saikoushiknalubola/firedamp-fd1/electronics/kicad/drc_report.txt

** Drc report for /home/claude/fd/repo/electronics/kicad/fd1_controller.kicad_pcb **
** Created on 2026-10-22 12:19:34 **

** Found 0 DRC violations **

** Found 0 unconnected pads **

** Found 0 Footprint errors **

** End of Report **
