saikoushiknalubola/firedamp-fd1/deck/Firedamp_Dynamics_Stage2_VK26-IITH-SM-0008.pdf

# VISHWAKARMA AWARDS 2026-27

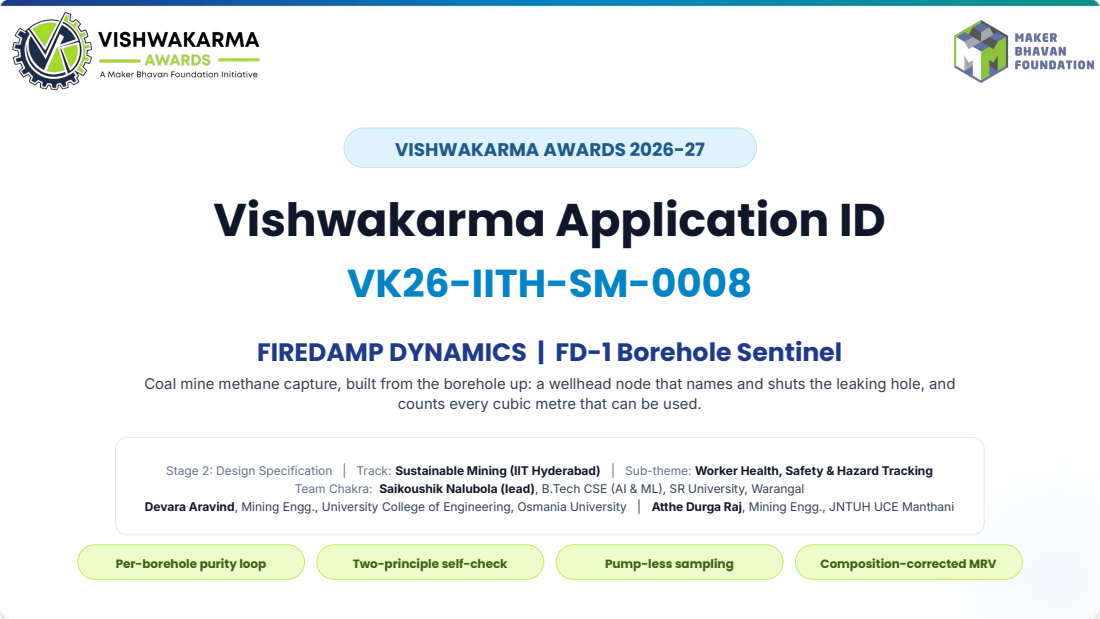
[picture p4: page 1]
Per-borehole purity loop; Two-principle self-check; Pump-less sampling; Composition-corrected MRV

Vishwakarma Application ID
VK26-IITH-SM-0008
FIREDAMP DYNAMICS | FD-1 Borehole Sentinel

Coal mine methane capture, built from the borehole up: a wellhead node that names and shuts the leaking hole, and

counts every cubic metre that can be used.

Stage 2: Design Specification | Track: Sustainable Mining (IIT Hyderabad) | Sub-theme: Worker Health, Safety & Hazard Tracking

Team Chakra: Saikoushik Nalubola (lead), B.Tech CSE (AI & ML), SR University, Warangal

Devara Aravind, Mining Engg., University College of Engineering, Osmania University | Atthe Durga Raj, Mining Engg., JNTUH UCE Manthani

# Problem Context: drained, but unverified

Project overview, the operational pain point and who carries it

### VK26-IITH-SM-0008

Per-borehole gas purity, flow and air-ingress detection that throttles or isolates the hole on its own, and logs MRV-grade methane totals.
0

commercial coal mine
methane projects
running in India

Ember, 2026

# 2.2 Mt

methane from India's
coal mines in 2025,
up from 2.0 Mt

IEA, GMT 2026

~15%

of coal methane
comes from
underground mines
making ~3.5% of coal

Ember, 2026

5-15%

methane in air is
explosive; transport
below 30% is poor
practice

UNECE BPG, 2016

# Who feels it: target beneficiary

- Primary: gas-drainage crews and ventilation officers at Degree-II and III underground mines, where DGMS requires methane drainage before mining (71 Degree-II and 7 Degree-III mines in 2015).
- First pilot region: Jharia, Raniganj and East Bokaro coalfields, home of India's only CMM pilot (Moonidih) and the Pootkee, Sawang and Chinakuri pre-feasibility studies.
- Secondary: coal companies drafting methane-reduction plans and net-zero commitments.

# Problem statement

A drainage range is only as clean as its leakiest borehole. Air drawn in at a cracked collar or a loose standpipe dilutes the gas from every hole downstream, and pushes it toward the 5-15% band where it can explode.
Mines measure methane for safety, but periodically and without an integrated real-time system. So a failing hole stays anonymous, gas nobody can vouch for gets vented instead of used, and there are no borehole-level numbers to put in a methane plan.
FD-1 gives each borehole its own instrument and its own valve.

Scope: FD-1 handles drained gas (typically 80-95% CH4 at the seam). Ventilation air methane, at under 1%, needs thermal oxidisers and is out of scope.

# Problem Context: 18 years, zero projects

Fact check: what has been tried, and the gap that is still open

### VK26-IITH-SM-0008

# What has been done (public record)

2008 India CMM/CBM Clearinghouse set up at CMPDI, Ranchi, with US EPA support. CMPDI is the nodal agency for CMM.

Pilot | Moonidih underground mine, Jharia: capture and use shown to be technically feasible. No commercial project followed.
Studies | Pre-feasibility studies at Pootkee, Sawang and Chinakuri collieries.

2019 Revised rules: Degree-III mining enterprises to prepare CMM reduction plans.

2025 Large coal companies asked to submit net-zero commitments by end-2025.

2026 Still no national MRV framework; India's CMM estimates disagree by more than 3x.

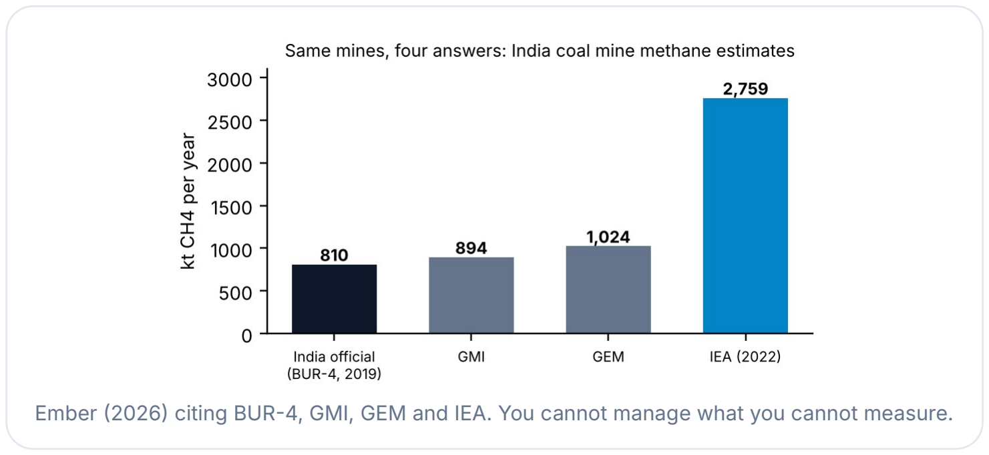
[picture p5: figure]

Ember (2026) citing BUR-4, GMI, GEM and IEA. You cannot manage what you cannot measure.

# Public search disclosure

- Mine-air monitors: protect the workings; they cannot say which borehole is leaking into the range.
- Catalytic (pellistor) heads: need oxygen and are made for the LEL range, not 0-100% vol drainage gas.
- Gap: no Indian-made unit we could find measures purity, flow and air ingress at each borehole and acts on it. Patent search is a Stage 3 deliverable.

Why the gap persists: Ember (2026) names missing policy, missing incentives and missing data. FD-1 attacks the one an engineering team can fix: data at the borehole.

# The Firedamp System: where FD-1 fits

Our Stage 1 concept stays the vision. FD-1 is the module we build first, because every other stage depends on it.

### VK26-IITH-SM-0008

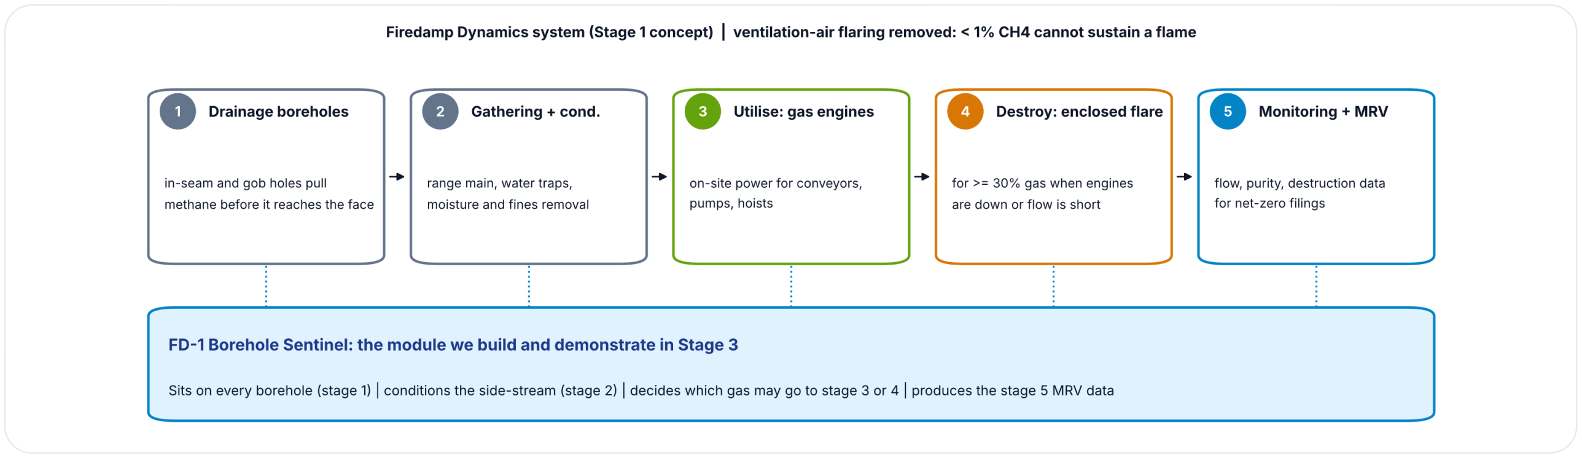
[picture p6: figure]
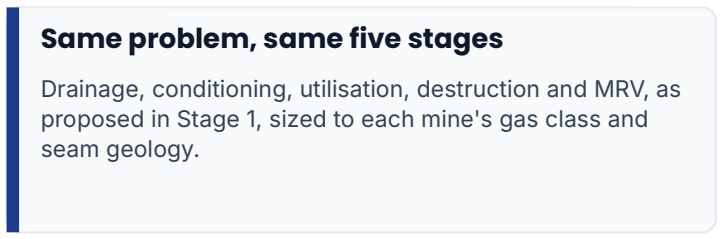
[picture p7: figure]
Same problem, same five stages; seam geology.

Drainage, conditioning, utilisation, destruction and MRV, as proposed in Stage 1, sized to each mine's gas class and

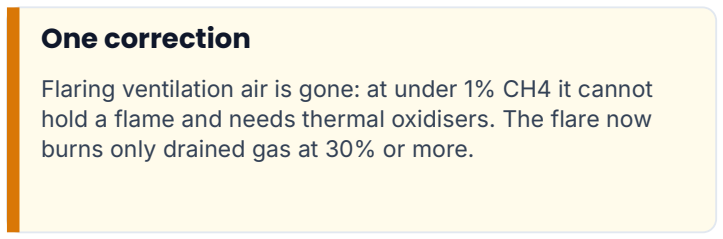
[picture p8: figure]
One correction; burns only drained gas at 30% or more.

Flaring ventilation air is gone: at under 1% CH4 it cannot hold a flame and needs thermal oxidisers. The flare now

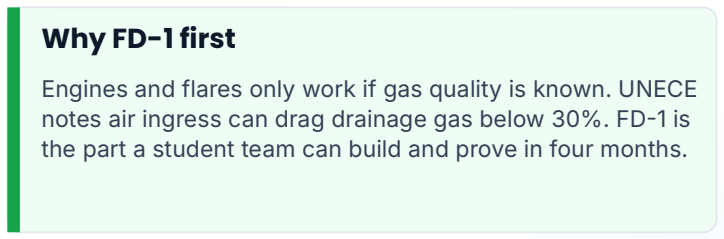
[picture p9: figure]
Why FD-1 first

Engines and flares only work if gas quality is known. UNECE notes air ingress can drag drainage gas below 30%. FD-1 is the part a student team can build and prove in four months.

Roadmap continuity: The Stage 1 plan holds: pilot cluster at 9-18 months, MRV record at 18-30, replication after 30. FD-1 is the instrument each phase needs.

# User Journey: the before state

Current pain points, mapped step by step and benchmarked

### VK26-IITH-SM-0008

432 Nm3

CH4 vented per day by one borehole draining 0.3 m3/min of methane (illustrative)

our calc, analysis/gas_calcs.py

# 24.8 t

CO2e per day from that one hole at a 20-year GWP of 80

our calc; GWP framing per Ember/IEA

# 1,504 kWh

electricity per day left unmade, at 35% gas-engine efficiency

our calc, stated assumptions

$13.3 bn

India's bill for ~31 bcm of imported gas in FY2023-24

Ember, 2026

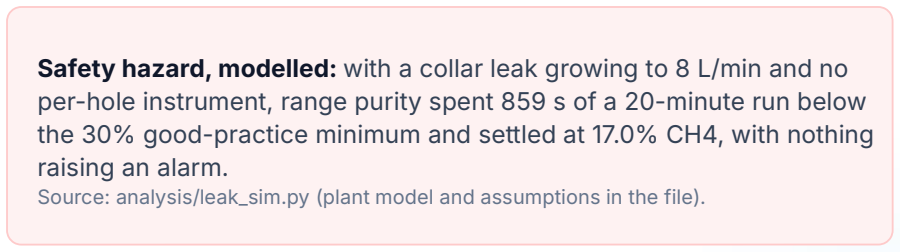
[picture p10: figure]
raising an alarm.

Safety hazard, modelled: with a collar leak growing to 8 L/min and no per-hole instrument, range purity spent 859 s of a 20-minute run below the 30% good-practice minimum and settled at 17.0% CH4, with nothing

Source: analysis/leak_sim.py (plant model and assumptions in the file).

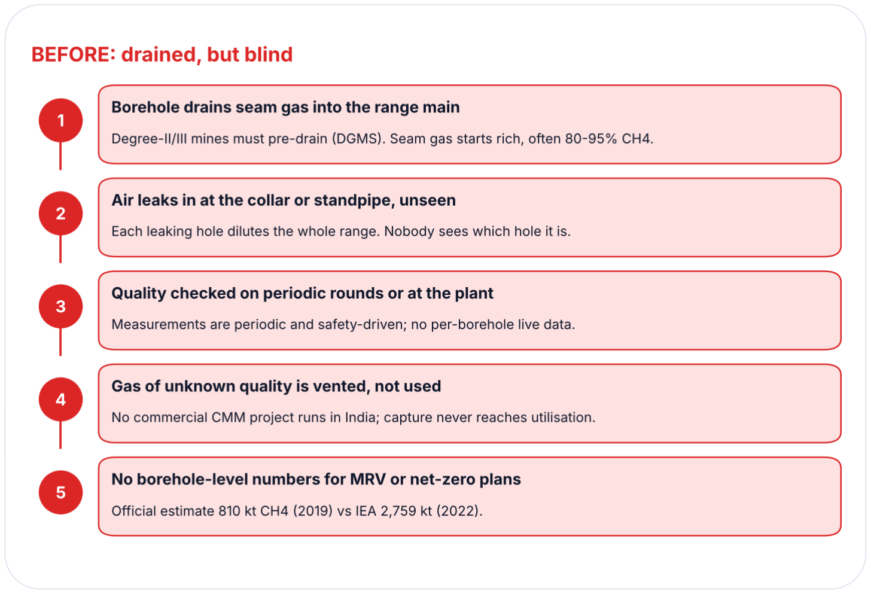
[picture p11: figure]

Bottom line: The gas is drilled for, piped and paid for, then thrown away because no one can prove which holes are good.

# User Journey: the after state

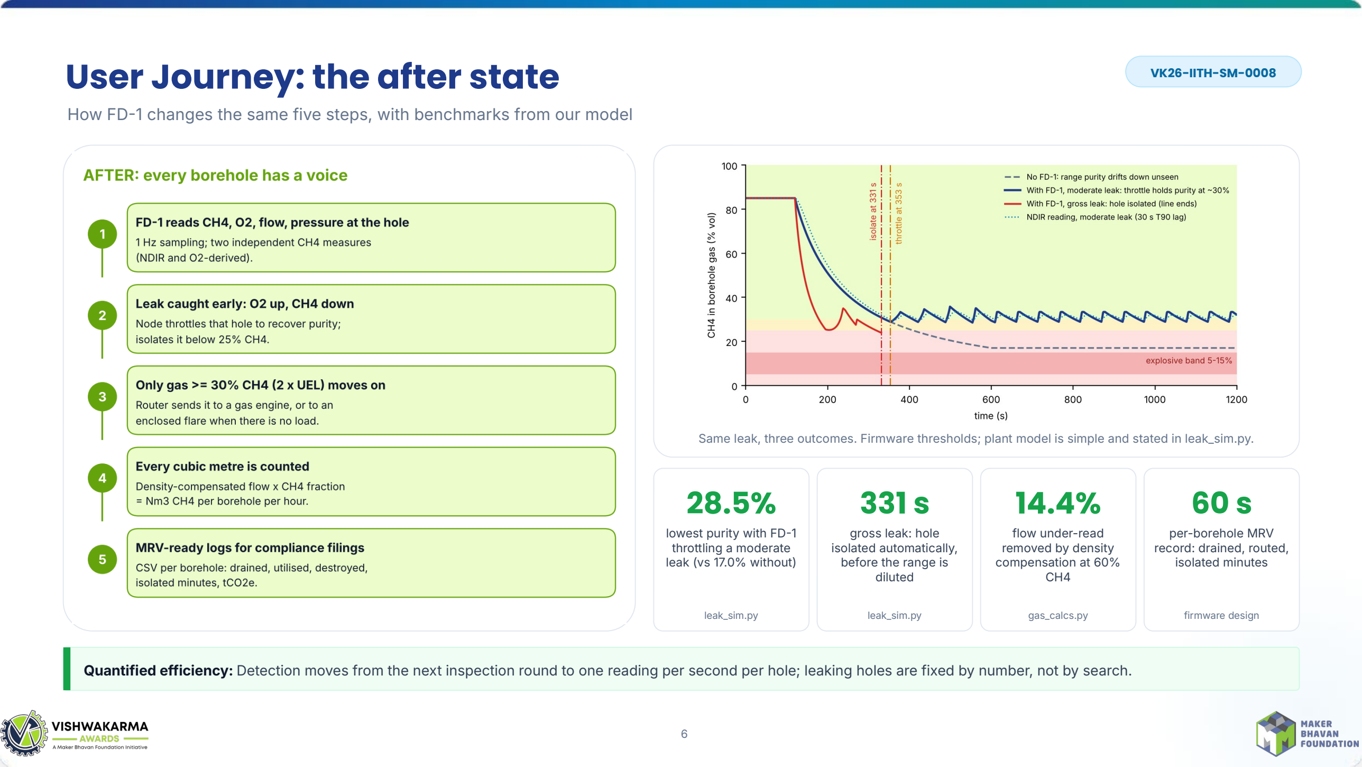
[picture p12: page 6]

How FD-1 changes the same five steps, with benchmarks from our model

### VK26-IITH-SM-0008

Same leak, three outcomes. Firmware thresholds; plant model is simple and stated in leak_sim.py.
28.5%

lowest purity with FD-1
throttling a moderate
leak (vs 17.0% without)

leak_sim.py

331 s

gross leak: hole
isolated automatically,
before the range is
diluted

leak_sim.py

14.4%

flow under-read
removed by density
compensation at 60%
CH4

gas_calcs.py

# 60 s

per-borehole MRV
record: drained, routed,
isolated minutes

firmware design

Quantified efficiency: Detection moves from the next inspection round to one reading per second per hole; leaking holes are fixed by number, not by search.

# Innovation & Patentability

What FD-1 does that today's practice does not

### VK26-IITH-SM-0008

Capability | Portable detector rounds | Monitoring at the extraction plant | FD-1 at every borehole
Names the leaking borehole | only if the round reaches it | no, one combined stream | yes, per hole, every second
Live drainage-gas purity | no | yes, combined | yes, per hole
Acts on its own | no | plant-level trips | throttles or isolates the hole
Checks its own sensors | no | depends on system | NDIR vs O2 cross-check
Per-borehole MRV totals | no | no | Nm3 CH4 drained and routed

Typical practice as we understand it from public sources; to be validated with mine engineers.

Each hole holds its own gas above 30% by trimming its suction, instead of the whole range being diluted by one bad collar.

Seam gas carries almost no oxygen, so CH4 is also 1 - O2/20.95. If NDIR and this estimate disagree by 5 points, the node fails closed.

The metering orifice's own pressure drop pushes gas through the sensing chamber. No sample pump to fail underground.

Flow is corrected with the measured mixture density, removing a 14.4%

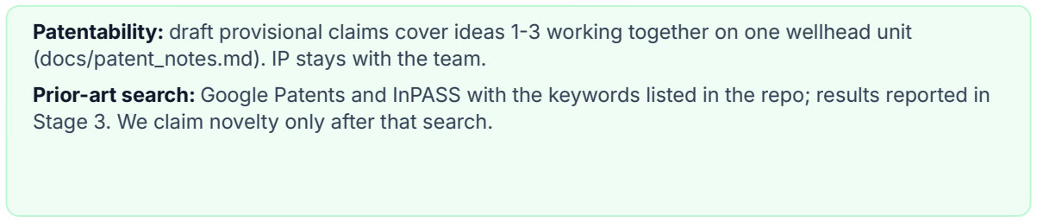
[picture p13: figure]

under-read at 60% CH4. Patentability: draft provisional claims cover ideas 1-3 working together on one wellhead unit (docs/patent_notes.md). IP stays with the team.
Prior-art search: Google Patents and InPASS with the keywords listed in the repo; results reported in
Stage 3. We claim novelty only after that search.

Why it matters: Engines need gas they can trust and regulators need numbers they can audit. FD-1 produces both at the point where the gas is born.

# System Architecture: block diagram

Four subsystems: mechanical gas path, actuation and power, electronic control, firmware and data

### VK26-IITH-SM-0008

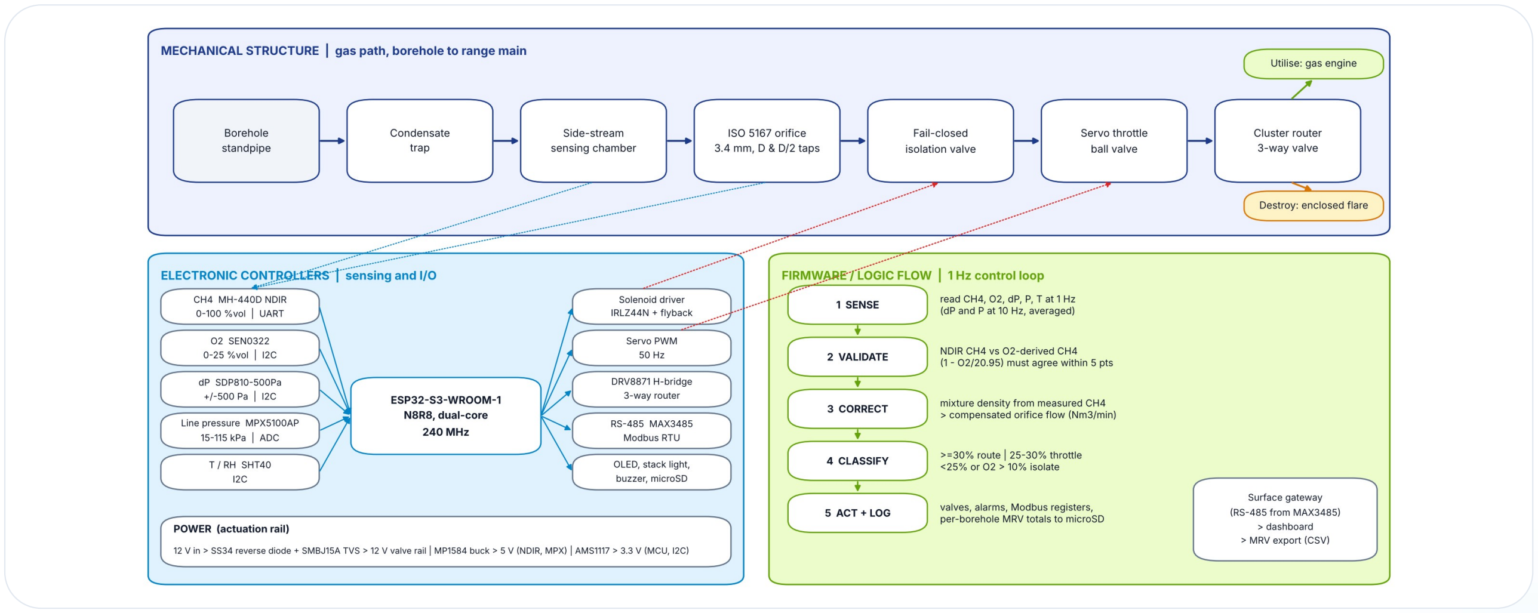
[picture p14: figure]

Architecture rationale: RS-485 Modbus RTU over Wi-Fi or LoRa: radio does not carry reliably through strata, and a twisted pair runs up to 1,200 m with no gateway underground.

# Target Specs & Hardware Selection

Every target maps to a named part and protocol. Bench values unless marked field.

### VK26-IITH-SM-0008

Parameter | Target spec | Selected hardware / protocol
Methane | 0-100 %vol, T90 < 30 s | Winsen MH-440D NDIR, UART + 0.4-2.0 V analog
Oxygen (air-ingress signal) | 0-25 %vol | DFRobot SEN0322 electrochemical, I2C 0x73
Flow | 0.5-6 L/min bench, +/-5% after calibration | ISO 5167 orifice, 3.4 mm bore (beta 0.215) + Sensirion SDP810-500Pa
Line pressure | 15-115 kPa absolute | NXP MPX5100AP, ADC via 10k/18k divider
Decision loop | 1 Hz decisions, 10 Hz dP and pressure | ESP32-S3-WROOM-1-N8R8, dual core 240 MHz
Isolation | < 1 s to closed, closes on power loss | 12 V NC direct-acting solenoid, IRLZ44N low-side
Purity bands | >= 30% route | 25-30% throttle | < 25% isolate | firmware config.h (UNECE: 2 x UEL = 30%)
Sensor cross-check | NDIR vs O2-derived CH4 within 5 points | two measuring principles, FAULT if they disagree
Comms | Modbus RTU 19.2 kbps, up to 1,200 m | MAX3485, 120 ohm termination
Power | 12 V DC, <= 3 W average, <= 15 W at valve stroke | SS34 + SMBJ15A, MP1584 5 V, AMS1117 3.3 V
Data | 30 days of 1-minute MRV records | microSD over SPI, CSV export via gateway
Enclosure | IP65 bench | Ex d or Ex ia, Group I (field) | ABS/PC 200x120x75 mm, PG7 glands

Selection logic: NDIR, not catalytic, because drainage gas sits far above the LEL and may be oxygen-poor. The O2 cell is the second opinion and the leak detector.

# Working Process: one decision per second

Where the gas sits on the explosibility diagram decides what the valves do

### VK26-IITH-SM-0008

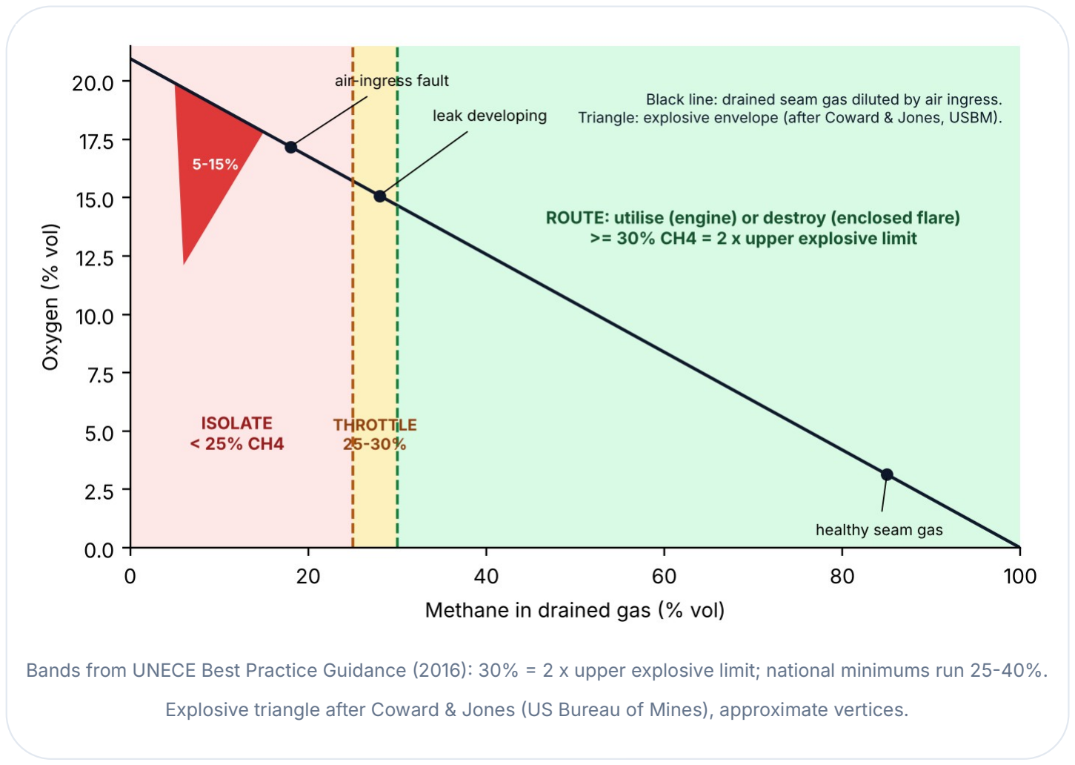
[picture p15: figure]

Bands from UNECE Best Practice Guidance (2016): 30% = 2 x upper explosive limit; national minimums run 25-40%. Explosive triangle after Coward & Jones (US Bureau of Mines), approximate vertices.

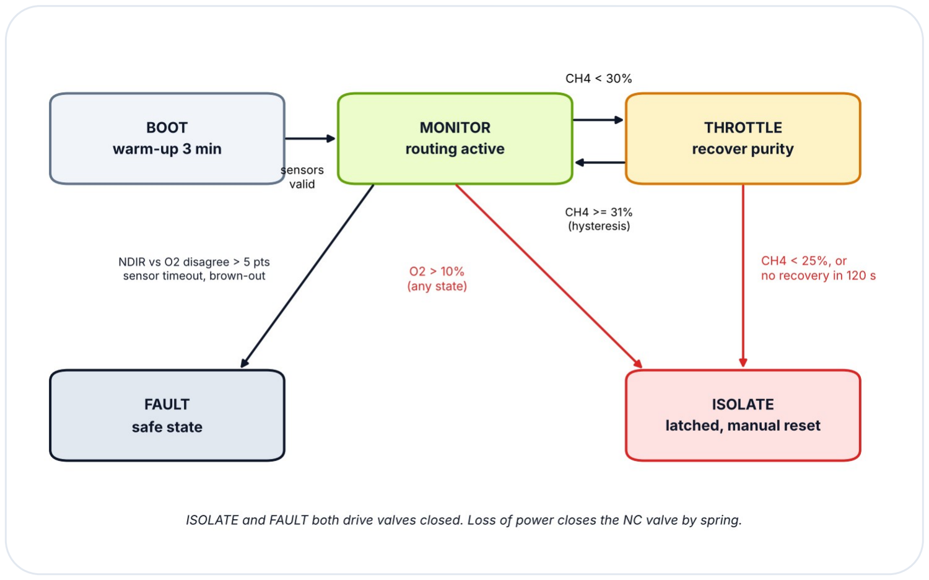
[picture p16: figure]
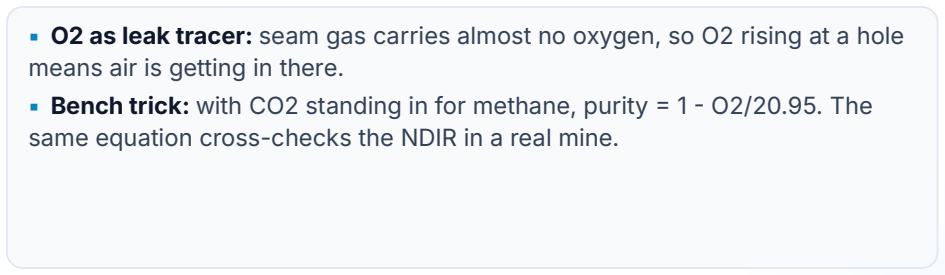
[picture p17: figure]
means air is getting in there.

- O2 as leak tracer: seam gas carries almost no oxygen, so O2 rising at a hole
- Bench trick: with CO2 standing in for methane, purity = 1 - O2/20.95. The same equation cross-checks the NDIR in a real mine.

Fail-safe default: Any doubt ends in a closed valve: stale sensor, disagreement between sensors, brown-out or firmware hang.

# CAD Design: assembly and exploded view

Parametric CadQuery model; 24 parts exported as STEP and STL in the repo

### VK26-IITH-SM-0008

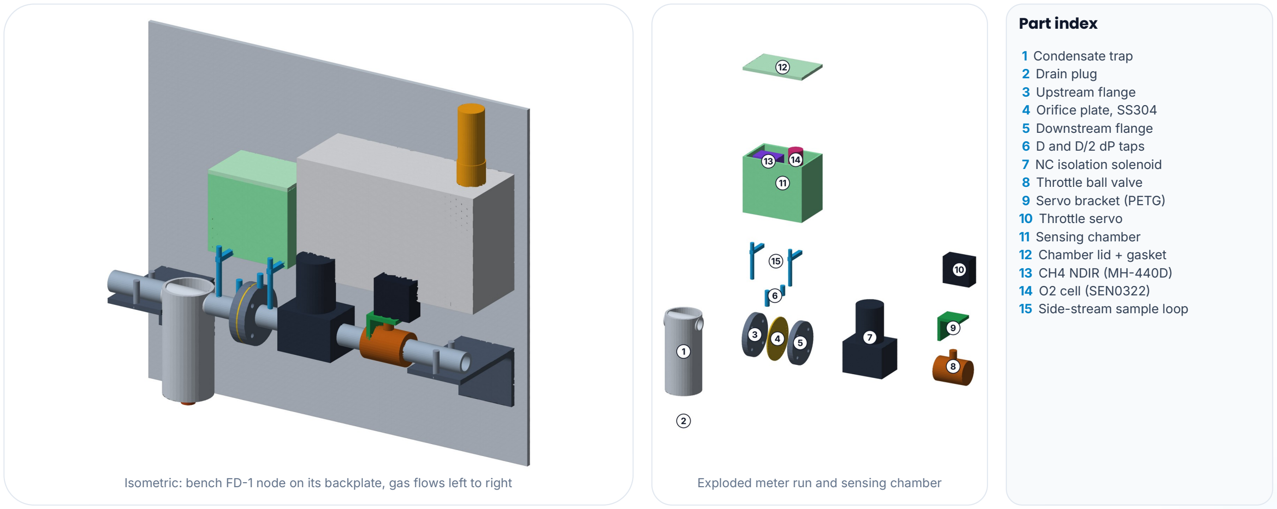
[picture p18: figure]
Part index; 1 Condensate trap 2 Drain plug 3 Upstream flange 4 Orifice plate, SS304 5 Downstream flange 6 D and D/2 dP taps 7 NC isolation solenoid 8 Throttle ball valve 9 Servo bracket (PETG) 10 Throttle servo 11 Sensing chamber 12 Chamber lid + gasket 13 CH4 NDIR (MH-440D) 14 O2 cell (SEN0322) 15 Side-stream sample loop

Isometric: bench FD-1 node on its backplate, gas flows left to right | Exploded meter run and sensing chamber

Key mechanism: The orifice pressure drop drives the side-stream through the sensing chamber, so the node needs no sample pump.

# Mechanical Specs: materials and FEA

Material choices, FEA of the pipe bracket, and hand checks on the pressure parts

### VK26-IITH-SM-0008

Part | Bench material | Why | Field change
Orifice plate | SS304, 1.5 mm | sharp edge stays sharp in wet, acidic gas | same
Flanges, brackets | Al 6061-T6 | machinable, light, quick to iterate | SS304 / mild steel*
Sensing chamber | PETG, 3 mm wall | printable, inert to CH4 and CO2 | SS304 machined
Enclosure | ABS/PC, IP65 | cheap, sealed, see-through window | Ex d cast enclosure

*IEC 60079-0 limits light alloys in Group I (mining) equipment because of frictional sparking. Aluminium stays on the bench.

# Validation summary

- Bracket FEA: plane stress, P2 triangles, 6,860 elements. 12 kg spool at 4 g on two brackets = 235 N each.
- Rev A: 4 mm plate, 2 mm bend radius: 147.5 MPa peak, FoS 1.87 against 276 MPa yield. Below our 2.0 target.
- Rev B: 5 mm plate, 8 mm bend radius: 71.4 MPa, FoS 3.87; saddle deflection 0.71 mm.
- Chamber wall: PETG, 90x80 mm, 3 mm, -30 kPa, fixed edges (Roark): about 7.6 MPa and 0.37 mm. FoS ~6.

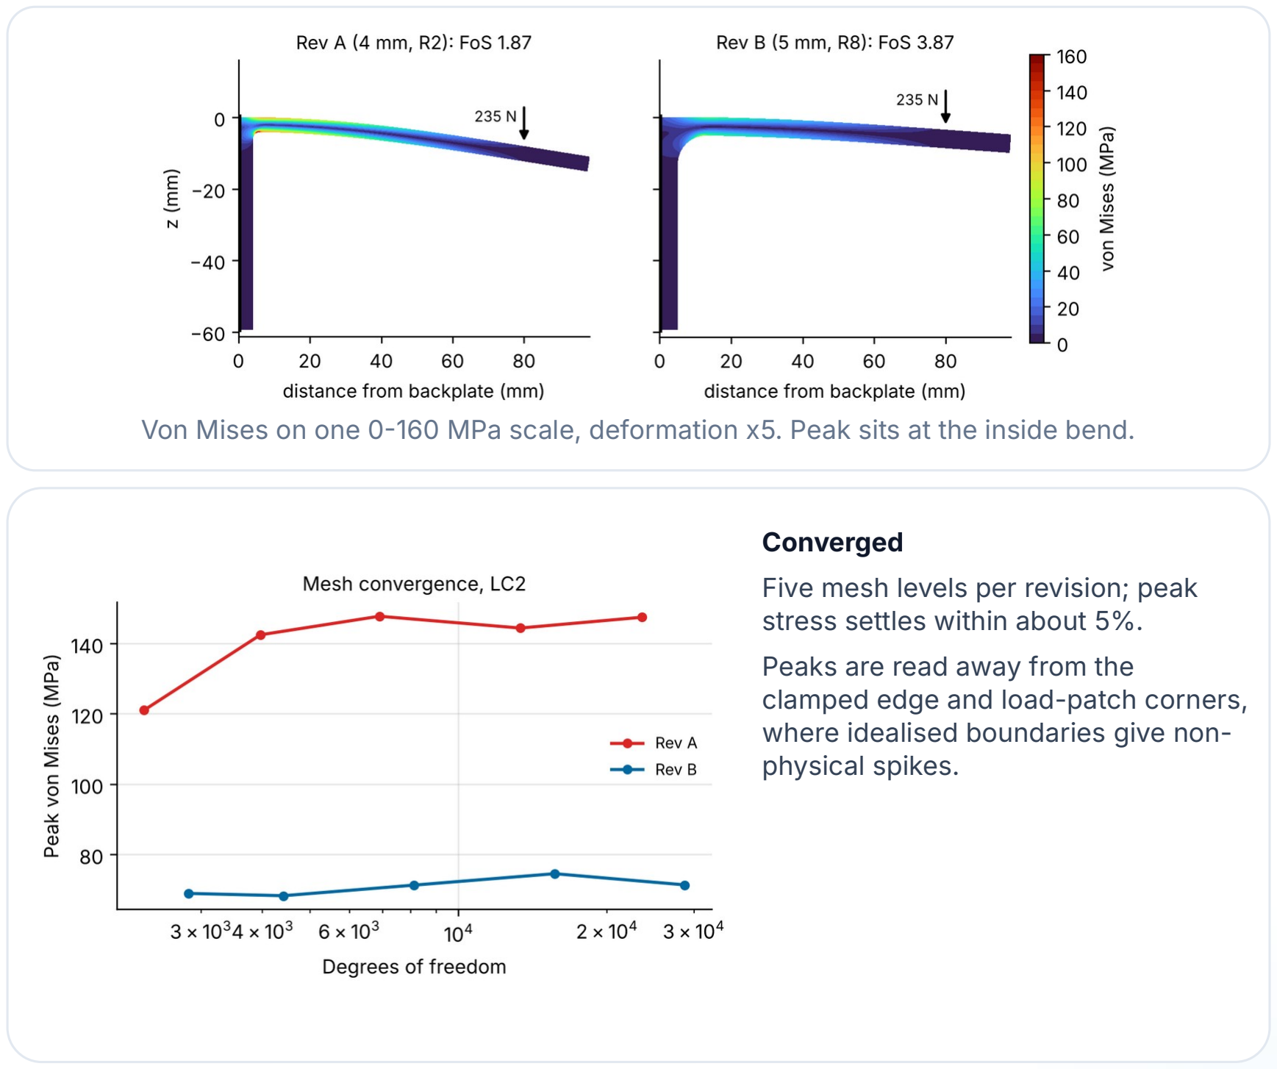
[picture p19: figure]
Converged Five mesh levels per revision; peak stress settles within about 5%. Peaks are read away from the clamped edge and load-patch corners, where idealised boundaries give non- physical spikes.

Von Mises on one 0-160 MPa scale, deformation x5. Peak sits at the inside bend.

Design iteration: Bracket moved from rev A to rev B after FEA: one more millimetre and a larger bend radius doubled the margin (FoS 1.87 to 3.87).

# Electronics: controller schematic

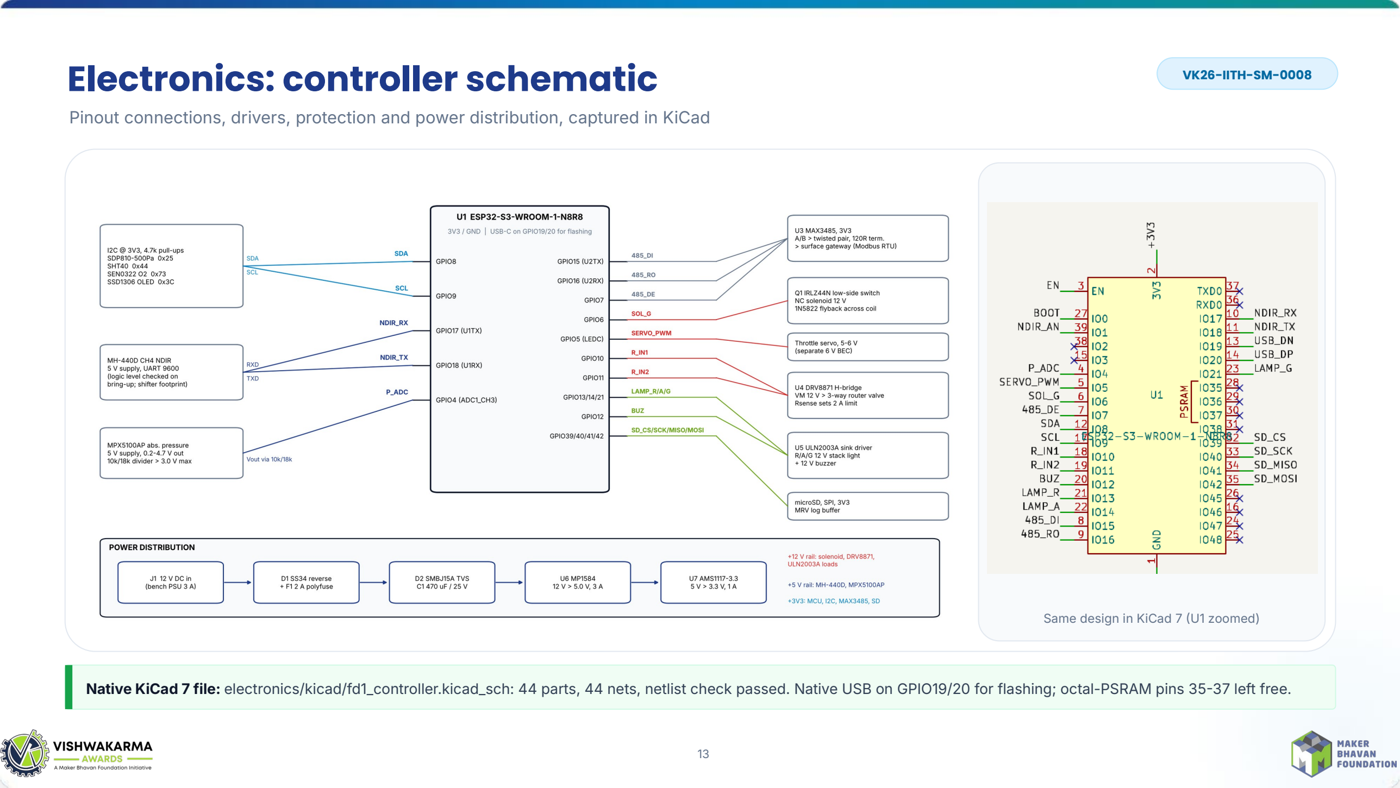
[picture p20: page 13]

Pinout connections, drivers, protection and power distribution, captured in KiCad

### VK26-IITH-SM-0008

Same design in KiCad 7 (U1 zoomed)

Native KiCad 7 file: electronics/kicad/fd1_controller.kicad_sch: 44 parts, 44 nets, netlist check passed. Native USB on GPIO19/20 for flashing; octal-PSRAM pins 35-37 left free.

# Electronics: PCB layout and DRC

## Board facts

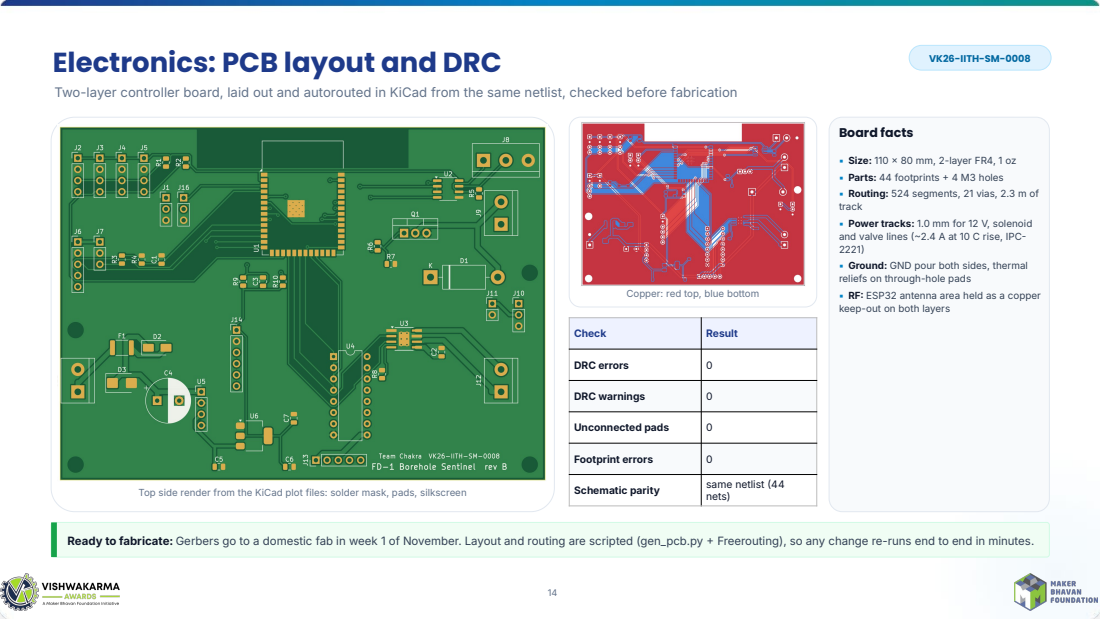
[picture p21: page 14]
VK26-IITH-SM-0008

Two-layer controller board, laid out and autorouted in KiCad from the same netlist, checked before fabrication

▪ Size: 110 x 80 mm, 2-layer FR4, 1 oz
▪ Parts: 44 footprints + 4 M3 holes
▪ Routing: 524 segments, 21 vias, 2.3 m of
track
▪ Power tracks: 1.0 mm for 12 V, solenoid
and valve lines (~2.4 A at 10 C rise, IPC-
▪ Ground: GND pour both sides, thermal
reliefs on through-hole pads
▪ RF: ESP32 antenna area held as a copper
keep-out on both layers

Copper: red top, blue bottom

Check | Result

DRC errors | 0

DRC warnings | 0

Unconnected pads | 0

Footprint errors | 0

Schematic parity | same netlist (44 nets)

Top side render from the KiCad plot files: solder mask, pads, silkscreen

Ready to fabricate: Gerbers go to a domestic fab in week 1 of November. Layout and routing are scripted (gen_pcb.py + Freerouting), so any change re-runs end to end in minutes.

# Electronics: itemised prototype BOM

Stage 3 build: one complete FD-1 node plus the bench rig. Approximate quotes, INR incl. GST, October 2026.

### VK26-IITH-SM-0008

Item | Part | Qty | Cost (Rs) | Price basis
CH4 sensor | Winsen MH-440D NDIR, 0-100 %vol | 1 | 12,900 | Winsen store: $235 per 2 pcs; x Rs 95.5/$ x 1.15 landed
O2 sensor | DFRobot SEN0322 Gravity I2C (ME2-O2 cell) | 1 | 4,900 | Core Electronics A$88.53, converted; Indian distributors similar
Differential pressure | Sensirion SDP810-500Pa, I2C | 1 | 4,170 | Lion Circuits listing Rs 4,168.87
Line pressure | MPX5100AP, 15-115 kPa abs | 1 | 1,500 | estimate from distributor list (~$15)
MCU | ESP32-S3-WROOM-1-N8R8 module (on our PCB) | 1 | 800 | Lion Circuits listing Rs 800.38
PCB | 2-layer FR4 1.6 mm, 110 x 80 mm, 5 pcs | 1 | 2,200 | estimate, domestic fab incl. shipping
ICs + discretes | MAX3485, DRV8871, ULN2003A, IRLZ44N, AMS1117, MP1584 module, SS34, SMBJ15A, polyfuse, 0805 R/C | 1 | 950 | estimate, robu.in / local market
Isolation valve | 12 V NC direct-acting (zero differential) solenoid, 1/2" brass | 1 | 1,500 | estimate; zero-diff 1/2" valves list near Rs 1,289 (Robocraze, NO type)
Throttle | 1/2" brass ball valve + MG996R servo + printed bracket | 1 | 700 | estimate, local
Rest of node | connectors, OLED, tower lamp, buzzer, microSD, IP65 enclosure, orifice plate + flanges, PETG parts, frame | | 5,780 | local estimates (bom.csv)
Node subtotal | | 1 | 35,400
Bench rig | CO2 cylinder + regulator, rotameter, needle valves, vacuum pump, pipework, 12 V PSU + e-stop, 2.5% CH4 span gas | | 13,000 | local estimates; span gas free if borrowed
Stage 3 total | | | 48,400 | line-by-line: electronics/bom.csv

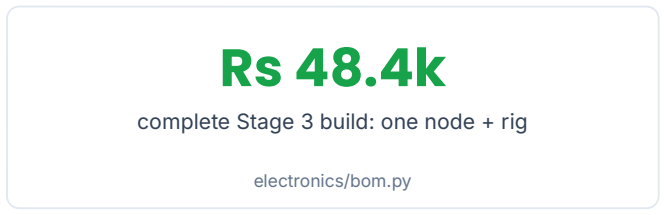
[picture p22: figure]
complete Stage 3 build: one node + rig; electronics/bom.py

## Where we cut cost

- One NDIR, not two: the MH-440D is 36% of node cost. Node #2 runs O2-derived purity on the CO2 bench.
- Own PCB, bare module: ESP32-S3 module at Rs 800 instead of a Rs 1,850 dev board.
- Kept the SDP810: a cheaper dP sensor's +/-50 Pa error would swamp our 200 Pa signal.
- Paid for the right valve: Rs 400 pilot valves need 0.02 MPa to open, so they stay shut on a vacuum line. We specify a direct-acting valve.

December add-ons: Node #2 about Rs 20,000 and the 3-way router valve about Rs 2,800. Imported parts ordered in week 1; invoices replace these quotes.

# Your Maker Journey: on the bench

## Stage 1 to Stage 2 engineering pivots

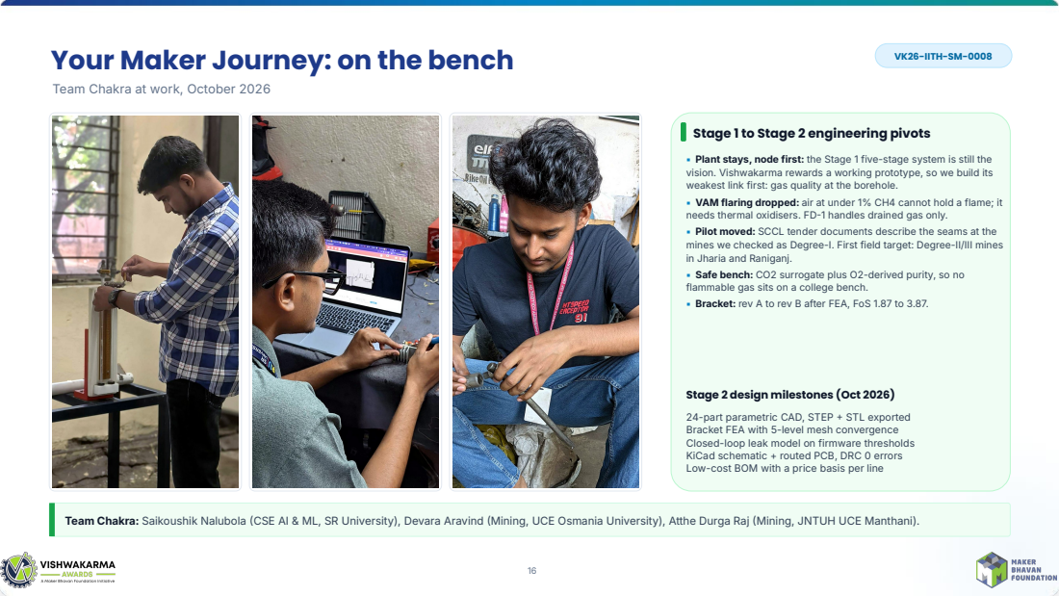
[picture p23: page 16]
VK26-IITH-SM-0008

Team Chakra at work, October 2026

▪ Plant stays, node first: the Stage 1 five-stage system is still the
vision. Vishwakarma rewards a working prototype, so we build its
weakest link first: gas quality at the borehole.
▪ VAM flaring dropped: air at under 1% CH4 cannot hold a flame; it
needs thermal oxidisers. FD-1 handles drained gas only.
▪ Pilot moved: SCCL tender documents describe the seams at the
mines we checked as Degree-I. First field target: Degree-II/III mines
in Jharia and Raniganj.
▪ Safe bench: CO2 surrogate plus O2-derived purity, so no
flammable gas sits on a college bench.
▪ Bracket: rev A to rev B after FEA, FoS 1.87 to 3.87.

Stage 2 design milestones (Oct 2026)

24-part parametric CAD, STEP + STL exported
Bracket FEA with 5-level mesh convergence
Closed-loop leak model on firmware thresholds
KiCad schematic + routed PCB, DRC 0 errors
Low-cost BOM with a price basis per line

Team Chakra: Saikoushik Nalubola (CSE AI & ML, SR University), Devara Aravind (Mining, UCE Osmania University), Atthe Durga Raj (Mining, JNTUH UCE Manthani).

# Your Maker Journey: design evidence

Original design assets and the raw repository

### VK26-IITH-SM-0008

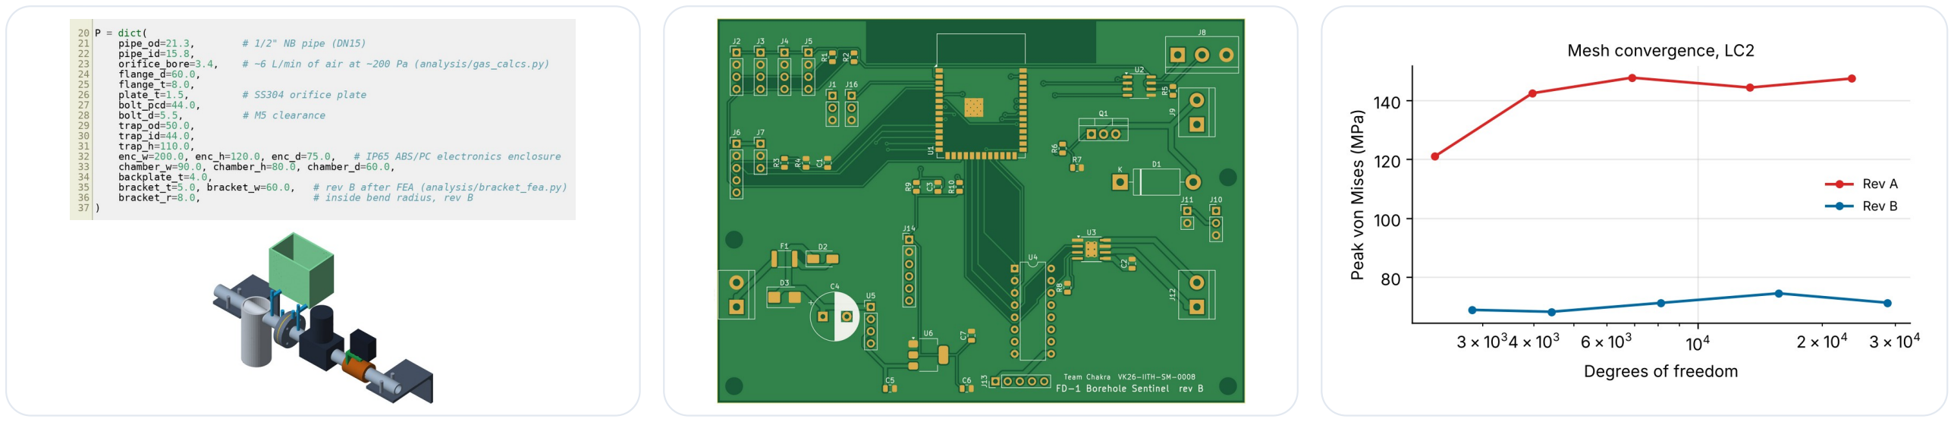
[picture p24: figure]

CAD: parameter block drives all 24 parts (fd1_assembly.py) | EDA: KiCad 7 schematic + routed PCB, DRC 0 errors | FEA convergence; mesh 3,754 nodes / 6,860 elements (rev B)

# Raw repository linkage

Repository: github.com/saikoushiknalubola/firedamp-fd1
Native files: cad/step/*.step (24 parts + assembly), cad/stl, cad/src (parametric model), electronics/kicad (native .kicad_sch + .kicad_pcb, netlist, DRC report), electronics/ (pin map, BOM), firmware/fd1_node (ESP32 code), analysis/ (FEA, orifice, leak model).
Audit trail: every figure in this deck is built from files in the repo, so commit timestamps trace the work through Stage 2. No embedded videos.

Next: Gerbers to fab and imported sensors ordered in week 1 of November; firmware drivers replace the bring-up stubs.

# Safety & Hazard Mitigation

Physical fail-safes, design FMEA and the standards that shape the field version

### VK26-IITH-SM-0008

Failure mode | Potential hazard | Embedded fail-safe / mitigation
Air ingress at collar or standpipe | range gas drifts toward 5-15% | throttle that hole; isolate below 25% CH4 or above 10% O2 (latched)
NDIR drift or failure | wrong routing decision | O2-derived cross-check; > 5 points apart = FAULT, valve closed; span check with 2.5% CH4 gas
Loss of 12 V / brown-out | valves left in unknown state | NC solenoid spring-closes; MCU brown-out reset restarts in BOOT (closed)
Firmware hang | valve stuck open | hardware watchdog resets to closed state within 3 s
Water slug in the line | flooded sensors, false readings | condensate trap with drain; hydrophobic PTFE filter on sample inlet
Flame front in pipeline (field) | propagation along the range | in-line flame arrestor at node outlet (UNECE protection measure)
Surface link lost | no visibility above ground | node keeps acting locally, logs to microSD, amber lamp

# Standards compliance

- IS/IEC 60079-0, -1, -11: Group I equipment: flameproof (Ex d) and intrinsic safety (Ex ia) path
- IEC 60079-29-1: performance of flammable gas detectors
- ISO 5167-2: orifice plates, D and D/2 tappings
- IEC 60529: IP65 enclosure, PG7 glands
- Coal Mines Regulations 2017: DGMS approval before any equipment goes underground
- UNECE BPG (2016): 30% minimum for transport and use

Physical fail-safes: Emergency stop on the bench rig cuts 12 V; the bench prototype is not certified and will not be taken underground.

# Impact & Commercial Viability

Size of the problem, value of one borehole, and what a node costs

### VK26-IITH-SM-0008

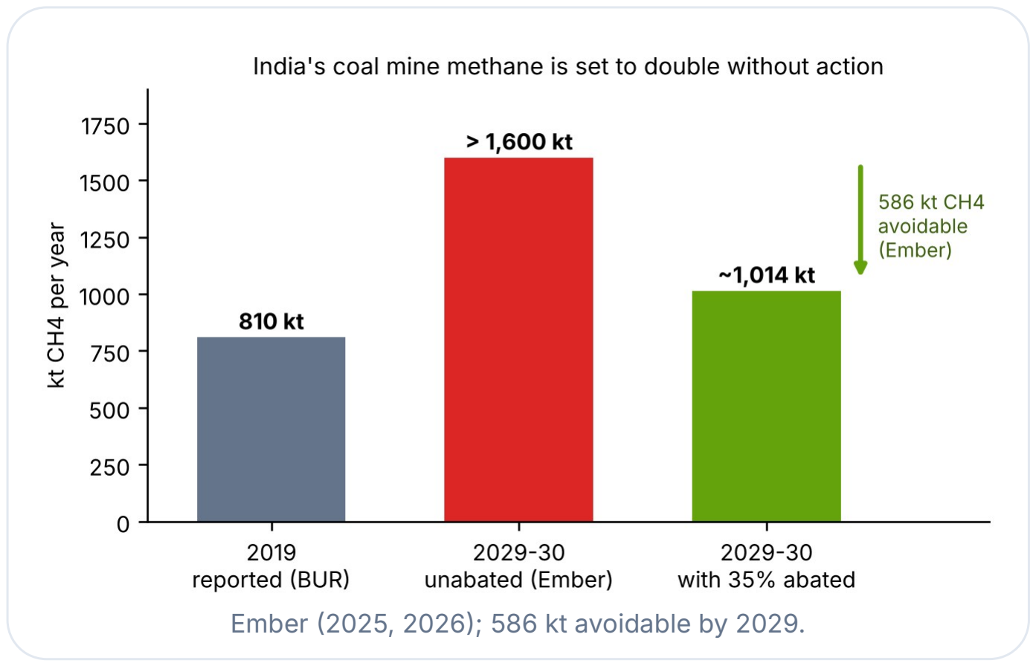
[picture p25: figure]
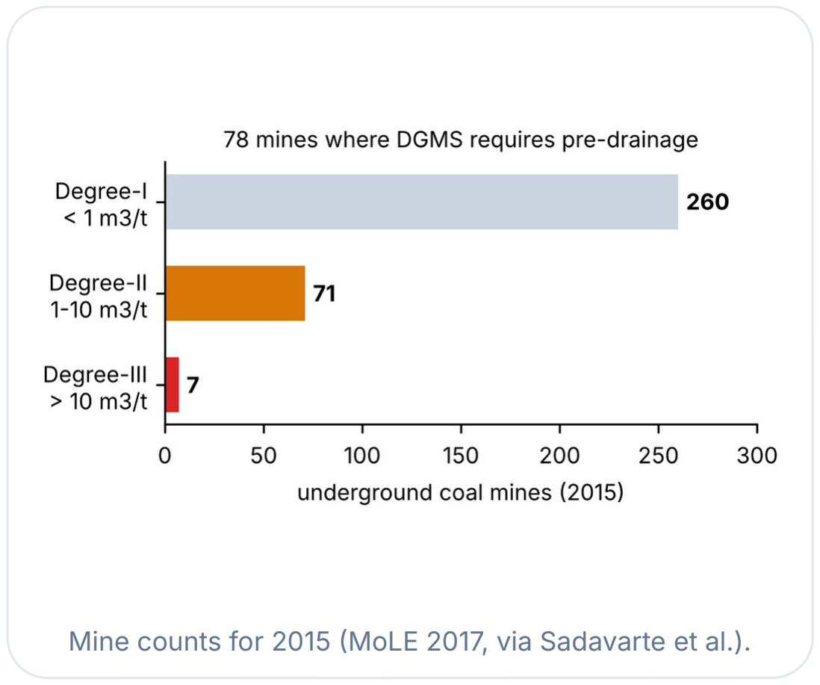
[picture p26: figure]

Ember (2025, 2026); 586 kt avoidable by 2029. | Mine counts for 2015 (MoLE 2017, via Sadavarte et al.).

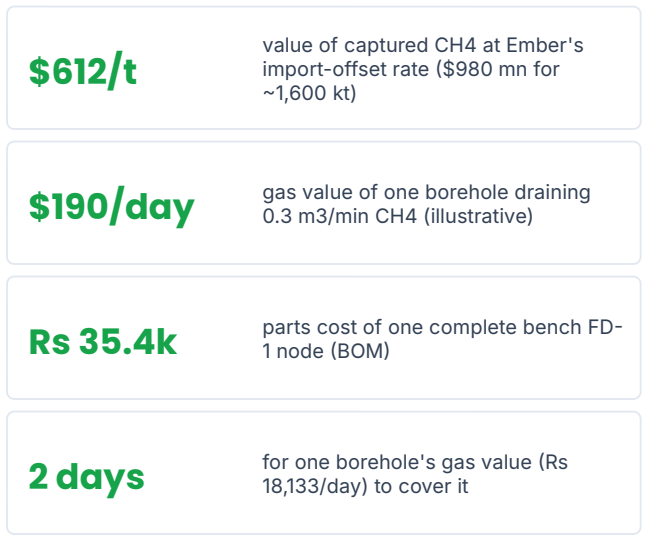
[picture p27: figure]
value of captured CH4 at Ember's; import-offset rate ($980 mn for ~1,600 kt); 0.3 m3/min CH4 (illustrative); 1 node (BOM); 2 days; for one borehole's gas value (Rs; 18,133/day) to cover it

$190/day gas value of one borehole draining

Rs 35.4k | parts cost of one complete bench FD-

# Impact by pillar

- Workers: a leaking hole is named and shut within the sensor response time, not at the next round.
- Climate: 24.8 tCO2e a day per borehole kept out of the air when its gas is used or flared (20-yr GWP).
- Energy: about 1,504 kWh a day per borehole at 35% engine efficiency, offsetting diesel and grid draw.

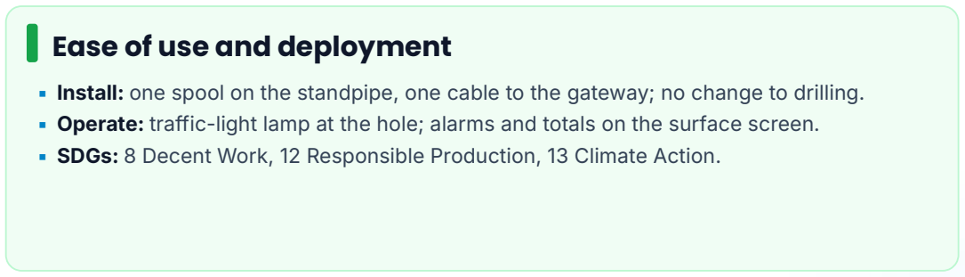
[picture p28: figure]
Ease of use and deployment

- Install: one spool on the standpipe, one cable to the gateway; no change to drilling.
- Operate: traffic-light lamp at the hole; alarms and totals on the surface screen.
- SDGs: 8 Decent Work, 12 Responsible Production, 13 Climate Action.

Field cost honesty: An Ex-certified field unit will cost far more than the bench node. Even at 10 times the bench cost, one borehole's gas covers it in about 20 days.

# Roadmap: 4-month fabrication plan

From design freeze to the IIT Hyderabad finale

### VK26-IITH-SM-0008

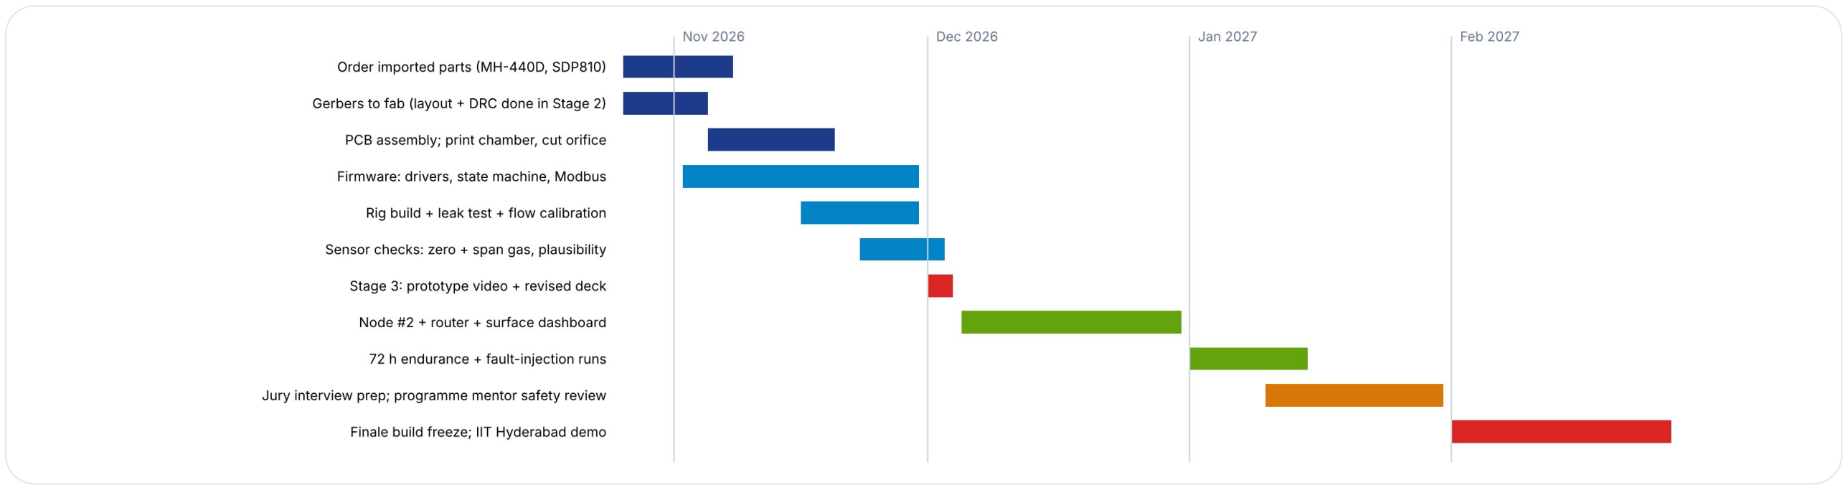
[picture p29: figure]
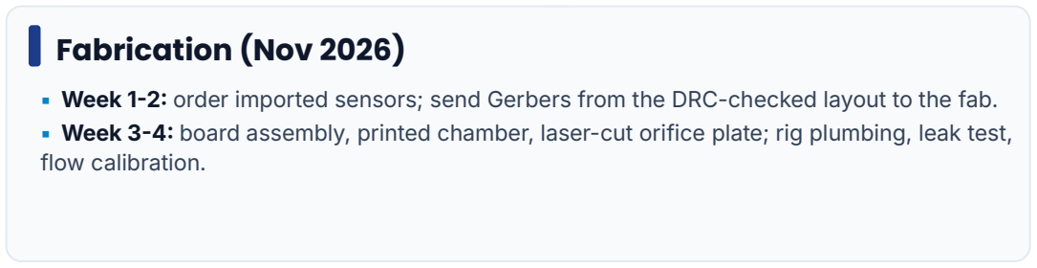
[picture p30: figure]
Fabrication (Nov 2026); flow calibration.

- Week 1-2: order imported sensors; send Gerbers from the DRC-checked layout to the fab.
- Week 3-4: board assembly, printed chamber, laser-cut orifice plate; rig plumbing, leak test,

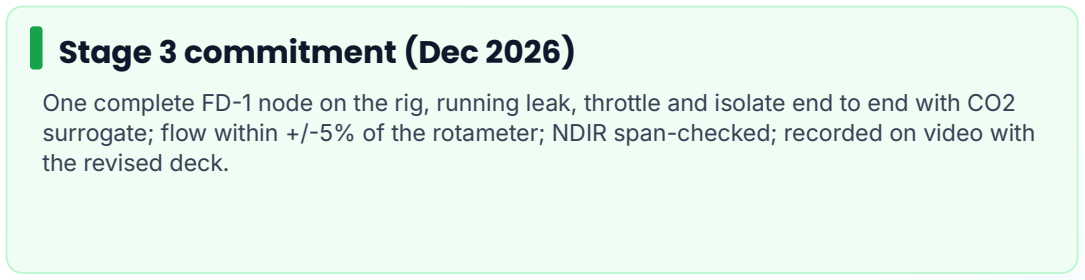
[picture p31: figure]
Stage 3 commitment (Dec 2026); the revised deck.

One complete FD-1 node on the rig, running leak, throttle and isolate end to end with CO2 surrogate; flow within +/-5% of the rotameter; NDIR span-checked; recorded on video with

After Stage 3: Second node, router and surface dashboard in December; 72-hour endurance and fault-injection runs in January; build freeze before the February finale.

# Technical Challenges & Risks

Engineering bottlenecks found in simulation and design review

### VK26-IITH-SM-0008

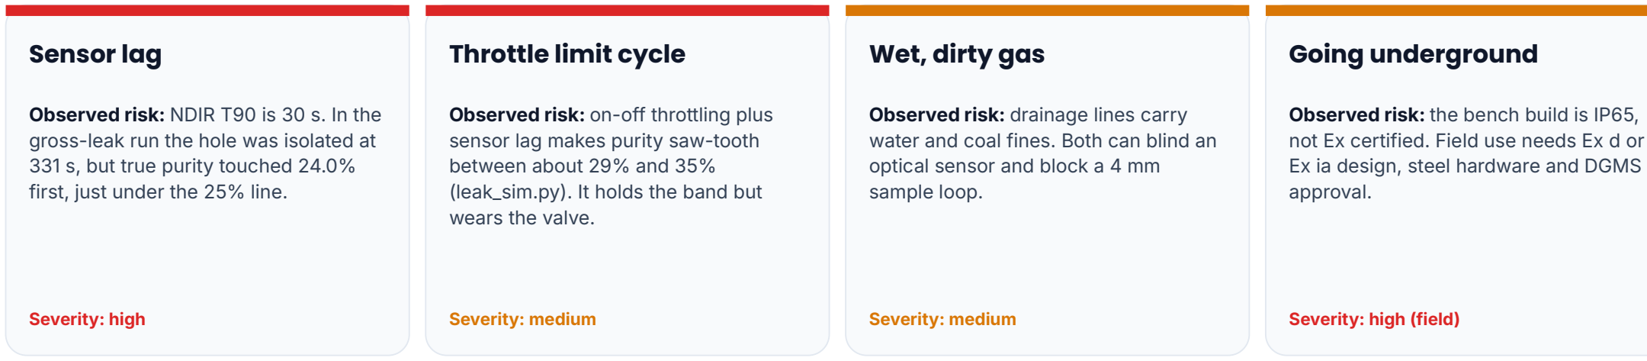
[picture p32: figure]
Sensor lag; Observed risk: NDIR T90 is 30 s. In the gross-leak run the hole was isolated at 331 s, but true purity touched 24.0% first, just under the 25% line.; Throttle limit cycle; Observed risk: on-off throttling plus sensor lag makes purity saw-tooth between about 29% and 35% (leak_sim.py). It holds the band but wears the valve.; Wet, dirty gas; Observed risk: drainage lines carry water and coal fines. Both can blind an optical sensor and block a 4 mm sample loop.; Going underground; Observed risk: the bench build is IP65,; Ex ia design, steel hardware and DGMS approval.; Severity: high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
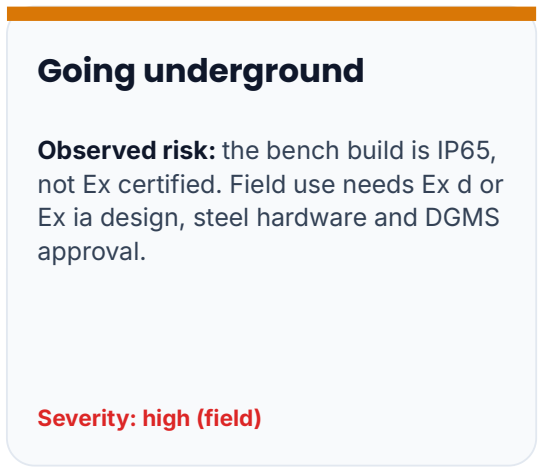
[picture p33: figure]

not Ex certified. Field use needs Ex d or

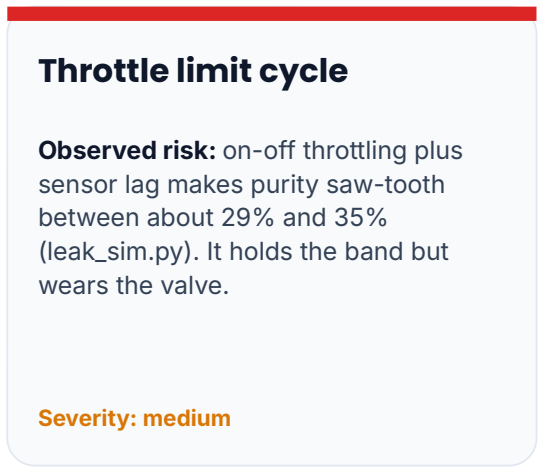
[picture p34: figure]
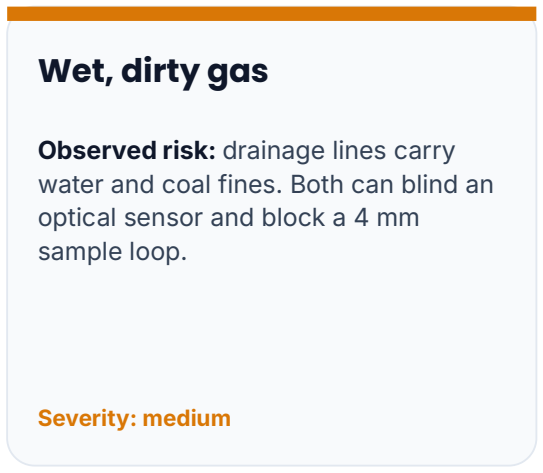
[picture p35: figure]

Risk | Likelihood | Impact | Early warning we can measure
Sensor lag lets a fast leak dip below 25% | Medium | High | dP jump with falling line vacuum ahead of NDIR change
Throttle valve wear from cycling | High | Medium | valve travel per hour logged by firmware
Water or fines reach the NDIR | Medium | Medium | NDIR vs O2 disagreement rising; condensate pot level
Field approval takes longer than the programme | High | High (field only) | none on bench; tracked as a separate path

Site data risk: No mine-level gas data yet. Bench flow ranges are set from published pre-feasibility studies until a mine shares numbers.

# Potential Solutions & Risk Mitigation

Backup technical solutions for each bottleneck

### VK26-IITH-SM-0008

# Fast leading indicator

Mitigation: suction pressure and dP sample at 10 Hz. A sudden flow rise with falling line vacuum is the leak signature, so the throttle moves before the NDIR catches up.

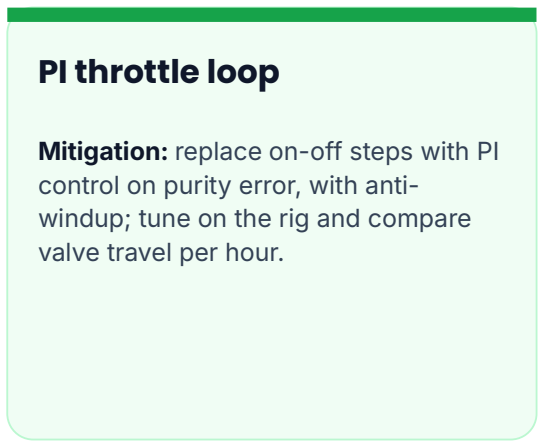
[picture p36: figure]
PI throttle loop; control on purity error, with anti- windup; tune on the rig and compare valve travel per hour.

Mitigation: replace on-off steps with PI

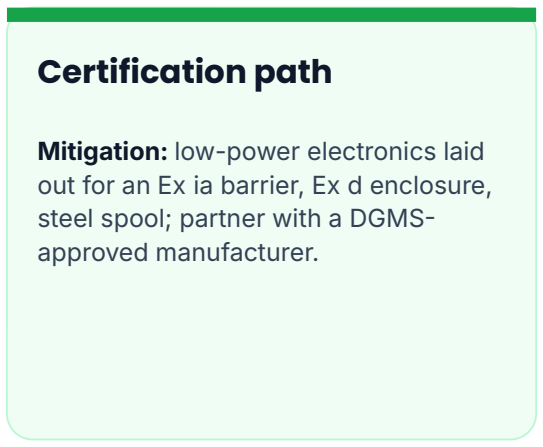
[picture p37: figure]
Certification path; Mitigation: low-power electronics laid; steel spool; partner with a DGMS- approved manufacturer.

out for an Ex ia barrier, Ex d enclosure,

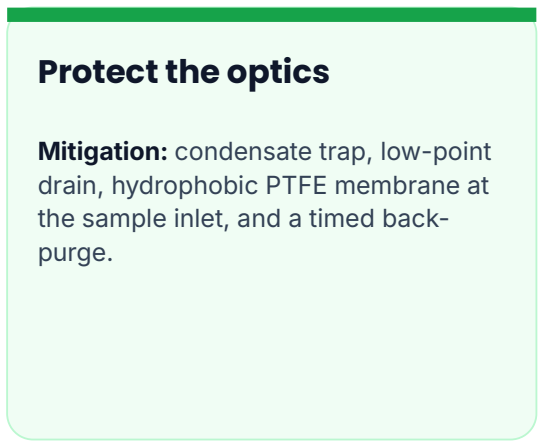
[picture p38: figure]
Protect the optics; Mitigation: condensate trap, low-point drain, hydrophobic PTFE membrane at the sample inlet, and a timed back- purge.

Mitigation | Bench test (Stage 3) | Pass criterion (target)
Fast leading indicator | step air-bleed valve open; repeat 10 times | hole isolated before true purity < 25% in 10 of 10 runs
PI throttle loop | 1 h moderate-leak run, on-off vs PI | purity held at 30% or above with at least 50% less valve travel
Protect the optics | inject a 50 mL water slug upstream | no liquid in the chamber; reading back within 2 min
Certification path | design review against IEC 60079-11 with the programme mentor | written gap list for the Ex ia version
Sensor supply fallback: a second-source 0-100 %vol NDIR module on the same UART/analog footprint. | Data fallback: Pootkee, Sawang and Chinakuri pre-feasibility reports.

Verification: Each mitigation has a bench test in the Stage 3 plan: fault injection for lag, valve-travel logging for the PI loop, water-slug test for the sample loop.

# References & Sources

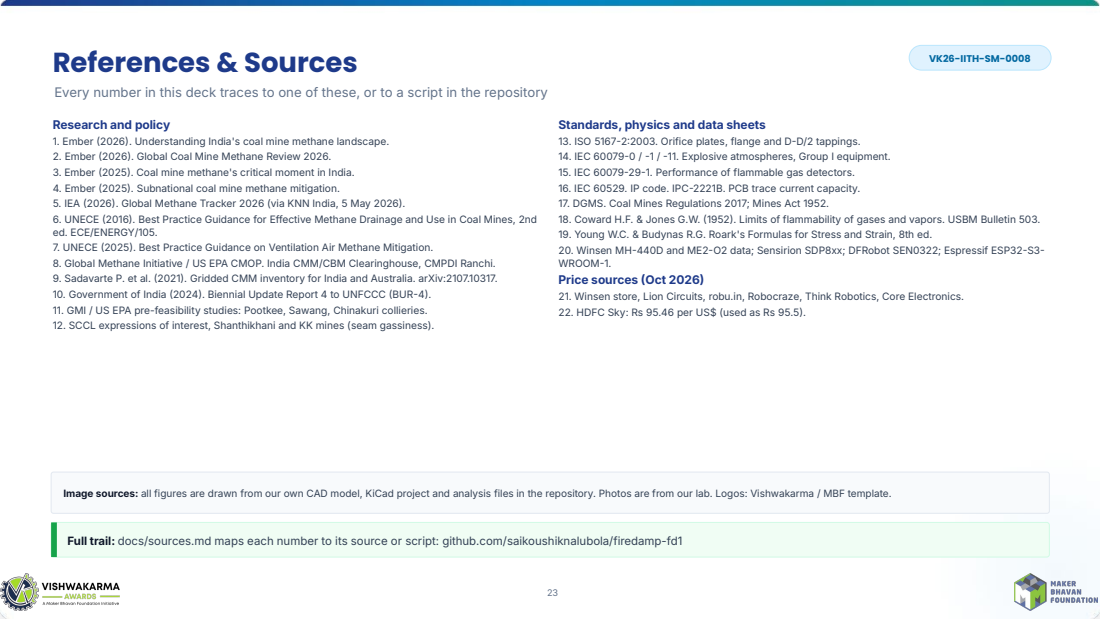
[picture p39: page 23]
VK26-IITH-SM-0008

Every number in this deck traces to one of these, or to a script in the repository

Research and policy
1. Ember (2026). Understanding India's coal mine methane landscape.
2. Ember (2026). Global Coal Mine Methane Review 2026.
3. Ember (2025). Coal mine methane's critical moment in India.
4. Ember (2025). Subnational coal mine methane mitigation.
5. IEA (2026). Global Methane Tracker 2026 (via KNN India, 5 May 2026).
6. UNECE (2016). Best Practice Guidance for Effective Methane Drainage and Use in Coal Mines, 2nd
ed. ECE/ENERGY/105.
7. UNECE (2025). Best Practice Guidance on Ventilation Air Methane Mitigation.
8. Global Methane Initiative / US EPA CMOP. India CMM/CBM Clearinghouse, CMPDI Ranchi.
9. Sadavarte P. et al. (2021). Gridded CMM inventory for India and Australia. arXiv:2107.10317.
10. Government of India (2024). Biennial Update Report 4 to UNFCCC (BUR-4).
11. GMI / US EPA pre-feasibility studies: Pootkee, Sawang, Chinakuri collieries.
12. SCCL expressions of interest, Shanthikhani and KK mines (seam gassiness).

Standards, physics and data sheets
13. ISO 5167-2:2003. Orifice plates, flange and D-D/2 tappings.
14. IEC 60079-0 / -1 / -11. Explosive atmospheres, Group I equipment.
15. IEC 60079-29-1. Performance of flammable gas detectors.
16. IEC 60529. IP code. IPC-2221B. PCB trace current capacity.
17. DGMS. Coal Mines Regulations 2017; Mines Act 1952.
18. Coward H.F. & Jones G.W. (1952). Limits of flammability of gases and vapors. USBM Bulletin 503.
19. Young W.C. & Budynas R.G. Roark's Formulas for Stress and Strain, 8th ed.
20. Winsen MH-440D and ME2-O2 data; Sensirion SDP8xx; DFRobot SEN0322; Espressif ESP32-S3-
WROOM-1.
Price sources (Oct 2026)
21. Winsen store, Lion Circuits, robu.in, Robocraze, Think Robotics, Core Electronics.
22. HDFC Sky: Rs 95.46 per US$ (used as Rs 95.5).

Image sources: all figures are drawn from our own CAD model, KiCad project and analysis files in the repository. Photos are from our lab. Logos: Vishwakarma / MBF template.

Full trail: docs/sources.md maps each number to its source or script: github.com/saikoushiknalubola/firedamp-fd1

# Appendix: Key Terms

Mining and gas terms used in this deck, in one line each

### VK26-IITH-SM-0008

Term | Meaning
Firedamp | miners' name for methane in coal mines; explosive at about 5-15% in air
CMM | coal mine methane: gas released from coal seams by mining
Drainage (pre / post) | boreholes that pull methane out of the seam before mining, or from the goaf after
Goaf | the caved-in void left behind a longwall face; a major gas source
Range main | the pipe that collects gas from many boreholes and carries it to the surface
VAM | ventilation air methane: under 1% CH4 in mine exhaust air
LEL / UEL | lower and upper explosive limits of methane in air: ~5% and ~15%
Term | Meaning
Degree I / II / III | DGMS gassiness classes: < 1, 1-10, > 10 m3 of CH4 per tonne of coal
NDIR | non-dispersive infrared: measures CH4 by how much infrared light it absorbs
MRV | monitoring, reporting and verification of emissions, needed for net- zero filings and credits
GWP-20 | warming effect over 20 years relative to CO2; above 80 for methane
Ex d / Ex ia | flameproof enclosure / intrinsically safe circuit protection for explosive atmospheres
Orifice meter (ISO 5167) | flow from the pressure drop across a sharp-edged plate
DRC | design rule check: proves the PCB meets clearance and width rules before fabrication

For reviewers outside mining: Every term here is used earlier in the deck; one line each so the safety logic reads without a mining background.
