saikoushiknalubola/firedamp-fd1/electronics/pinmap.csv

mcu_pin | net | device | device_pin
GPIO8 | SDA | I2C bus | SDA
GPIO9 | SCL | I2C bus | SCL
GPIO17 (U1TX) | NDIR_RX | MH-440D | RXD
GPIO18 (U1RX) | NDIR_TX | MH-440D | TXD
GPIO4 (ADC1_CH3) | P_ADC | MPX5100AP | Vout via 10k/18k
GPIO15 (U2TX) | 485_DI | MAX3485 | DI
GPIO16 (U2RX) | 485_RO | MAX3485 | RO
GPIO7 | 485_DE | MAX3485 | DE + /RE
GPIO6 | SOL_G | IRLZ44N | Gate via 100R, 100k pull-down
GPIO5 (LEDC) | SERVO_PWM | MG996R | Signal (50 Hz)
GPIO10 | R_IN1 | DRV8871 | IN1
GPIO11 | R_IN2 | DRV8871 | IN2
GPIO13/14/21 | LAMP_R/A/G | ULN2003A | IN1-3 > 12 V stack light
GPIO12 | BUZ | ULN2003A | IN4 > buzzer
GPIO39/40/41/42 | SD_CS/SCK/MISO/MOSI | microSD | SPI
