saikoushiknalubola/firedamp-fd1/docs/figures/block_diagram.png

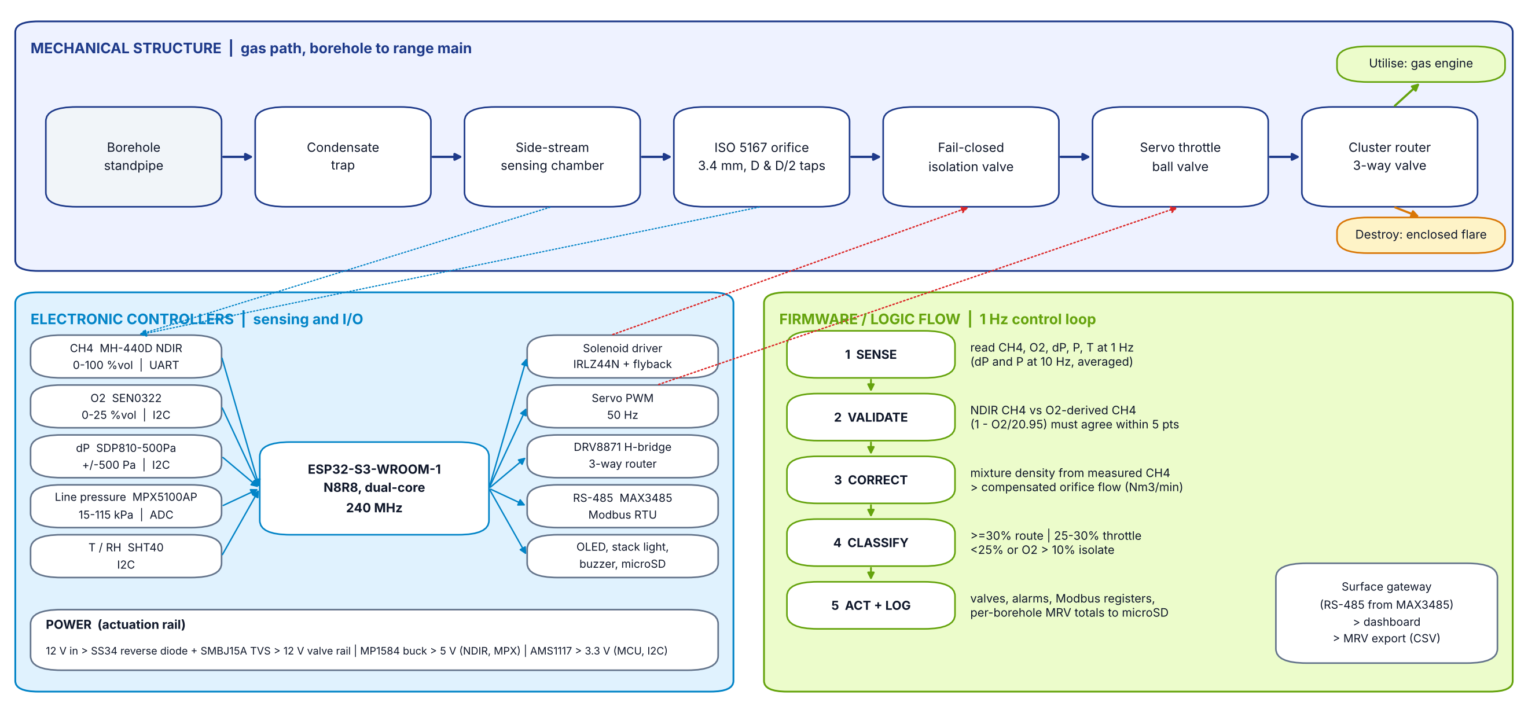
docs/figures/block_diagram.png
