saikoushiknalubola/firedamp-fd1/docs/figures/cad_exploded.png

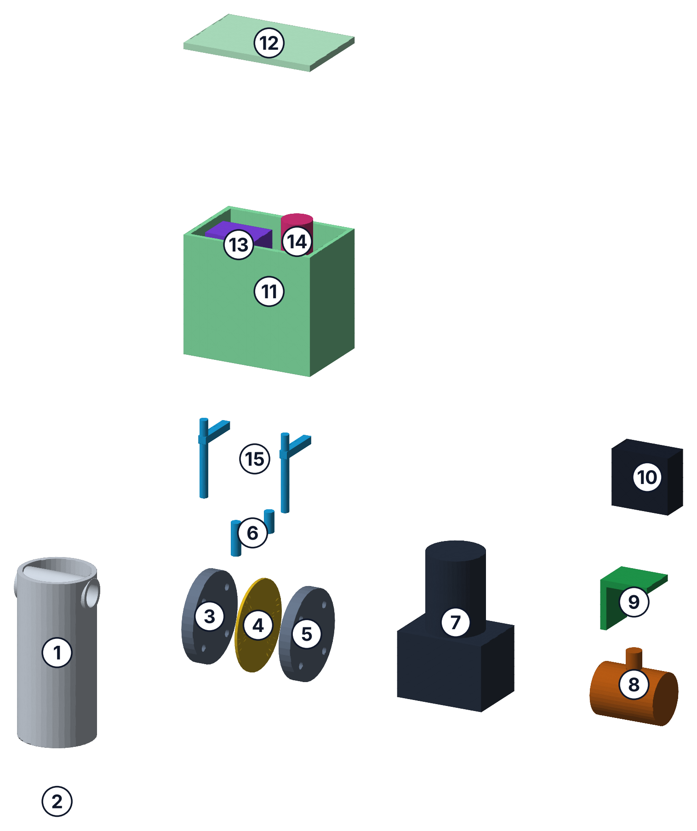
docs/figures/cad_exploded.png
