saikoushiknalubola/firedamp-fd1/docs/figures/cad_internal.png

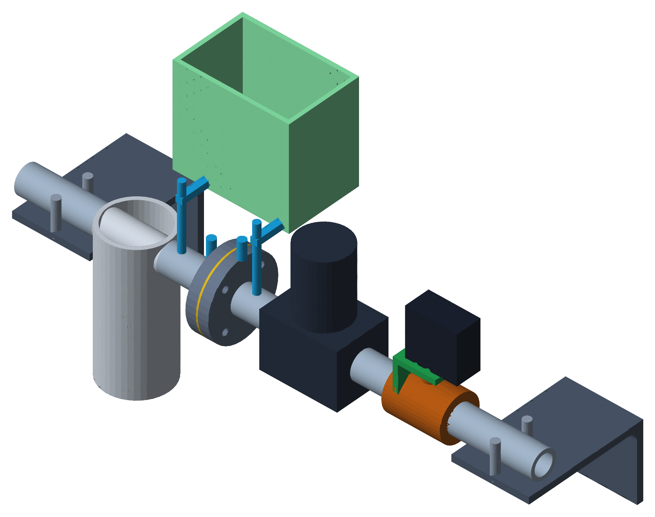
docs/figures/cad_internal.png
