saikoushiknalubola/firedamp-fd1/docs/figures/cad_params_src.png

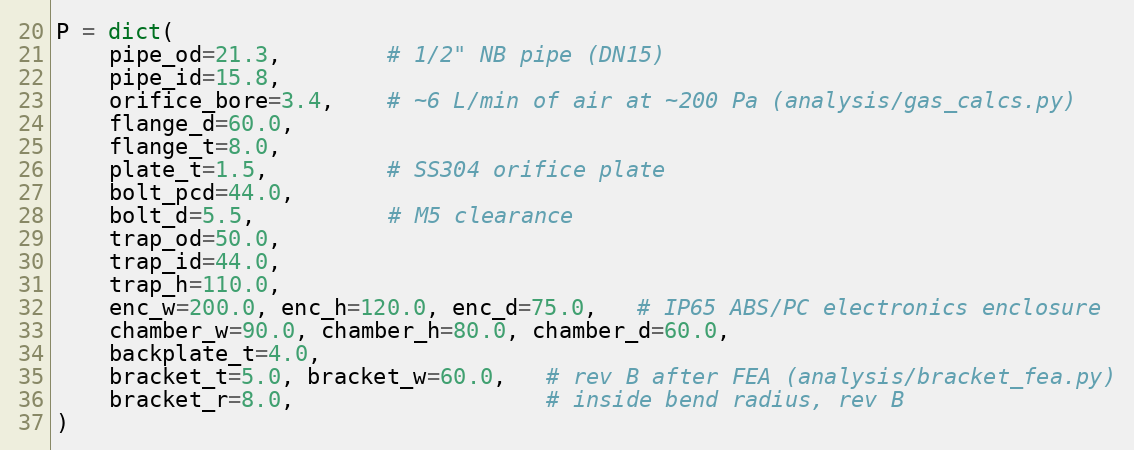
docs/figures/cad_params_src.png
