saikoushiknalubola/firedamp-fd1/docs/figures/coward_routing.png

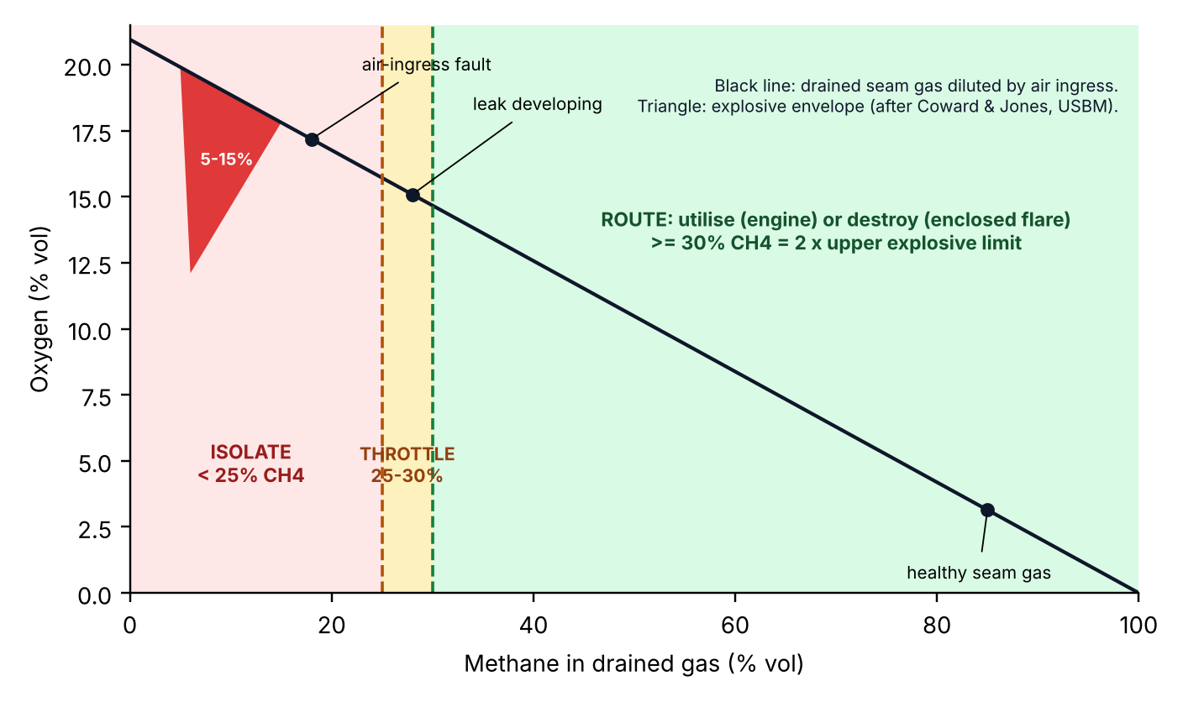
docs/figures/coward_routing.png
