saikoushiknalubola/firedamp-fd1/docs/figures/degree_mines.png

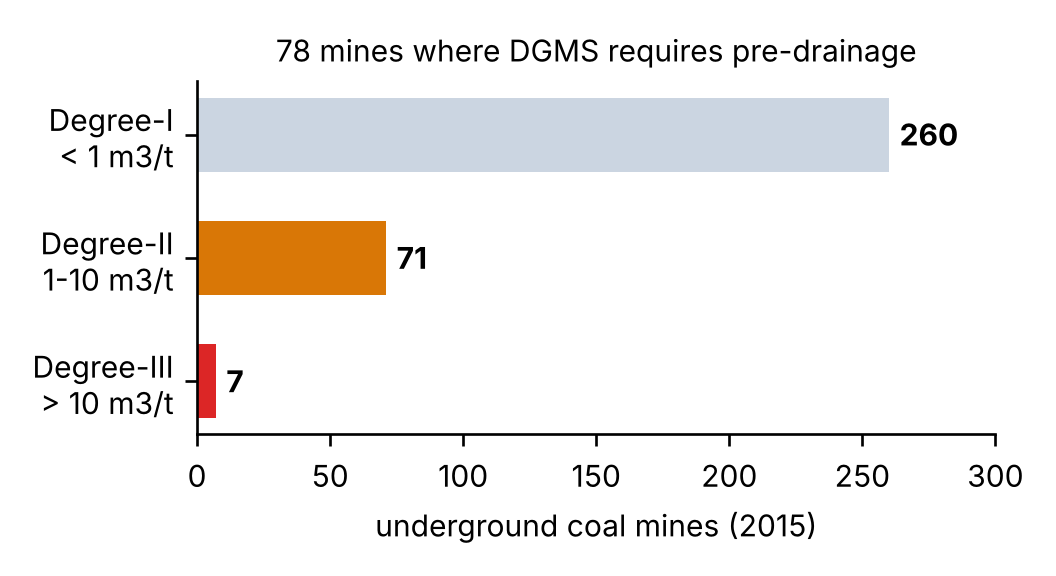
docs/figures/degree_mines.png
