saikoushiknalubola/firedamp-fd1/docs/figures/estimate_spread.png

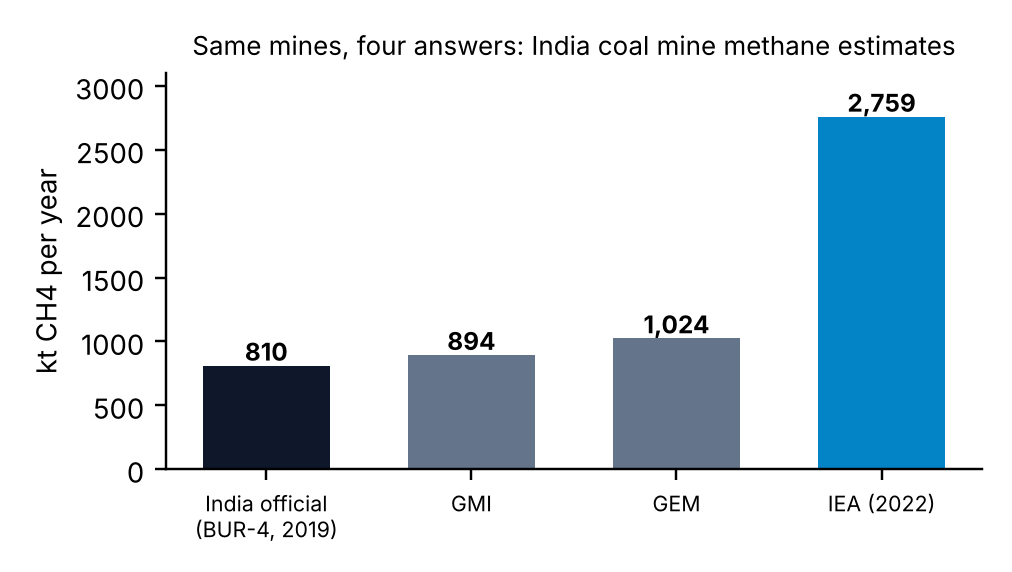
docs/figures/estimate_spread.png
