saikoushiknalubola/firedamp-fd1/docs/figures/fea_convergence.png

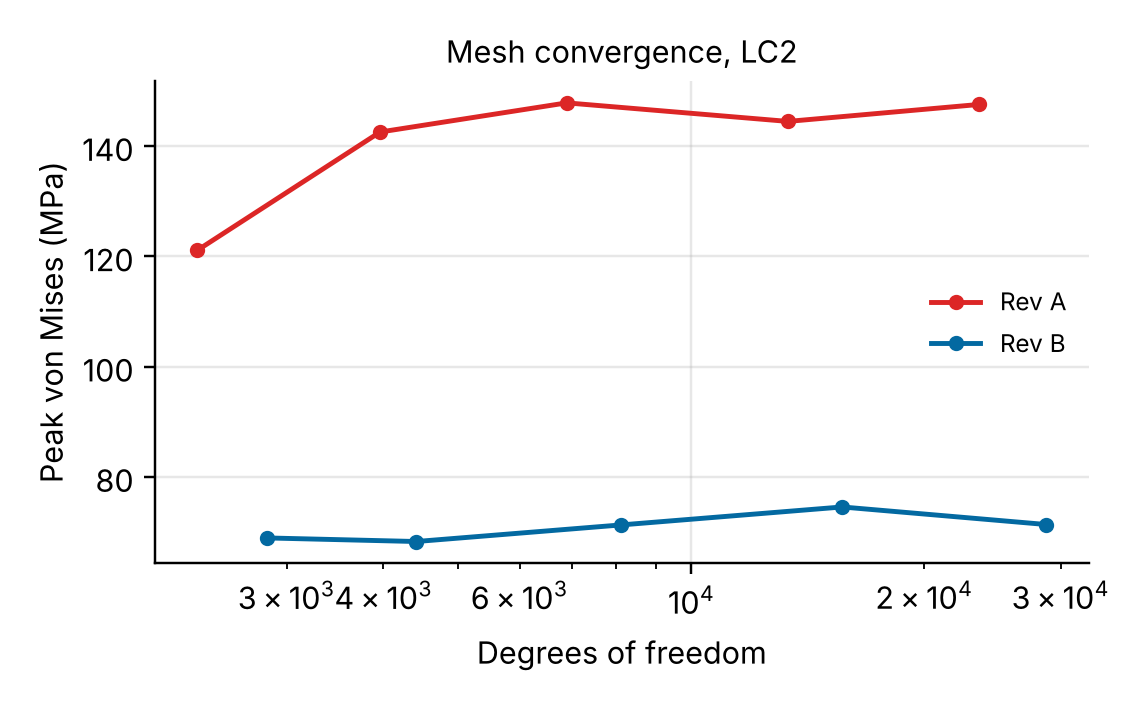
docs/figures/fea_convergence.png
