saikoushiknalubola/firedamp-fd1/docs/figures/fea_pair.png

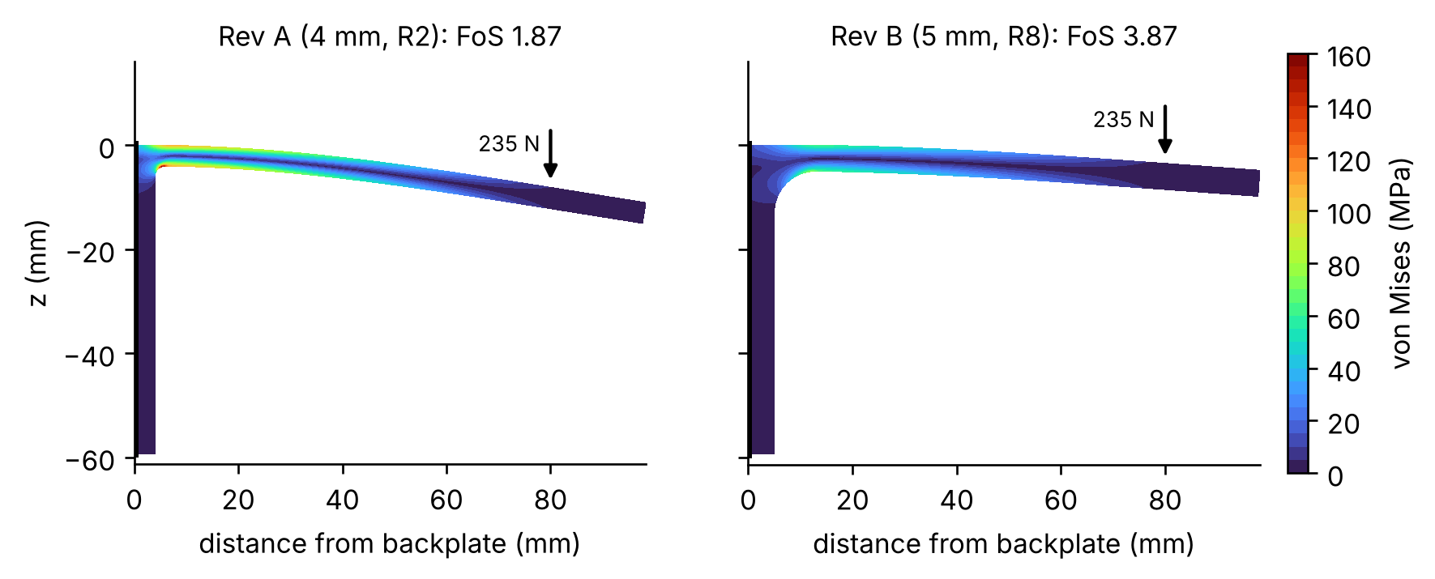
docs/figures/fea_pair.png
