saikoushiknalubola/firedamp-fd1/docs/figures/fea_revA.png

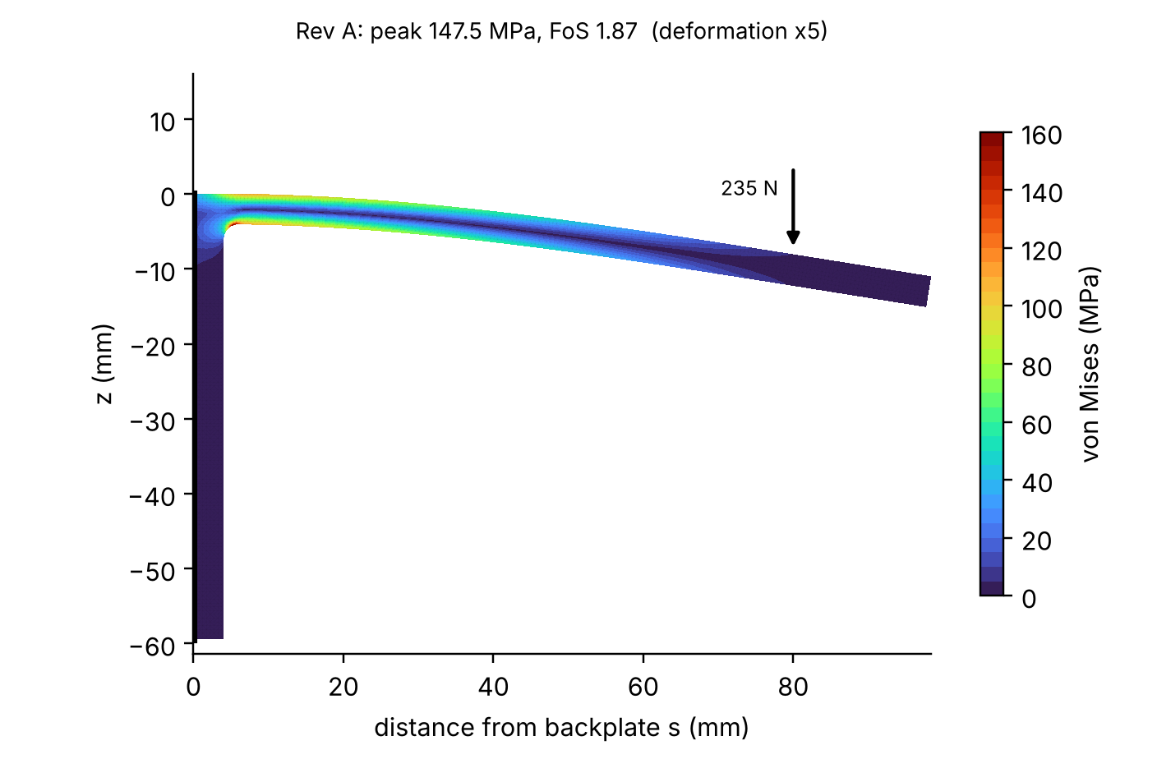
docs/figures/fea_revA.png
