saikoushiknalubola/firedamp-fd1/docs/figures/fw_config_src.png

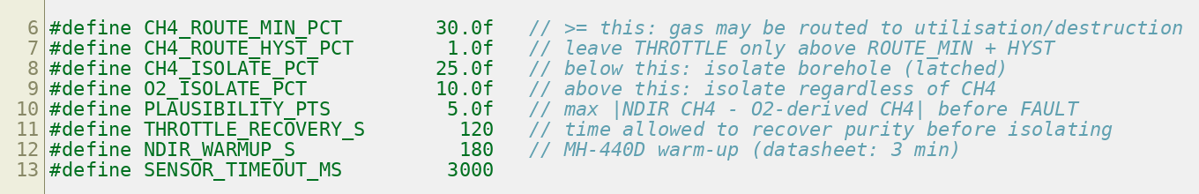
docs/figures/fw_config_src.png
