saikoushiknalubola/firedamp-fd1/docs/figures/gantt.png

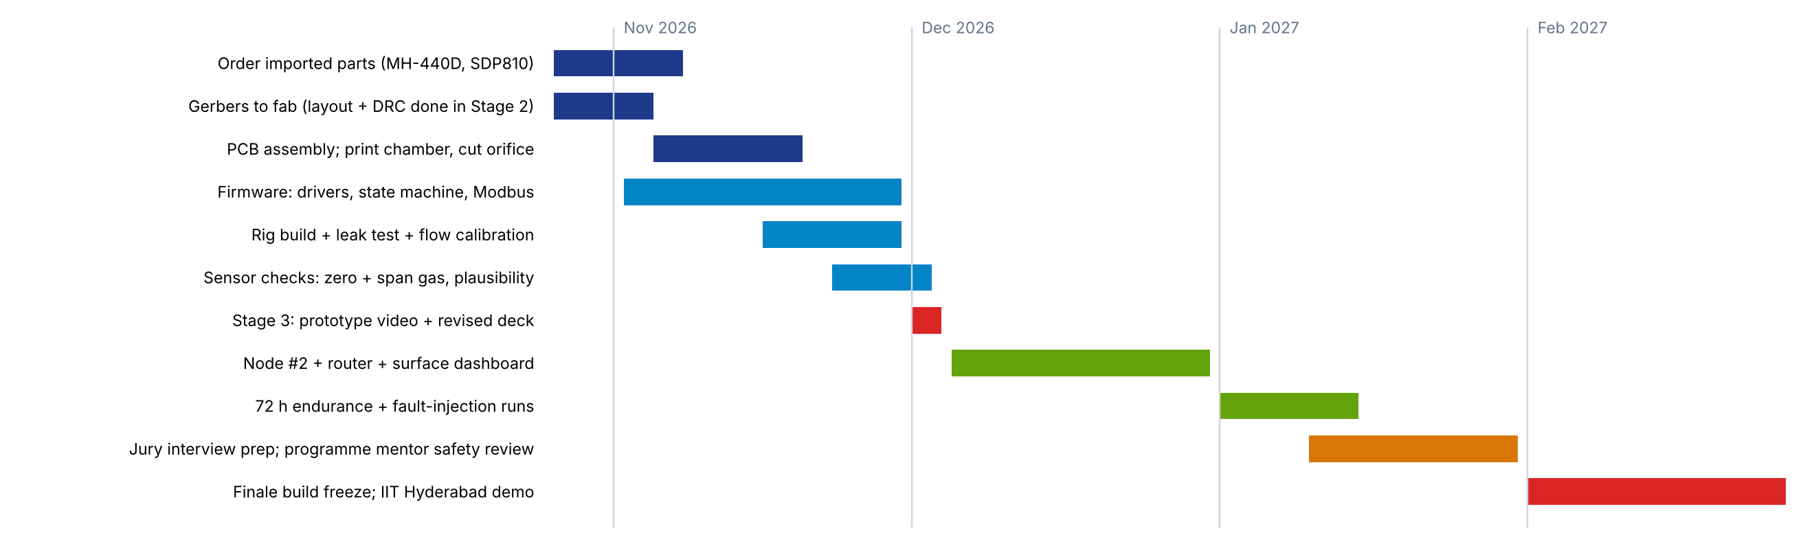
docs/figures/gantt.png
