saikoushiknalubola/firedamp-fd1/docs/figures/journey_after.png

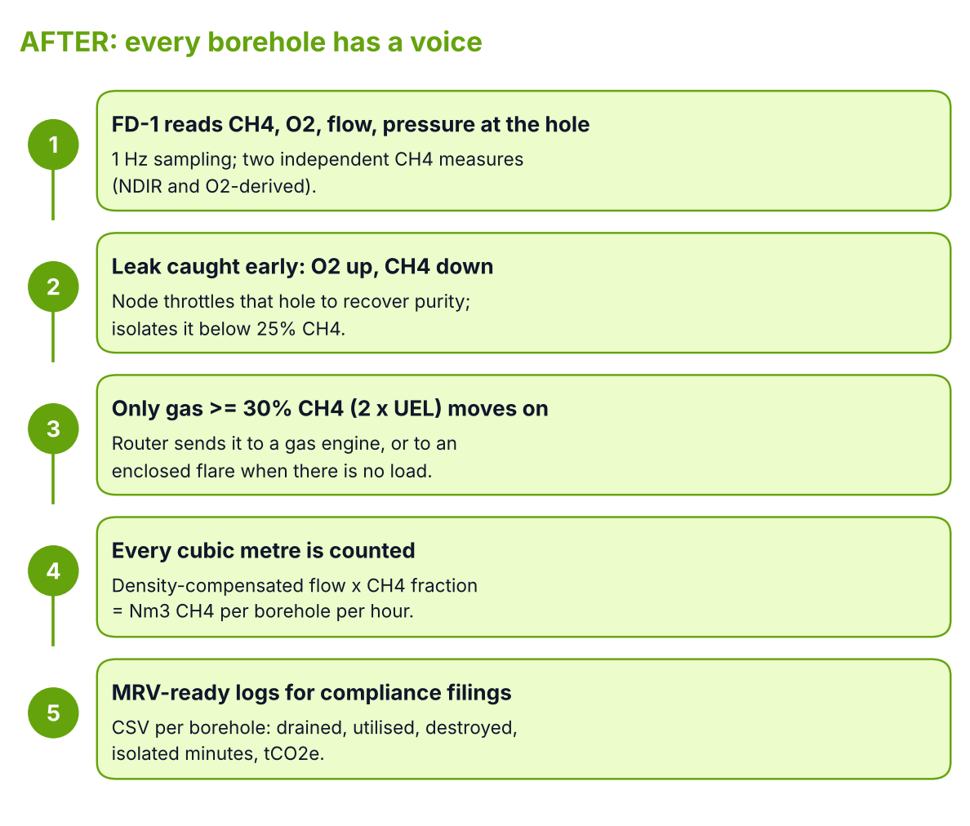
docs/figures/journey_after.png
