saikoushiknalubola/firedamp-fd1/docs/figures/journey_before.png

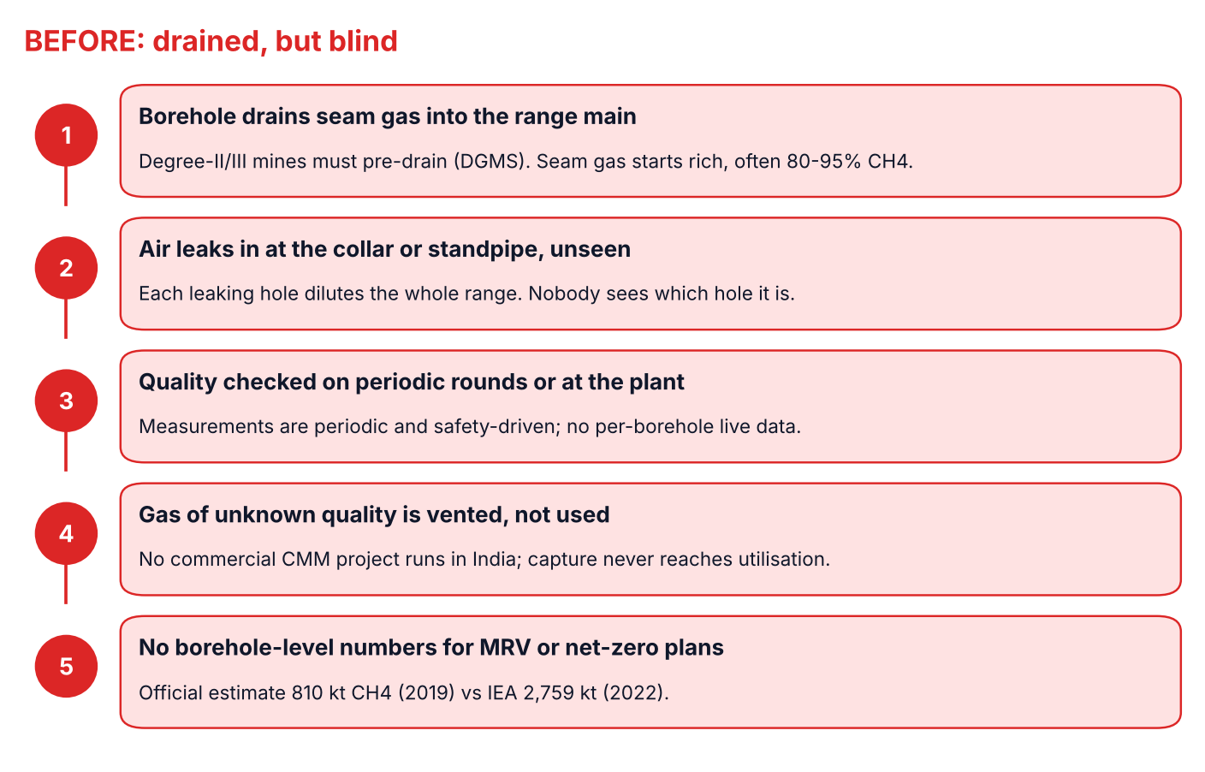
docs/figures/journey_before.png
