saikoushiknalubola/firedamp-fd1/docs/figures/kicad_crop.png

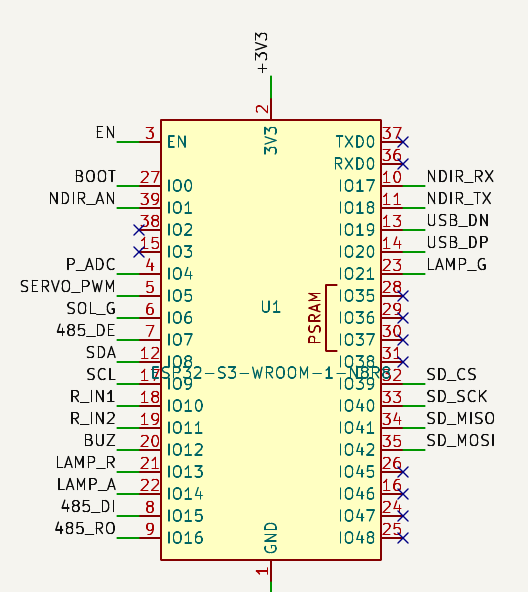
docs/figures/kicad_crop.png
