saikoushiknalubola/firedamp-fd1/docs/figures/kicad_schematic.png

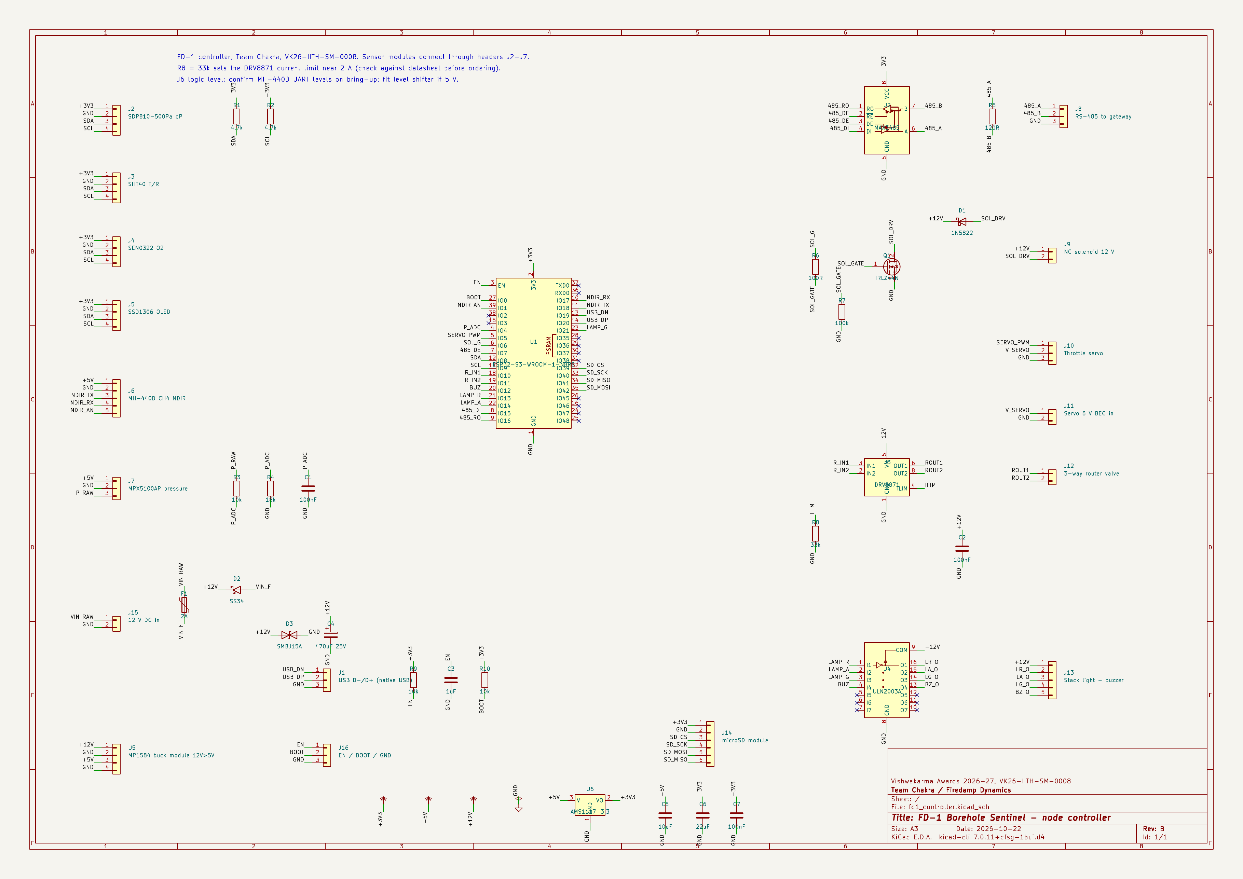
docs/figures/kicad_schematic.png
