saikoushiknalubola/firedamp-fd1/docs/figures/leak_sim.png

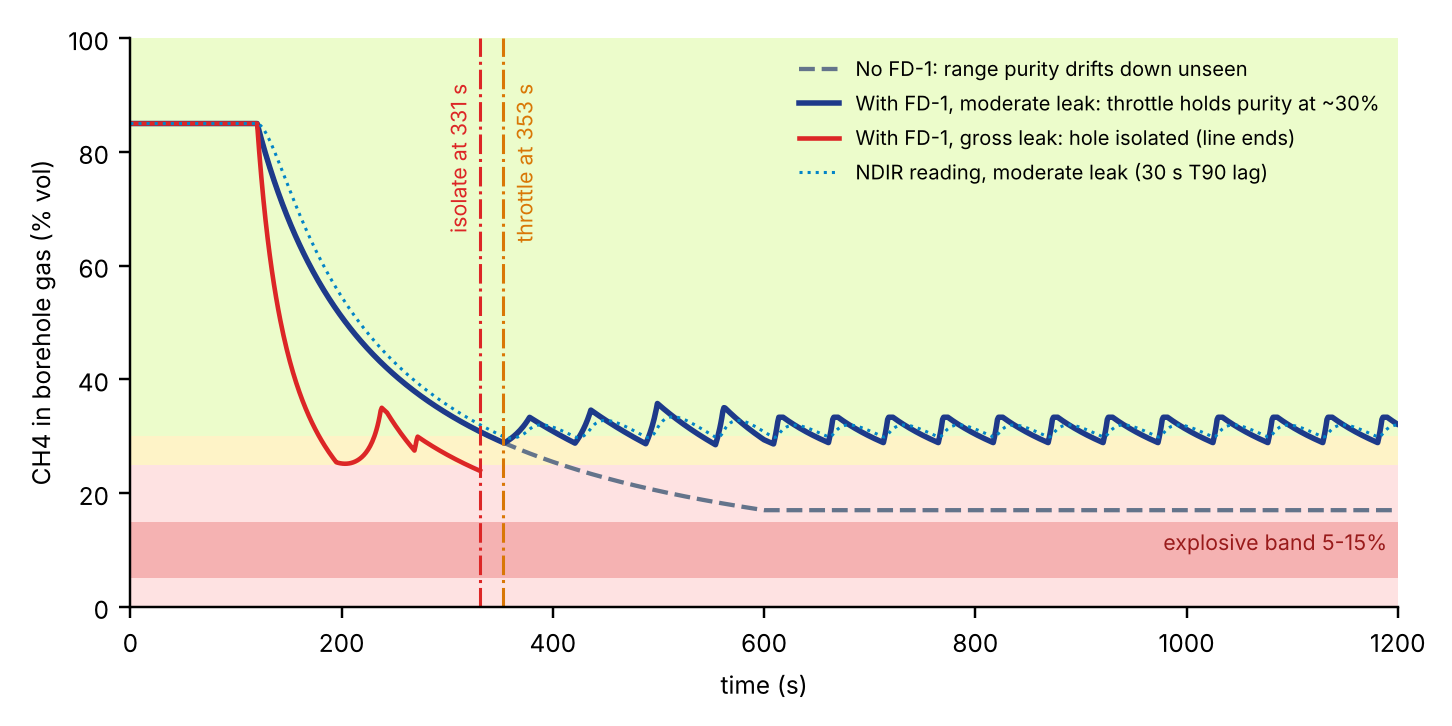
docs/figures/leak_sim.png
