saikoushiknalubola/firedamp-fd1/docs/figures/orifice_curves.png

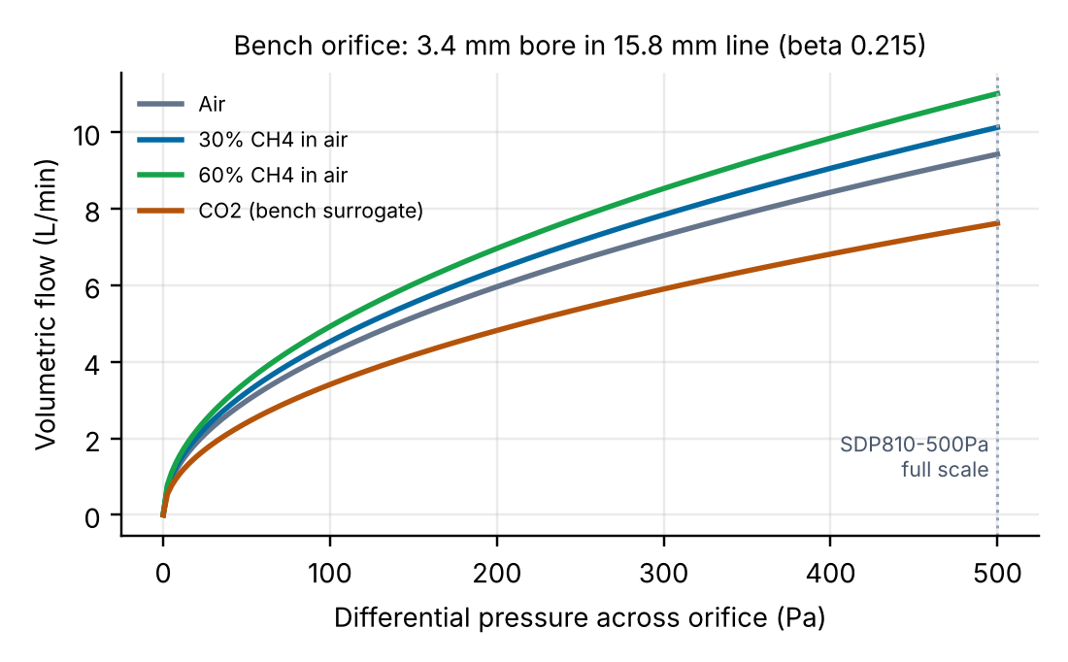
docs/figures/orifice_curves.png
