saikoushiknalubola/firedamp-fd1/docs/figures/pcb_bottom.png

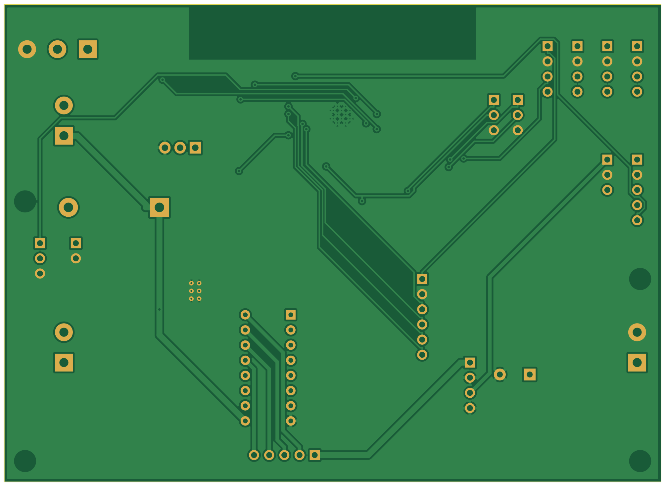
docs/figures/pcb_bottom.png
