saikoushiknalubola/firedamp-fd1/docs/figures/pcb_copper.png

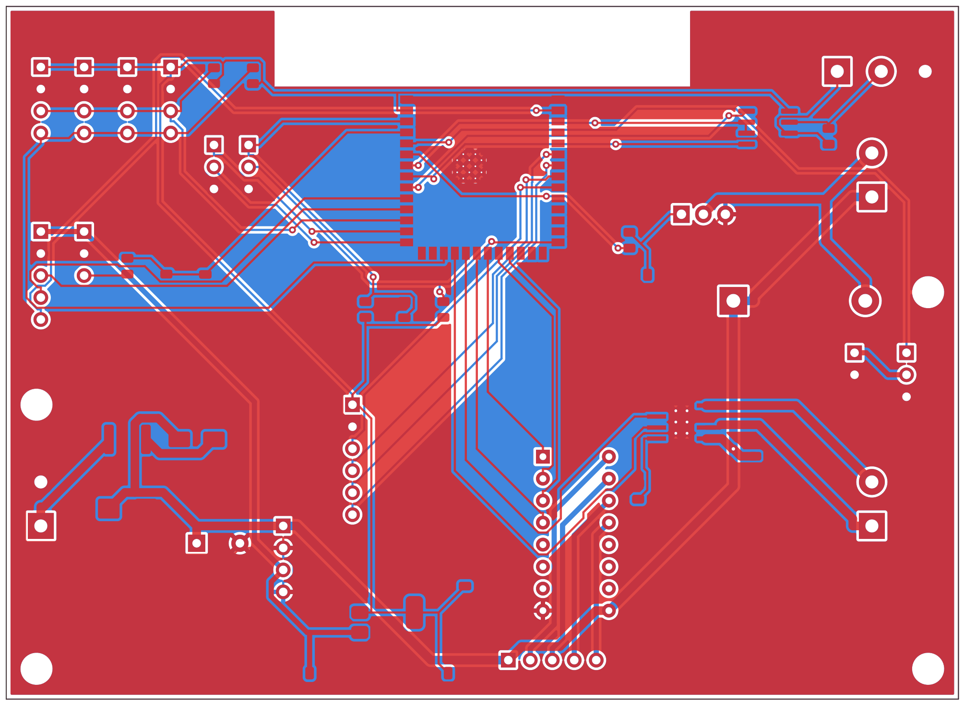
docs/figures/pcb_copper.png
