saikoushiknalubola/firedamp-fd1/docs/figures/pid_rig.png

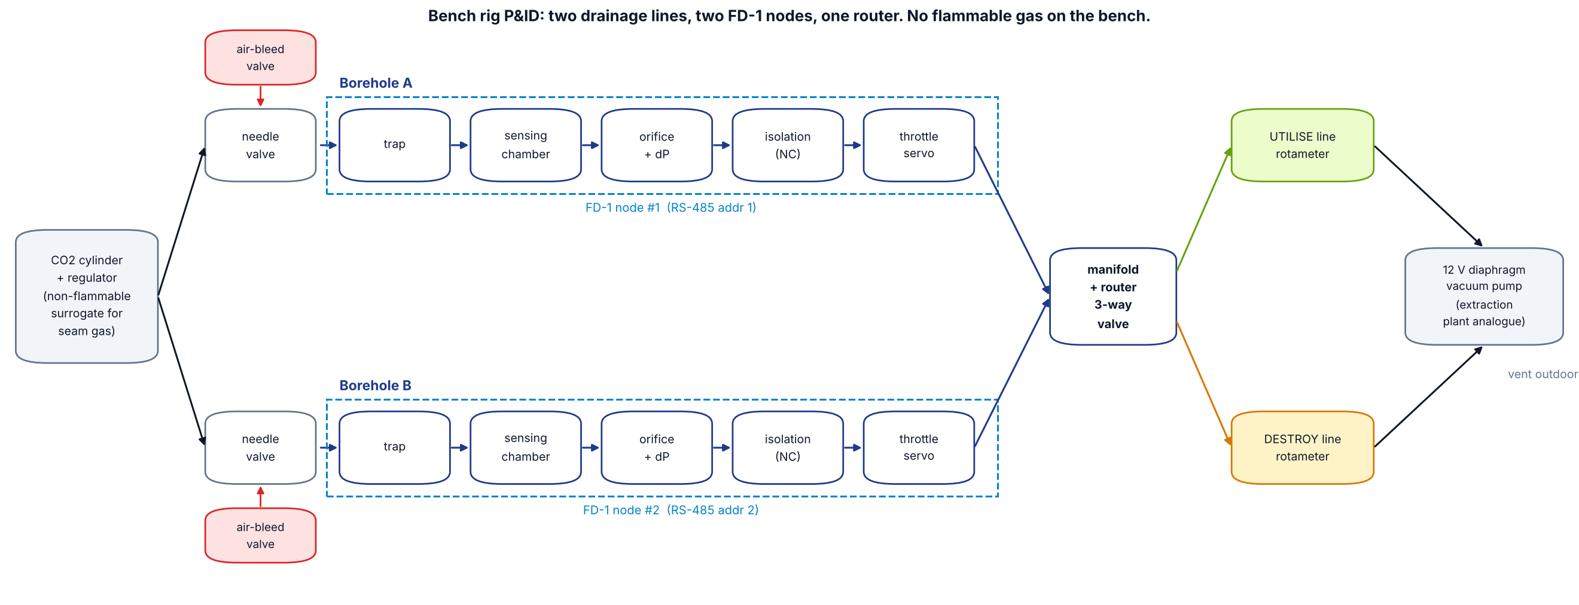
docs/figures/pid_rig.png
