saikoushiknalubola/firedamp-fd1/docs/figures/schematic.png

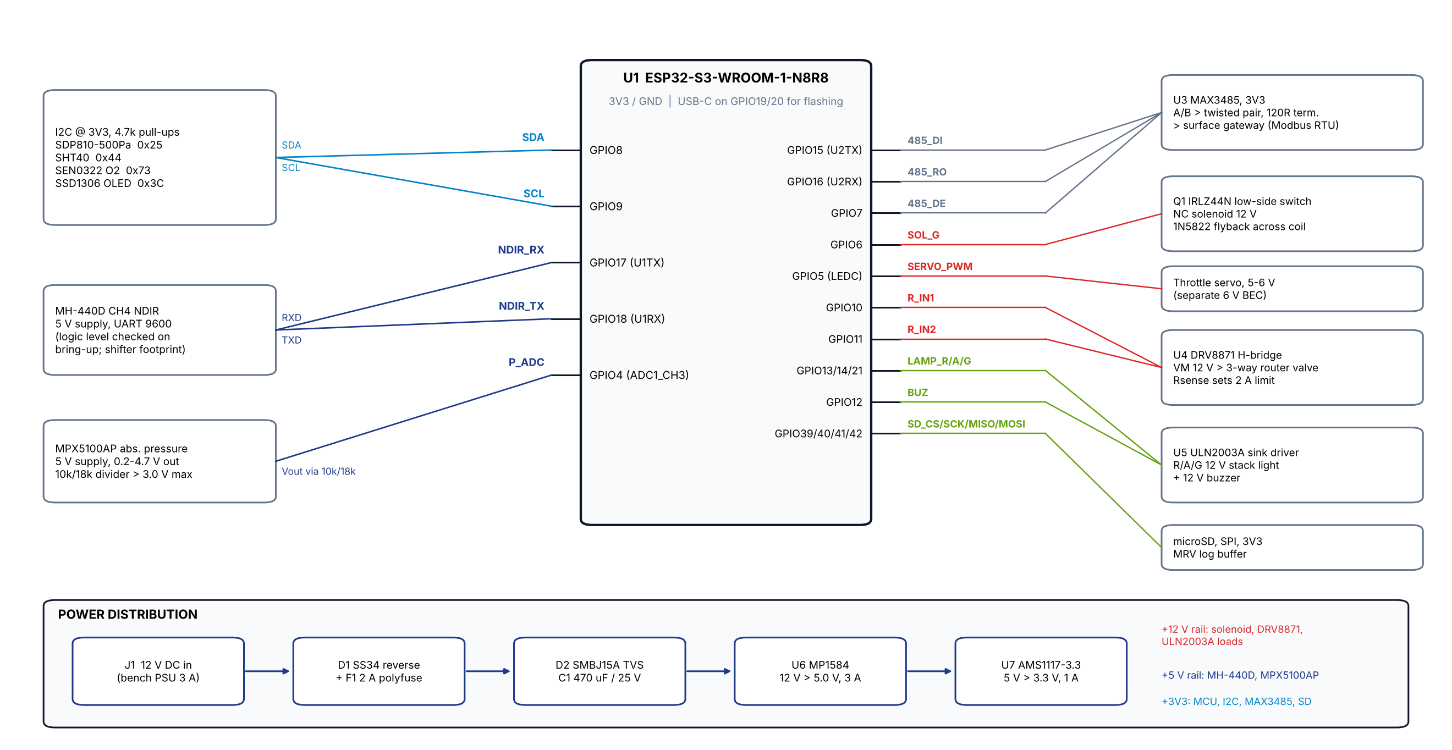
docs/figures/schematic.png
