saikoushiknalubola/firedamp-fd1/docs/figures/state_machine.png

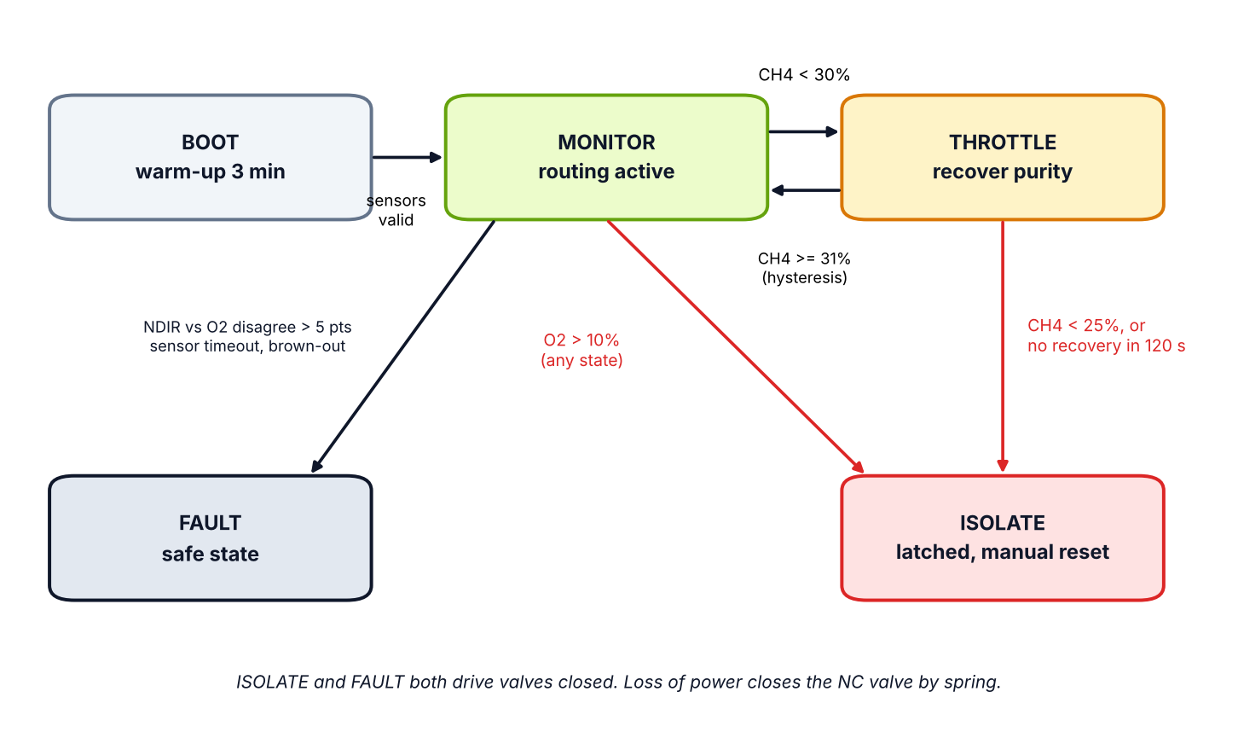
docs/figures/state_machine.png
