saikoushiknalubola/firedamp-fd1/electronics/bom.csv

group | item | part_spec | qty | unit_inr | line_inr | price_basis | cost_note
Sensing | CH4 sensor | Winsen MH-440D NDIR, 0-100 %vol | 1 | 12900 | 12900 | Winsen store: $235 per 2 pcs; x Rs 95.5/$ x 1.15 landed | Only one unit: node #2 runs O2-derived purity on the CO2 bench
Sensing | O2 sensor | DFRobot SEN0322 Gravity I2C (ME2-O2 cell) | 1 | 4900 | 4900 | Core Electronics A$88.53, converted; Indian distributors similar | Bare ME2-O2 cell Rs 3,009 (robu.in) + op-amp saves ~Rs 1,700 in rev C
Sensing | Differential pressure | Sensirion SDP810-500Pa, I2C | 1 | 4170 | 4170 | Lion Circuits listing Rs 4,168.87 | MPXV7002DP is cheaper but +/-50 Pa error swamps a 200 Pa signal
Sensing | Line pressure | MPX5100AP, 15-115 kPa abs | 1 | 1500 | 1500 | estimate from distributor list (~$15) | XGZP6847A vacuum gauge (~Rs 600) if absolute reference added
Sensing | Temp / RH | SHT40 breakout | 1 | 350 | 350 | estimate, local
Control | MCU | ESP32-S3-WROOM-1-N8R8 module (on our PCB) | 1 | 800 | 800 | Lion Circuits listing Rs 800.38 | DevKitC board (Rs 1,850, Think Robotics) only for firmware bring-up
Control | PCB | 2-layer FR4 1.6 mm, 110 x 80 mm, 5 pcs | 1 | 2200 | 2200 | estimate, domestic fab incl. shipping | JLCPCB similar after customs
Control | ICs + discretes | MAX3485, DRV8871, ULN2003A, IRLZ44N, AMS1117, MP1584 module, SS34, SMBJ15A, polyfuse, 0805 R/C | 1 | 950 | 950 | estimate, robu.in / local market
Control | Connectors | pin headers, 3 x 5.08 mm terminal blocks, JST leads | 1 | 300 | 300 | estimate, local
Actuation | Isolation valve | 12 V NC direct-acting (zero differential) solenoid, 1/2" brass | 1 | 1500 | 1500 | estimate; zero-diff 1/2" valves list near Rs 1,289 (Robocraze, NO type) | Rs 400 pilot valves need 0.02 MPa to open, so they fail on a vacuum line
Actuation | Throttle | 1/2" brass ball valve + MG996R servo + printed bracket | 1 | 700 | 700 | estimate, local
HMI | Status | SSD1306 OLED, 12 V R/A/G tower lamp, buzzer | 1 | 950 | 950 | estimate, local
HMI | Logging | microSD SPI module + 16 GB card | 1 | 400 | 400 | estimate, local
Mechanical | Enclosure | IP65 ABS/PC 200x120x75 + 4 x PG7 glands | 1 | 780 | 780 | estimate, local
Mechanical | Orifice meter | SS304 plate 1.5 mm laser cut + 2 Al 6061 flanges | 1 | 1200 | 1200 | estimate, Warangal job shop
Mechanical | Printed parts | PETG, ~250 g (chamber, servo bracket) | 1 | 300 | 300 | estimate; free in college makerspace
Mechanical | Frame | Al backplate 4 mm + 2 rev B brackets (5 mm) | 1 | 1500 | 1500 | estimate, job shop
Bench rig | Surrogate gas | CO2 cylinder 2 kg + regulator (aquarium/beverage grade) | 1 | 3500 | 3500 | estimate, local | Refill ~Rs 400
Bench rig | Reference flow | Acrylic rotameter 1-10 L/min | 1 | 1200 | 1200 | estimate, IndiaMART range
Bench rig | Leak simulation | Brass needle valves | 2 | 300 | 600 | estimate, local
Bench rig | Suction | 12 V diaphragm vacuum pump | 1 | 900 | 900 | estimate, robu.in range
Bench rig | Pipework | 1/2" PVC-U + clear acrylic tube, tees, PU 4 mm, fittings | 1 | 1500 | 1500 | estimate, local
Bench rig | Power | 12 V 5 A SMPS + e-stop switch | 1 | 800 | 800 | estimate, local
Bench rig | Span gas | Certified 2.5 %vol CH4 in air, small cylinder | 1 | 4500 | 4500 | estimate, domestic gas vendor | Rs 0 if borrowed from the mining / chemistry lab
