saikoushiknalubola/firedamp-fd1/electronics/kicad/connections.csv

ref | pin | net
U1 | 1 | GND
U1 | 10 | NDIR_RX
U1 | 11 | NDIR_TX
U1 | 12 | SDA
U1 | 13 | USB_DN
U1 | 14 | USB_DP
U1 | 17 | SCL
U1 | 18 | R_IN1
U1 | 19 | R_IN2
U1 | 2 | +3V3
U1 | 20 | BUZ
U1 | 21 | LAMP_R
U1 | 22 | LAMP_A
U1 | 23 | LAMP_G
U1 | 27 | BOOT
U1 | 3 | EN
U1 | 32 | SD_CS
U1 | 33 | SD_SCK
U1 | 34 | SD_MISO
U1 | 35 | SD_MOSI
U1 | 39 | NDIR_AN
U1 | 4 | P_ADC
U1 | 5 | SERVO_PWM
U1 | 6 | SOL_G
U1 | 7 | 485_DE
U1 | 8 | 485_DI
U1 | 9 | 485_RO
J2 | 1 | +3V3
J2 | 2 | GND
J2 | 3 | SDA
J2 | 4 | SCL
J3 | 1 | +3V3
J3 | 2 | GND
J3 | 3 | SDA
J3 | 4 | SCL
J4 | 1 | +3V3
J4 | 2 | GND
J4 | 3 | SDA
J4 | 4 | SCL
J5 | 1 | +3V3
J5 | 2 | GND
J5 | 3 | SDA
J5 | 4 | SCL
R1 | 1 | +3V3
R1 | 2 | SDA
R2 | 1 | +3V3
R2 | 2 | SCL
J6 | 1 | +5V
J6 | 2 | GND
J6 | 3 | NDIR_TX
J6 | 4 | NDIR_RX
J6 | 5 | NDIR_AN
J7 | 1 | +5V
J7 | 2 | GND
J7 | 3 | P_RAW
R3 | 1 | P_RAW
R3 | 2 | P_ADC
R4 | 1 | P_ADC
R4 | 2 | GND
C1 | 1 | P_ADC
C1 | 2 | GND
U2 | 1 | 485_RO
U2 | 2 | 485_DE
U2 | 3 | 485_DE
U2 | 4 | 485_DI
U2 | 5 | GND
U2 | 6 | 485_A
U2 | 7 | 485_B
U2 | 8 | +3V3
R5 | 1 | 485_A
R5 | 2 | 485_B
J8 | 1 | 485_A
J8 | 2 | 485_B
J8 | 3 | GND
Q1 | 1 | SOL_GATE
Q1 | 2 | SOL_DRV
Q1 | 3 | GND
R6 | 1 | SOL_G
R6 | 2 | SOL_GATE
R7 | 1 | SOL_GATE
R7 | 2 | GND
D1 | 1 | +12V
D1 | 2 | SOL_DRV
J9 | 1 | +12V
J9 | 2 | SOL_DRV
J10 | 1 | SERVO_PWM
J10 | 2 | V_SERVO
J10 | 3 | GND
J11 | 1 | V_SERVO
J11 | 2 | GND
U3 | 1 | GND
U3 | 2 | R_IN2
U3 | 3 | R_IN1
U3 | 4 | ILIM
U3 | 5 | +12V
U3 | 6 | ROUT1
U3 | 8 | ROUT2
R8 | 1 | ILIM
R8 | 2 | GND
C2 | 1 | +12V
C2 | 2 | GND
J12 | 1 | ROUT1
J12 | 2 | ROUT2
U4 | 1 | LAMP_R
U4 | 13 | BZ_O
U4 | 14 | LG_O
U4 | 15 | LA_O
U4 | 16 | LR_O
U4 | 2 | LAMP_A
U4 | 3 | LAMP_G
U4 | 4 | BUZ
U4 | 8 | GND
U4 | 9 | +12V
J13 | 1 | +12V
J13 | 2 | LR_O
J13 | 3 | LA_O
J13 | 4 | LG_O
J13 | 5 | BZ_O
J14 | 1 | +3V3
J14 | 2 | GND
J14 | 3 | SD_CS
J14 | 4 | SD_SCK
J14 | 5 | SD_MOSI
J14 | 6 | SD_MISO
J1 | 1 | USB_DN
J1 | 2 | USB_DP
J1 | 3 | GND
J16 | 1 | EN
J16 | 2 | BOOT
J16 | 3 | GND
R9 | 1 | +3V3
R9 | 2 | EN
C3 | 1 | EN
C3 | 2 | GND
R10 | 1 | +3V3
R10 | 2 | BOOT
J15 | 1 | VIN_RAW
J15 | 2 | GND
F1 | 1 | VIN_RAW
F1 | 2 | VIN_F
D2 | 1 | +12V
D2 | 2 | VIN_F
D3 | 1 | +12V
D3 | 2 | GND
C4 | 1 | +12V
C4 | 2 | GND
U5 | 1 | +12V
U5 | 2 | GND
U5 | 3 | +5V
U5 | 4 | GND
U6 | 1 | GND
U6 | 2 | +3V3
U6 | 3 | +5V
C5 | 1 | +5V
C5 | 2 | GND
C6 | 1 | +3V3
C6 | 2 | GND
C7 | 1 | +3V3
C7 | 2 | GND
