saikoushiknalubola/firedamp-fd1/cad/FD1_full_assembly.stl

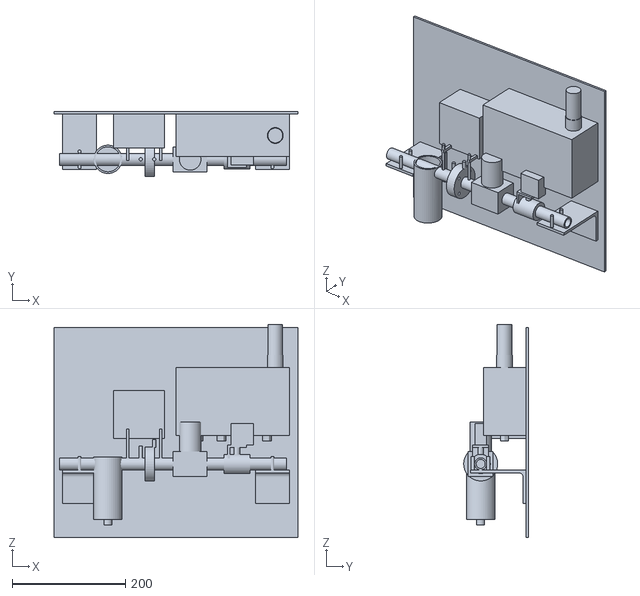
[picture p63: CAD file, 2026-10-24]
cad/FD1_full_assembly.stl
430.0 x 114.0 x 376.0
