saikoushiknalubola/firedamp-fd1/cad/step/servo_bracket.step

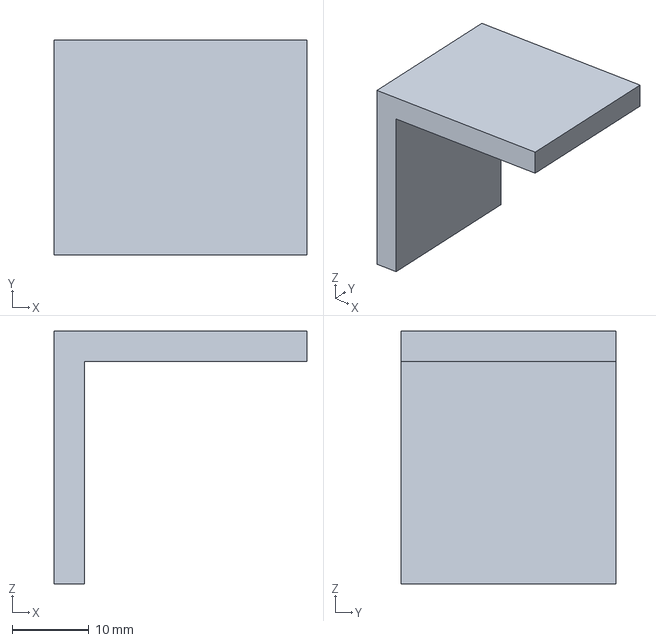
[picture p64: CAD file, 2026-10-22]
cad/step/servo_bracket.step
33.0 x 28.0 x 33.0 mm
