saikoushiknalubola/firedamp-fd1/cad/step/backplate.step

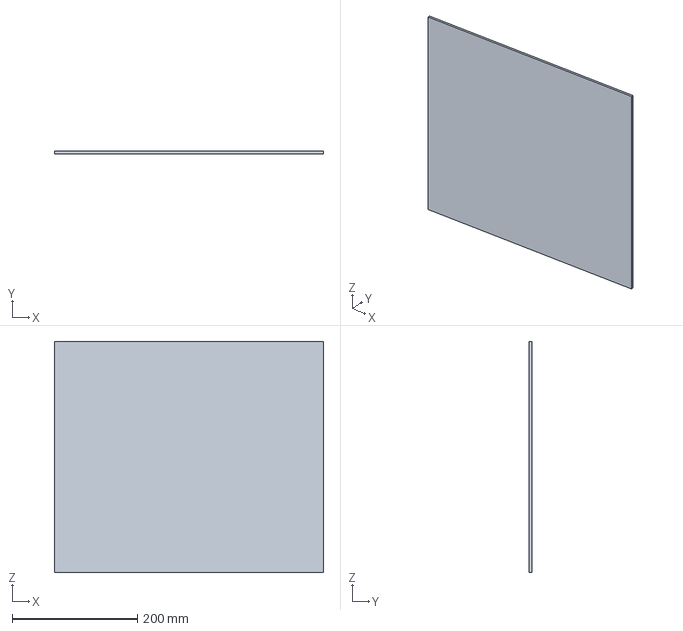
[picture p65: CAD file, 2026-10-22]
cad/step/backplate.step
430.0 x 4.00 x 370.0 mm
