saikoushiknalubola/firedamp-fd1/cad/step/o2_cell.step

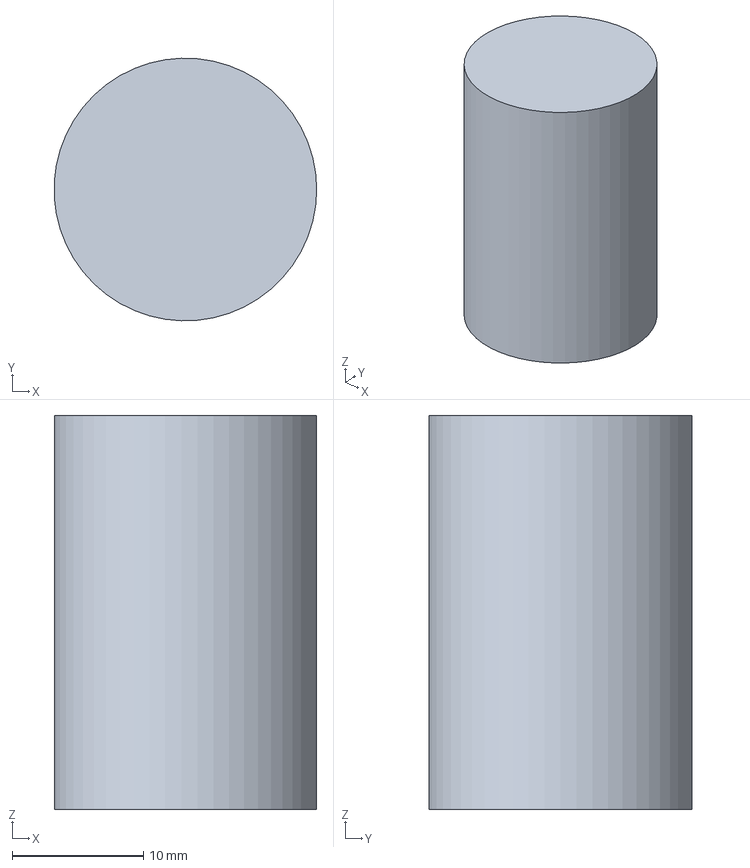
[picture p66: CAD file, 2026-10-22]
cad/step/o2_cell.step
20.0 x 20.0 x 30.0 mm
