saikoushiknalubola/firedamp-fd1/cad/step/drain_plug.step

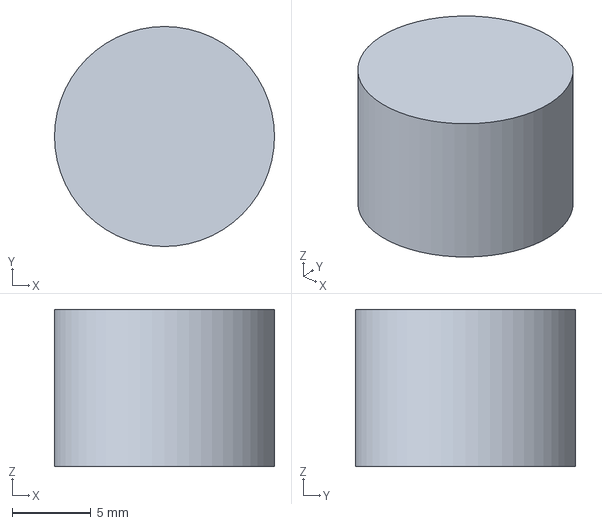
[picture p67: CAD file, 2026-10-22]
cad/step/drain_plug.step
14.0 x 14.0 x 10.0 mm
