saikoushiknalubola/firedamp-fd1/cad/step/dp_taps.step

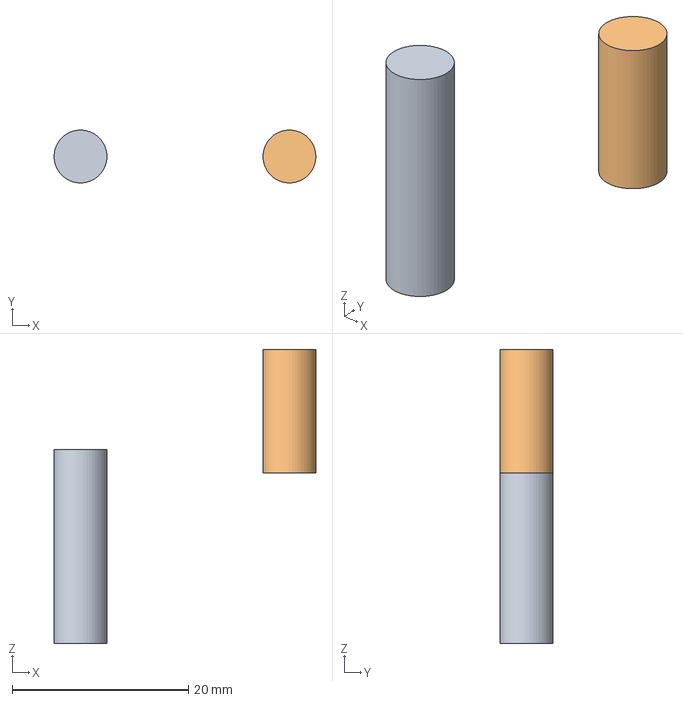
[picture p68: CAD file, 2026-10-22]
cad/step/dp_taps.step
29.7 x 6.00 x 33.4 mm
