saikoushiknalubola/firedamp-fd1/cad/step/throttle_servo.step

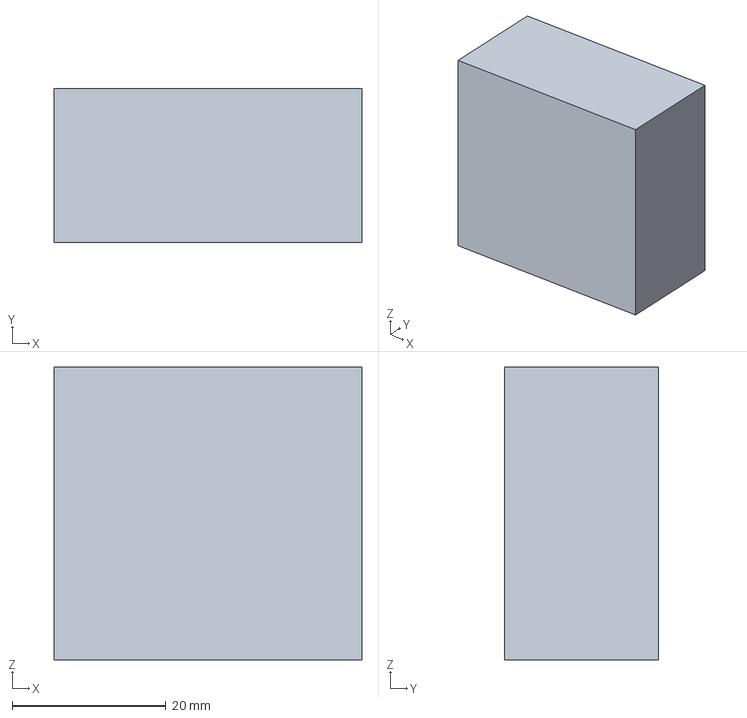
[picture p69: CAD file, 2026-10-22]
cad/step/throttle_servo.step
40.0 x 20.0 x 38.0 mm
