saikoushiknalubola/firedamp-fd1/cad/step/orifice_plate.step

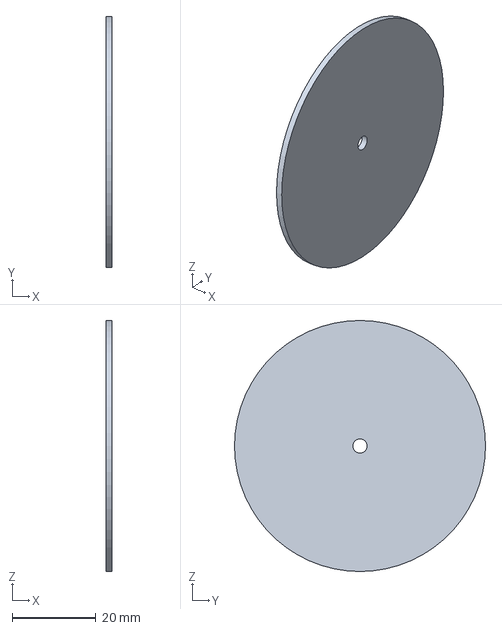
[picture p70: CAD file, 2026-10-22]
cad/step/orifice_plate.step
1.50 x 60.0 x 60.0 mm
