saikoushiknalubola/firedamp-fd1/cad/step/oled_window.step

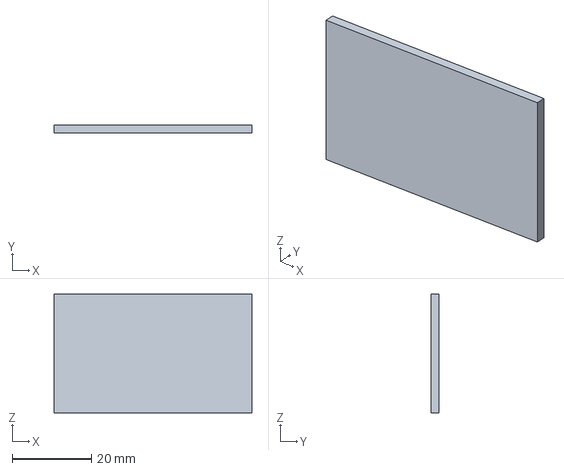
[picture p71: CAD file, 2026-10-22]
cad/step/oled_window.step
50.0 x 2.00 x 30.0 mm
