saikoushiknalubola/firedamp-fd1/cad/step/throttle_ball_valve.step

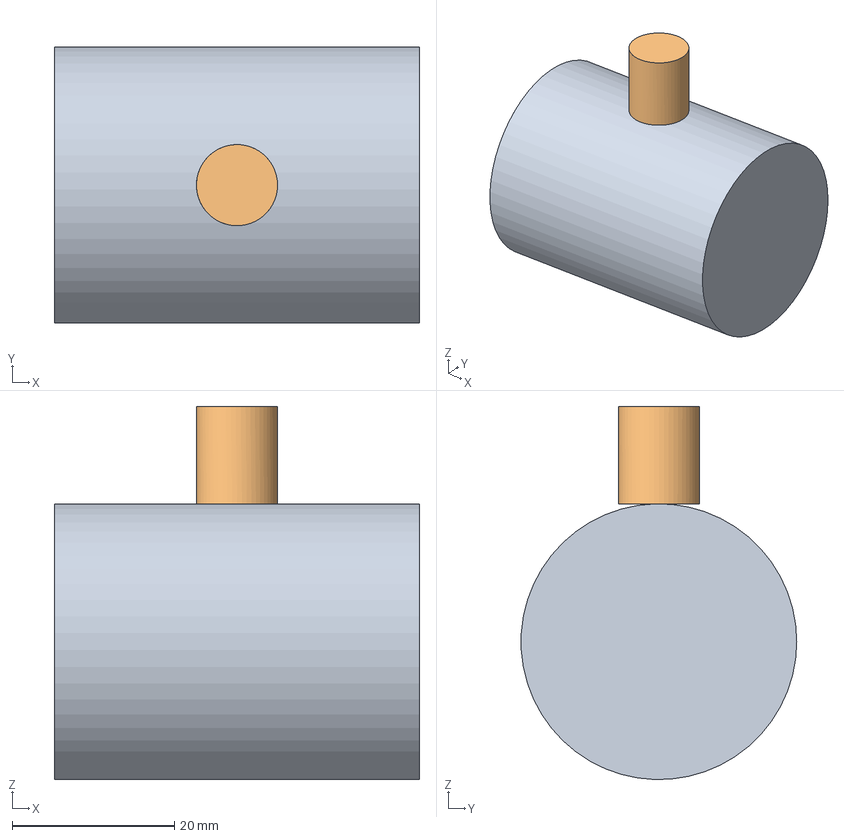
[picture p72: CAD file, 2026-10-22]
cad/step/throttle_ball_valve.step
45.0 x 34.0 x 46.0 mm
