saikoushiknalubola/firedamp-fd1/cad/step/flange_upstream.step

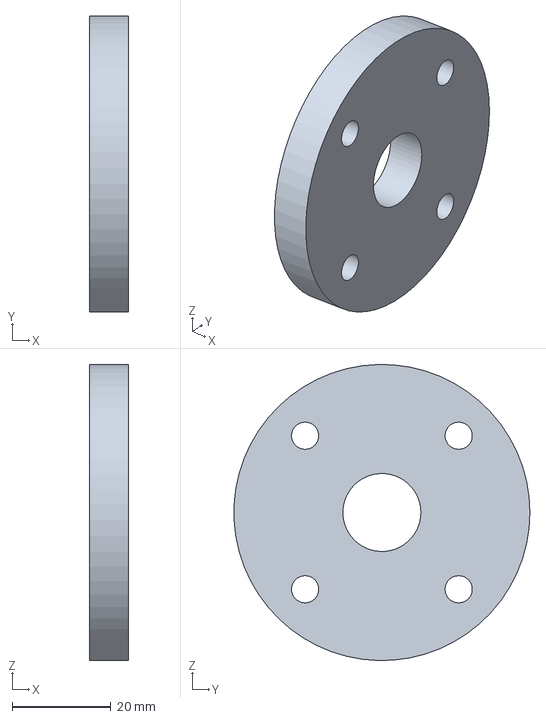
[picture p73: CAD file, 2026-10-22]
cad/step/flange_upstream.step
8.00 x 60.0 x 60.0 mm
