saikoushiknalubola/firedamp-fd1/cad/step/line_pipework.step

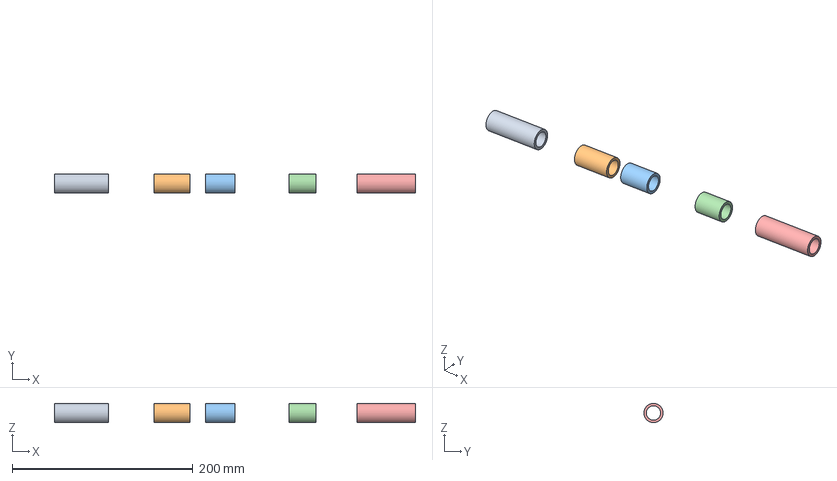
[picture p74: CAD file, 2026-10-22]
cad/step/line_pipework.step
400.0 x 21.3 x 21.3 mm
