saikoushiknalubola/firedamp-fd1/cad/step/ch4_ndir_sensor.step

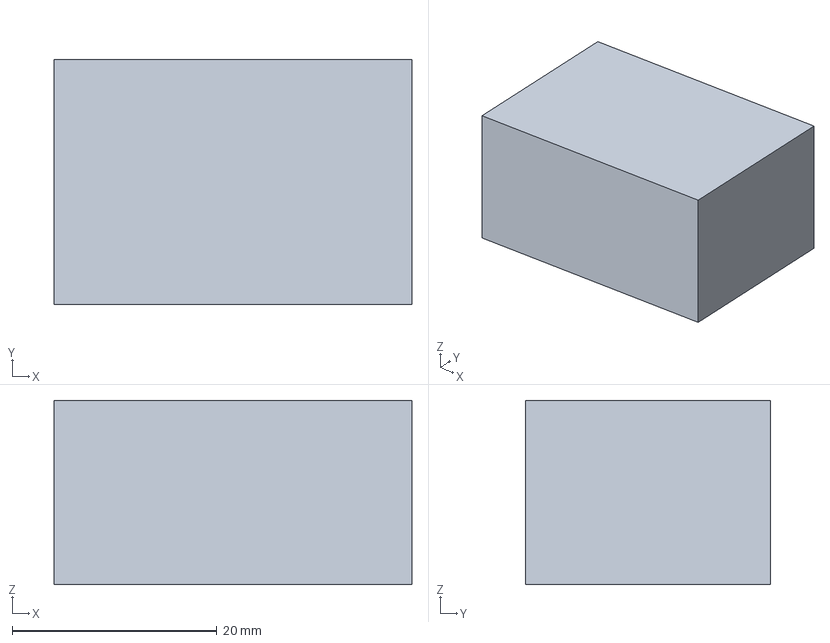
[picture p75: CAD file, 2026-10-22]
cad/step/ch4_ndir_sensor.step
35.0 x 24.0 x 18.0 mm
