saikoushiknalubola/firedamp-fd1/cad/step/pipe_bracket_B.step

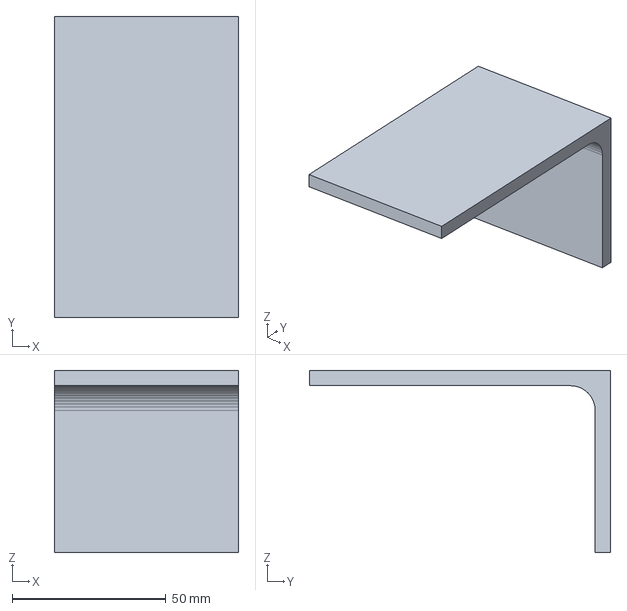
[picture p76: CAD file, 2026-10-22]
cad/step/pipe_bracket_B.step
60.0 x 98.0 x 59.4 mm
