saikoushiknalubola/firedamp-fd1/cad/step/sensing_chamber.step

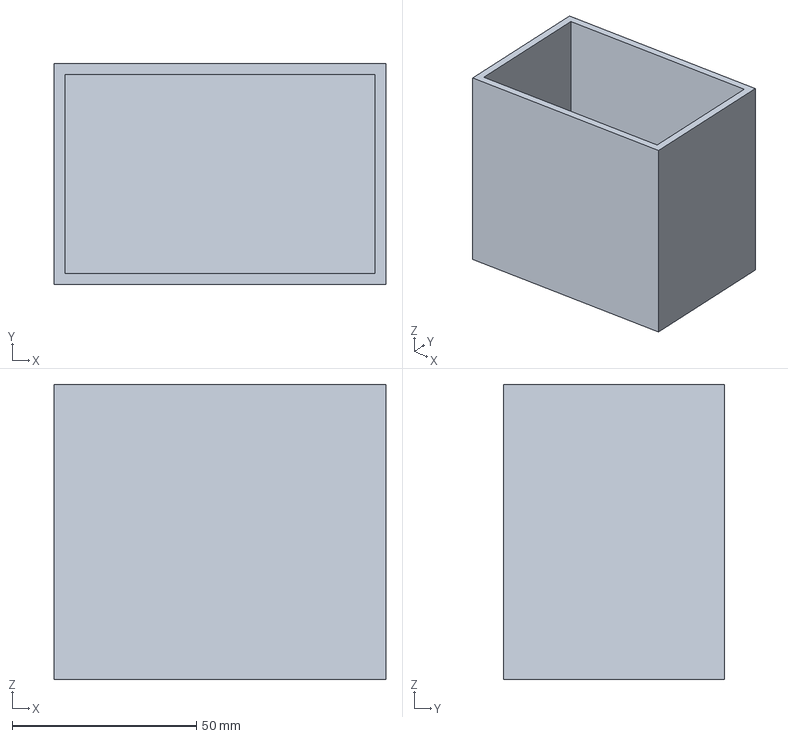
[picture p77: CAD file, 2026-10-22]
cad/step/sensing_chamber.step
90.0 x 60.0 x 80.0 mm
