saikoushiknalubola/firedamp-fd1/cad/step/sample_loop.step

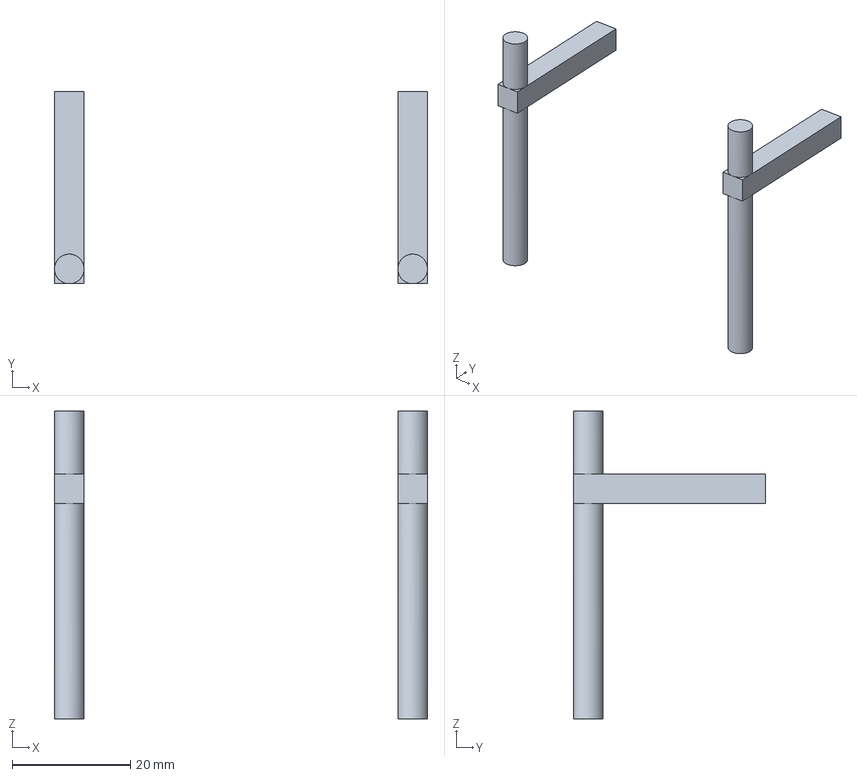
[picture p78: CAD file, 2026-10-22]
cad/step/sample_loop.step
63.0 x 32.5 x 52.0 mm
