saikoushiknalubola/firedamp-fd1/cad/step/stack_light.step

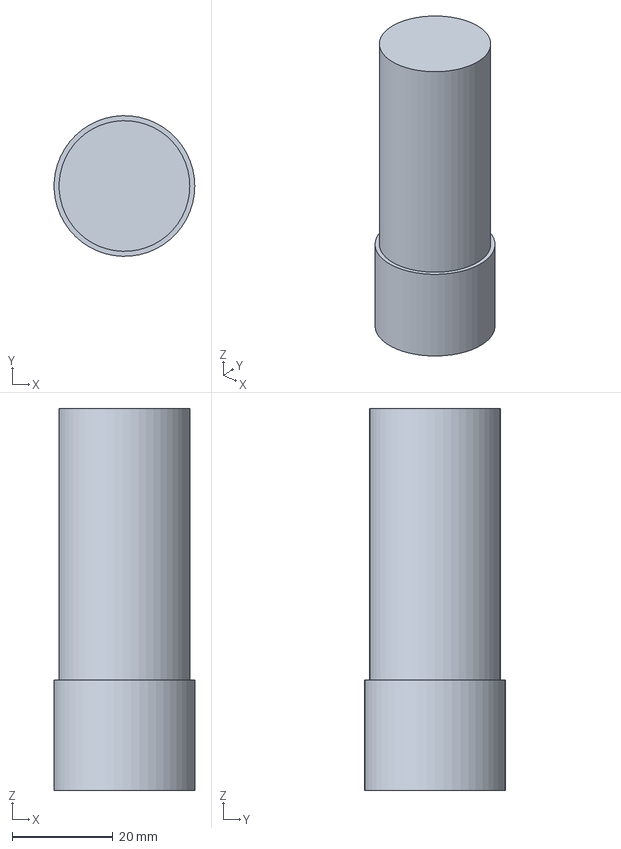
[picture p79: CAD file, 2026-10-22]
cad/step/stack_light.step
28.0 x 28.0 x 76.0 mm
