saikoushiknalubola/firedamp-fd1/cad/step/cable_glands.step

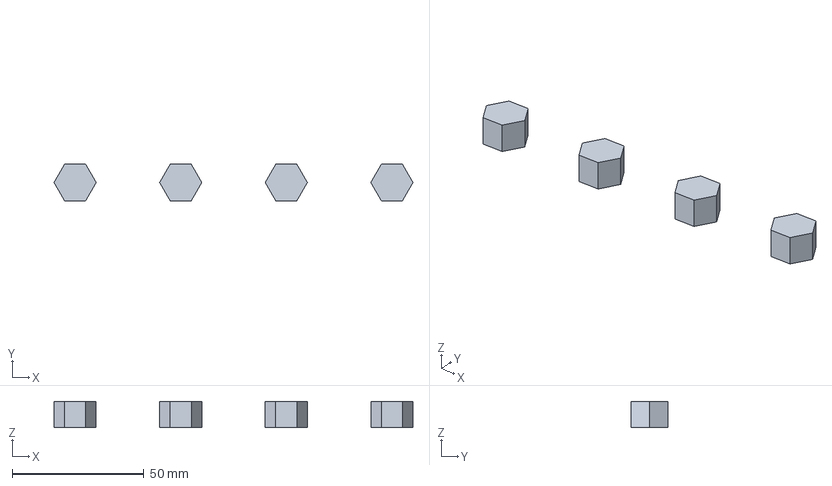
[picture p80: CAD file, 2026-10-22]
cad/step/cable_glands.step
136.0 x 13.9 x 10.0 mm
