saikoushiknalubola/firedamp-fd1/cad/step/condensate_trap.step

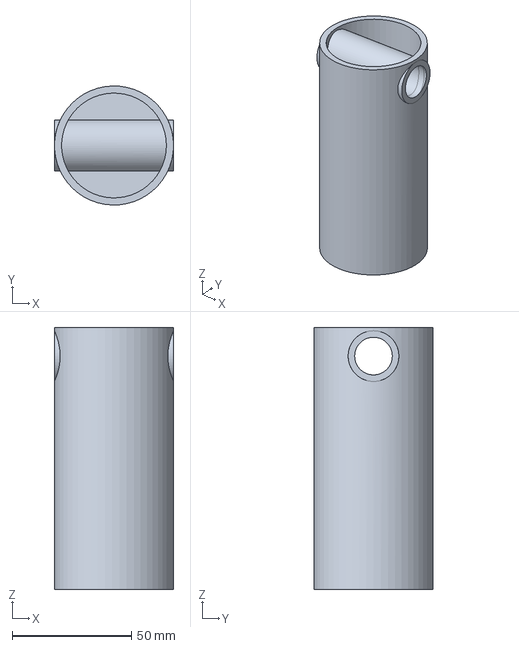
[picture p81: CAD file, 2026-10-22]
cad/step/condensate_trap.step
50.0 x 50.0 x 110.0 mm
