saikoushiknalubola/firedamp-fd1/cad/step/isolation_solenoid.step

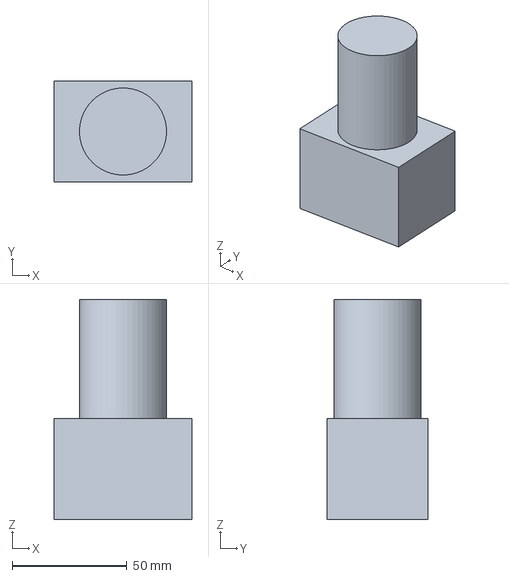
[picture p82: CAD file, 2026-10-22]
cad/step/isolation_solenoid.step
60.0 x 44.0 x 96.0 mm
