saikoushiknalubola/firedamp-fd1/cad/step/chamber_lid.step

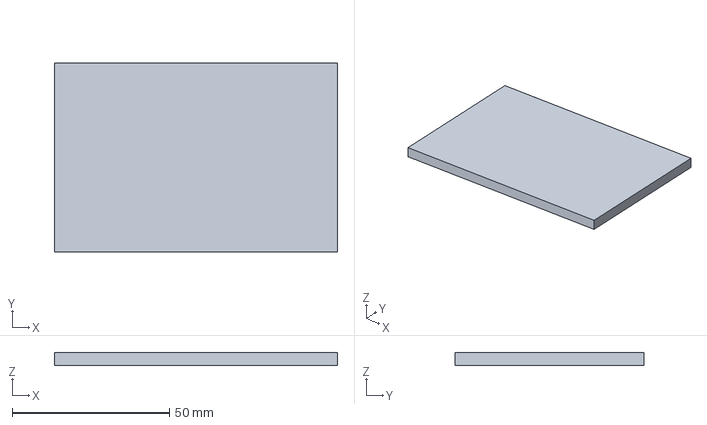
[picture p83: CAD file, 2026-10-22]
cad/step/chamber_lid.step
90.0 x 60.0 x 4.00 mm
