saikoushiknalubola/firedamp-fd1/cad/step/electronics_enclosure.step

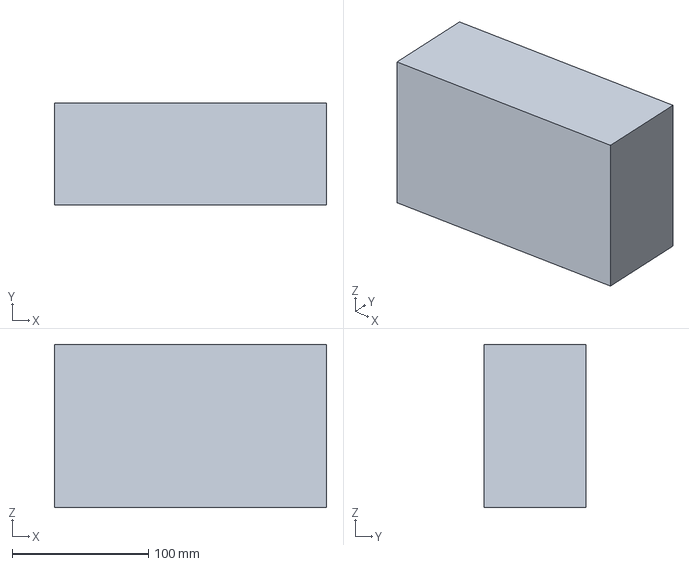
[picture p84: CAD file, 2026-10-22]
cad/step/electronics_enclosure.step
200.0 x 75.0 x 120.0 mm
