saikoushiknalubola/firedamp-fd1/(list of files, cad)

Other CAD files:
cad/step/FD1_assembly.step
cad/step/flange_downstream.step
cad/step/pipe_bracket_A.step
cad/step/u_bolts.step
cad/stl/backplate.stl
cad/stl/cable_glands.stl
cad/stl/ch4_ndir_sensor.stl
cad/stl/chamber_lid.stl
cad/stl/condensate_trap.stl
cad/stl/dp_taps.stl
cad/stl/drain_plug.stl
cad/stl/electronics_enclosure.stl
cad/stl/flange_downstream.stl
cad/stl/flange_upstream.stl
cad/stl/isolation_solenoid.stl
cad/stl/line_pipework.stl
cad/stl/o2_cell.stl
cad/stl/oled_window.stl
cad/stl/orifice_plate.stl
cad/stl/pipe_bracket_A.stl
cad/stl/pipe_bracket_B.stl
cad/stl/sample_loop.stl
cad/stl/sensing_chamber.stl
cad/stl/servo_bracket.stl
cad/stl/stack_light.stl
cad/stl/throttle_ball_valve.stl
cad/stl/throttle_servo.stl
cad/stl/u_bolts.stl
