saikoushiknalubola/firedamp-fd1/docs/photos/maker_fitting.jpg

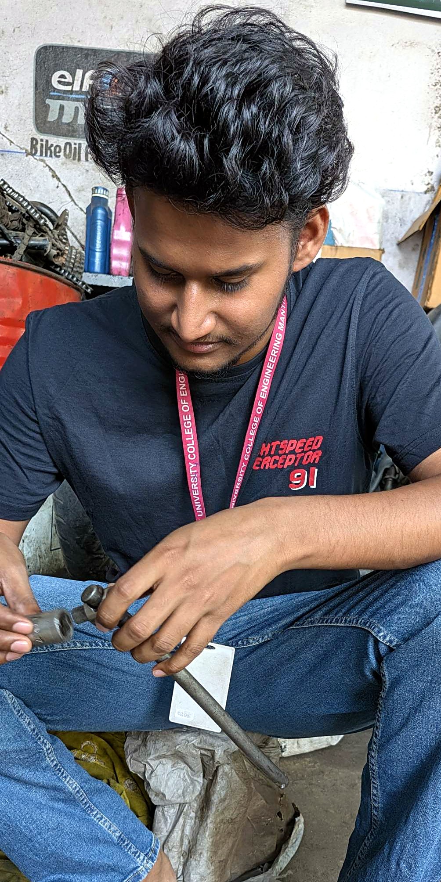
docs/photos/maker_fitting.jpg
