saikoushiknalubola/firedamp-fd1/docs/photos/maker_rig.jpg

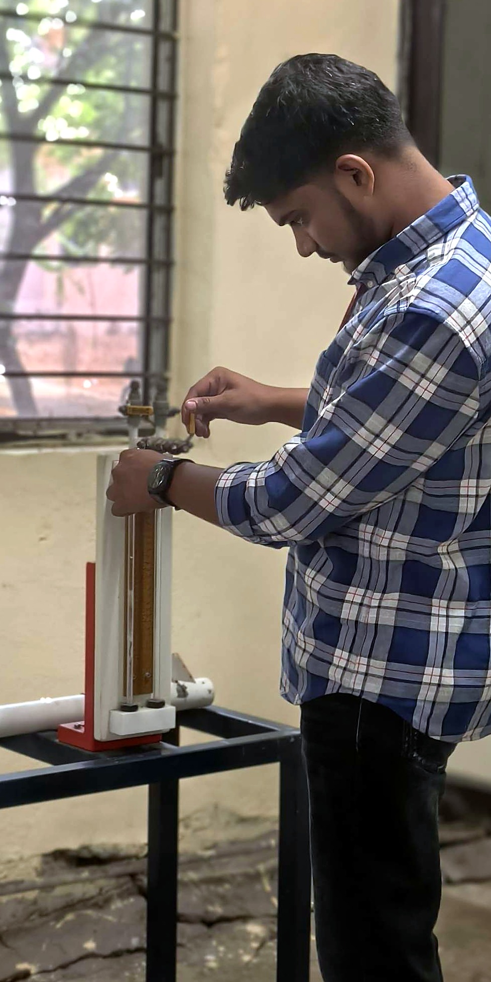
docs/photos/maker_rig.jpg
