saikoushiknalubola/firedamp-fd1/docs/photos/maker_solder_bench.jpg

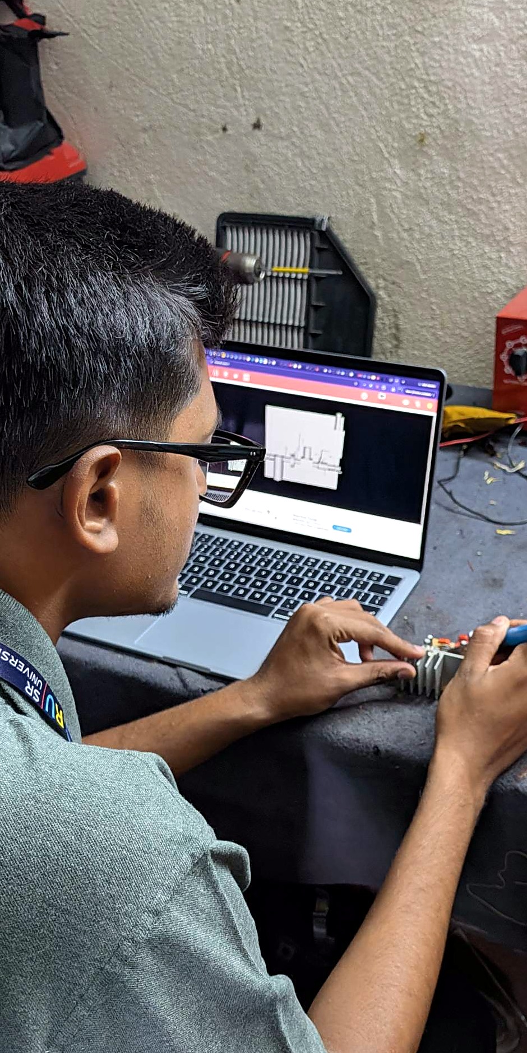
docs/photos/maker_solder_bench.jpg
