saikoushiknalubola/firedamp-fd1/electronics/kicad/fd1_controller.pdf

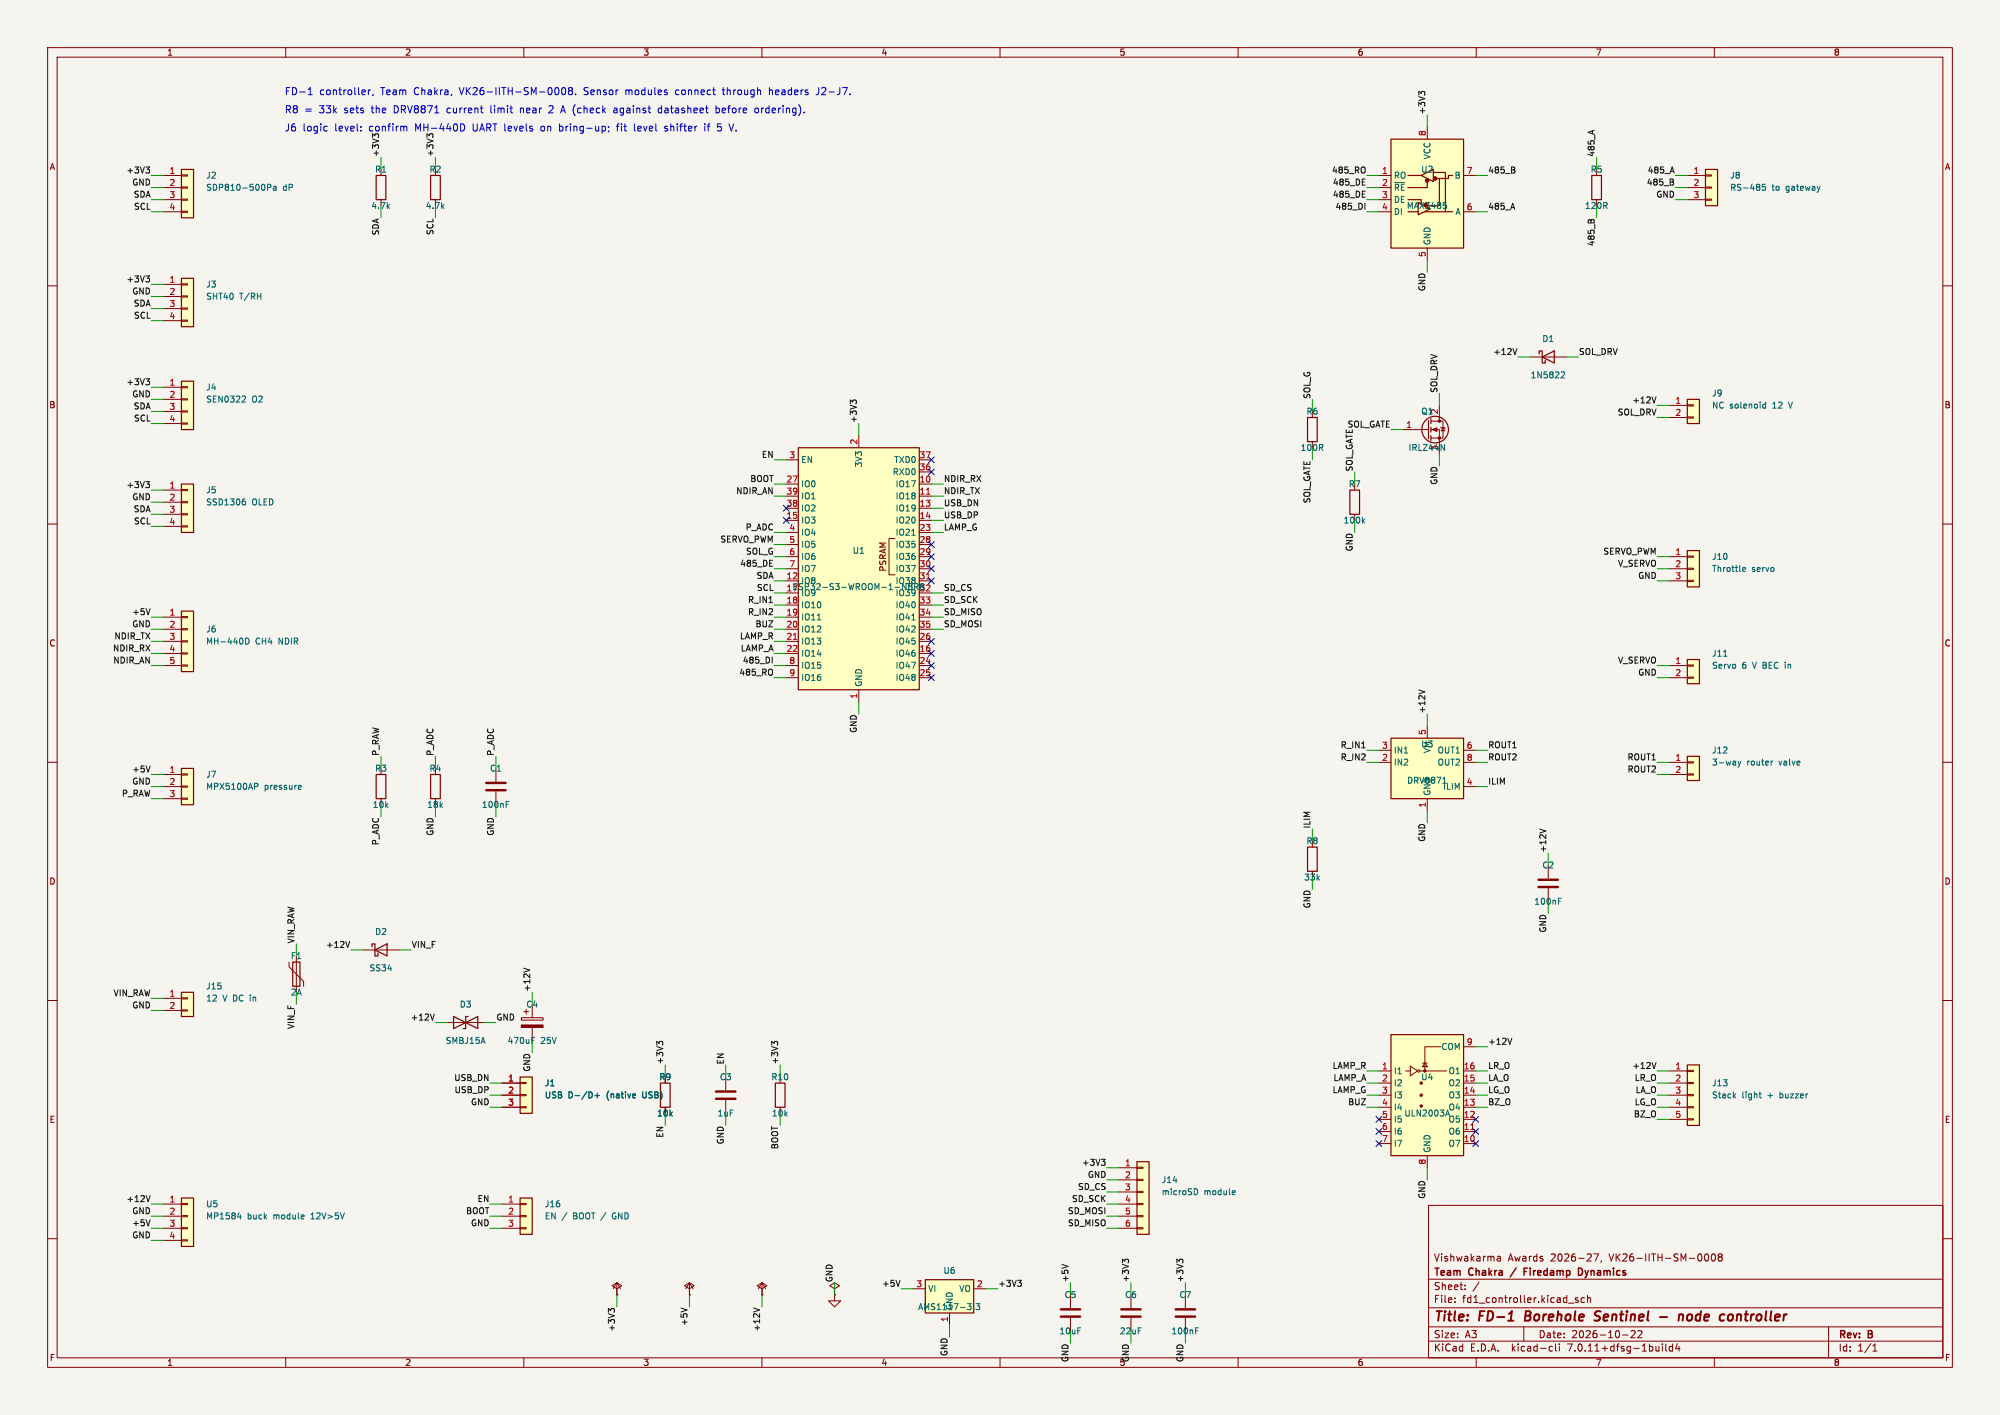
[picture p88: page 1]
