saikoushiknalubola/firedamp-fd1/(list of files, drawings)

Other design files:
electronics/kicad/fd1_controller.dsn
electronics/kicad/pcb_stats.json
