saikoushiknalubola/firedamp-fd1/electronics/kicad/fd1_controller.kicad_pcb

## KiCad design electronics/kicad/fd1_controller.kicad_pcb (2026-10-22)

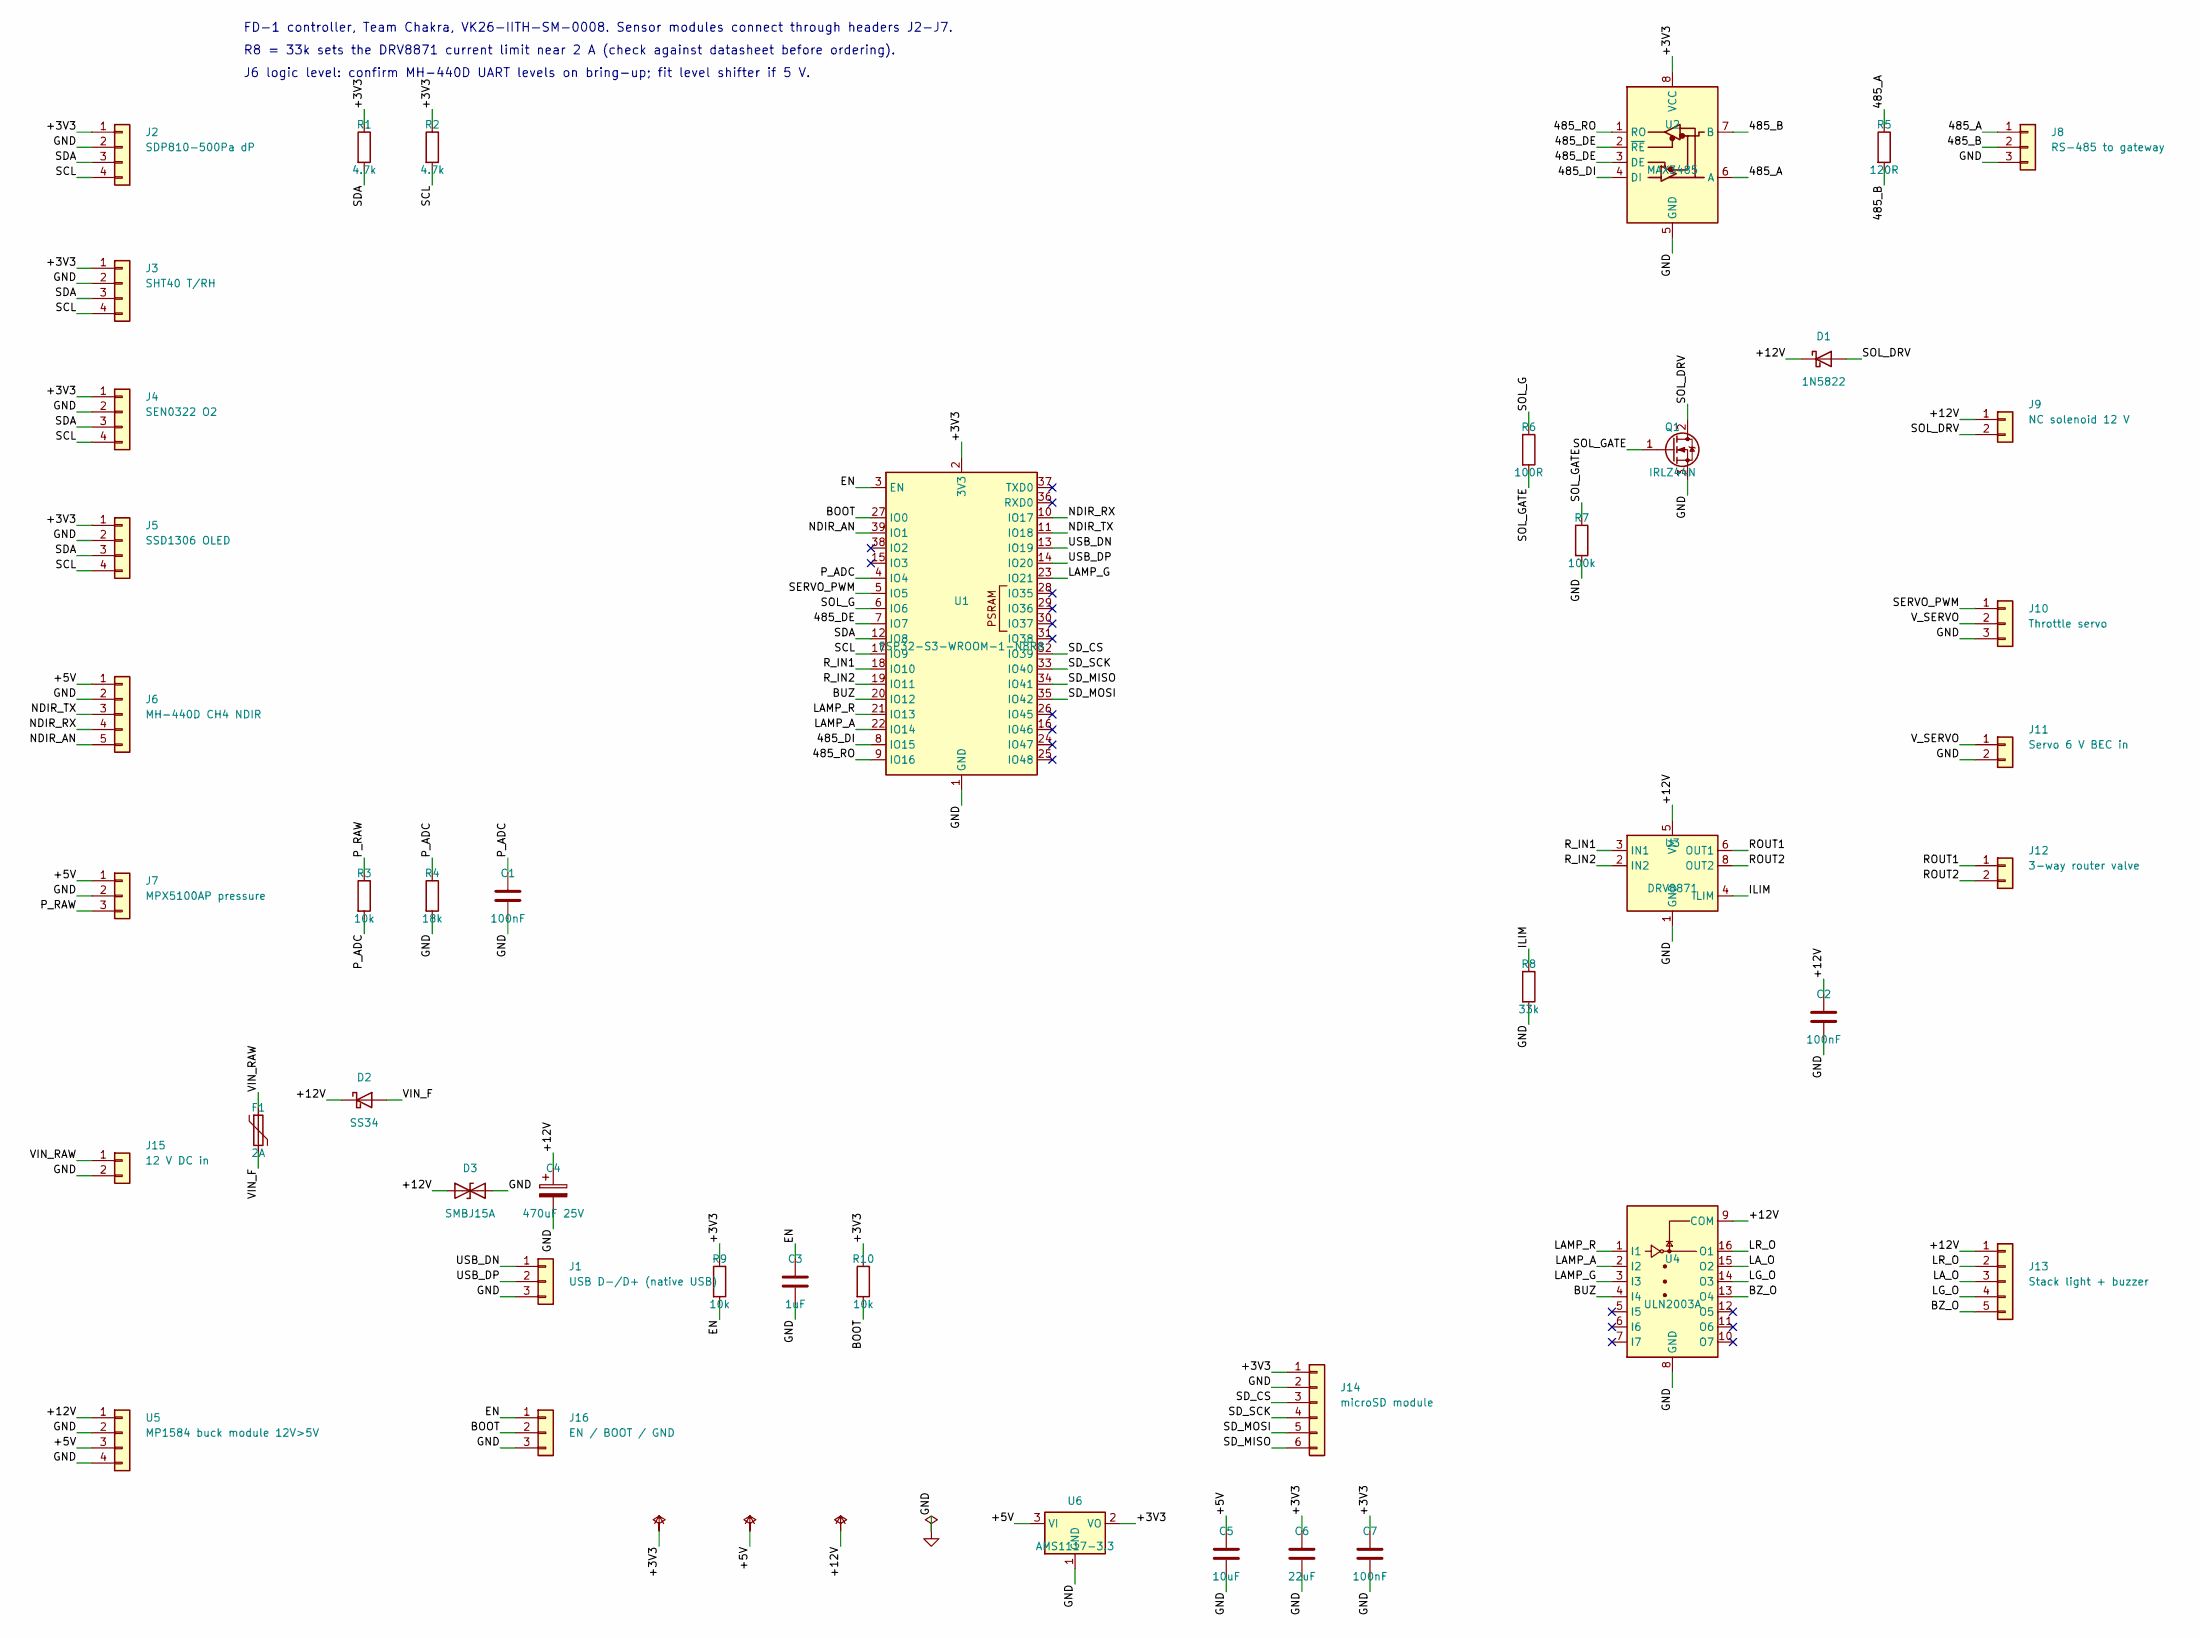
[picture p89: schematic fd1_controller.kicad_sch, FD-1 Borehole Sentinel - node controller]

Parts:
C1, C2, C7: 100nF; C_0805_2012Metric
C3: 1uF; C_0805_2012Metric
C4: 470uF 25V; CP_Radial_D10.0mm_P5.00mm
C5: 10uF; C_0805_2012Metric
C6: 22uF; C_0805_2012Metric
D1: 1N5822; D_DO-201AD_P15.24mm_Horizontal
D2: SS34; D_SMA
D3: SMBJ15A; D_SMB
F1: 2A; Fuse_1812_4532Metric
J1: USB D-/D+ (native USB); PinHeader_1x03_P2.54mm_Vertical
J2: SDP810-500Pa dP; PinHeader_1x04_P2.54mm_Vertical
J3: SHT40 T/RH; PinHeader_1x04_P2.54mm_Vertical
J4: SEN0322 O2; PinHeader_1x04_P2.54mm_Vertical
J5: SSD1306 OLED; PinHeader_1x04_P2.54mm_Vertical
J6: MH-440D CH4 NDIR; PinHeader_1x05_P2.54mm_Vertical
J7: MPX5100AP pressure; PinHeader_1x03_P2.54mm_Vertical
J8: RS-485 to gateway; TerminalBlock_bornier-3_P5.08mm
J9: NC solenoid 12 V; TerminalBlock_bornier-2_P5.08mm
J10: Throttle servo; PinHeader_1x03_P2.54mm_Vertical
J11: Servo 6 V BEC in; PinHeader_1x02_P2.54mm_Vertical
J12: 3-way router valve; TerminalBlock_bornier-2_P5.08mm
J13: Stack light + buzzer; PinHeader_1x05_P2.54mm_Vertical
J14: microSD module; PinHeader_1x06_P2.54mm_Vertical
J15: 12 V DC in; TerminalBlock_bornier-2_P5.08mm
J16: EN / BOOT / GND; PinHeader_1x03_P2.54mm_Vertical
Q1: IRLZ44N; TO-220-3_Vertical
R1, R2: 4.7k; R_0805_2012Metric
R3, R9, R10: 10k; R_0805_2012Metric
R4: 18k; R_0805_2012Metric
R5: 120R; R_0805_2012Metric
R6: 100R; R_0805_2012Metric
R7: 100k; R_0805_2012Metric
R8: 33k; R_0805_2012Metric
U1: ESP32-S3-WROOM-1-N8R8; ESP32-S3-WROOM-1
U2: MAX3485; SOIC-8_3.9x4.9mm_P1.27mm
U3: DRV8871; Texas_HTSOP-8-1EP_3.9x4.9mm_P1.27mm_EP2.95x4.9mm_Mask2.4x3.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
U4: ULN2003A; DIP-16_W7.62mm
U5: MP1584 buck module 12V>5V; PinHeader_1x04_P2.54mm_Vertical
U6: AMS1117-3.3; SOT-223-3_TabPin2

Connections:
485_A: J8.1, R5.1, U2.6 (A)
485_B: J8.2, R5.2, U2.7 (B)
485_DE: U1.7 (IO7), U2.2 (~RE), U2.3 (DE)
485_DI: U1.8 (IO15), U2.4 (DI)
485_RO: U1.9 (IO16), U2.1 (RO)
+3V3: C6.1, C7.1, J2.1, J3.1, J4.1, J5.1, J14.1, R1.1, R2.1, R9.1, R10.1, U1.2 (3V3), U2.8 (VCC), U6.2 (VO)
+5V: C5.1, J6.1, J7.1, U5.3, U6.3 (VI)
+12V: C2.1, C4.1, D1.1 (K), D2.1 (K), D3.1 (A1), J9.1, J13.1, U3.5 (VM), U4.9 (COM), U5.1
BOOT: J16.2, R10.2, U1.27 (IO0)
BUZ: U1.20 (IO12), U4.4 (I4)
BZ_O: J13.5, U4.13 (O4)
EN: C3.1, J16.1, R9.2, U1.3 (EN)
GND: C1.2, C2.2, C3.2, C4.2, C5.2, C6.2, C7.2, D3.2 (A2), J1.3, J2.2, J3.2, J4.2, J5.2, J6.2, J7.2, J8.3, J10.3, J11.2, J14.2, J15.2, J16.3, Q1.3 (S), R4.2, R7.2, R8.2, U1.1 (GND), U1.40 (GND), U1.41 (GND), U2.5 (GND), U3.1 (GND), U3.7 (GND), U3.9 (GND), U4.8 (GND), U5.2, U5.4, U6.1 (GND)
ILIM: R8.1, U3.4 (ILIM)
LAMP_A: U1.22 (IO14), U4.2 (I2)
LAMP_G: U1.23 (IO21), U4.3 (I3)
LAMP_R: U1.21 (IO13), U4.1 (I1)
LA_O: J13.3, U4.15 (O2)
LG_O: J13.4, U4.14 (O3)
LR_O: J13.2, U4.16 (O1)
NDIR_AN: J6.5, U1.39 (IO1)
NDIR_RX: J6.4, U1.10 (IO17)
NDIR_TX: J6.3, U1.11 (IO18)
P_ADC: C1.1, R3.2, R4.1, U1.4 (IO4)
P_RAW: J7.3, R3.1
ROUT1: J12.1, U3.6 (OUT1)
ROUT2: J12.2, U3.8 (OUT2)
R_IN1: U1.18 (IO10), U3.3 (IN1)
R_IN2: U1.19 (IO11), U3.2 (IN2)
SCL: J2.4, J3.4, J4.4, J5.4, R2.2, U1.17 (IO9)
SDA: J2.3, J3.3, J4.3, J5.3, R1.2, U1.12 (IO8)
SD_CS: J14.3, U1.32 (IO39)
SD_MISO: J14.6, U1.34 (IO41)
SD_MOSI: J14.5, U1.35 (IO42)
SD_SCK: J14.4, U1.33 (IO40)
SERVO_PWM: J10.1, U1.5 (IO5)
SOL_DRV: D1.2 (A), J9.2, Q1.2 (D)
SOL_G: R6.1, U1.6 (IO6)
SOL_GATE: Q1.1 (G), R6.2, R7.1
USB_DN: J1.1, U1.13 (IO19)
USB_DP: J1.2, U1.14 (IO20)
VIN_F: D2.2 (A), F1.2
VIN_RAW: F1.1, J15.1
V_SERVO: J10.2, J11.1

Notes on the sheet:
FD-1 controller, Team Chakra, VK26-IITH-SM-0008. Sensor modules connect through headers J2-J7.
R8 = 33k sets the DRV8871 current limit near 2 A (check against datasheet before ordering).
J6 logic level: confirm MH-440D UART levels on bring-up; fit level shifter if 5 V.

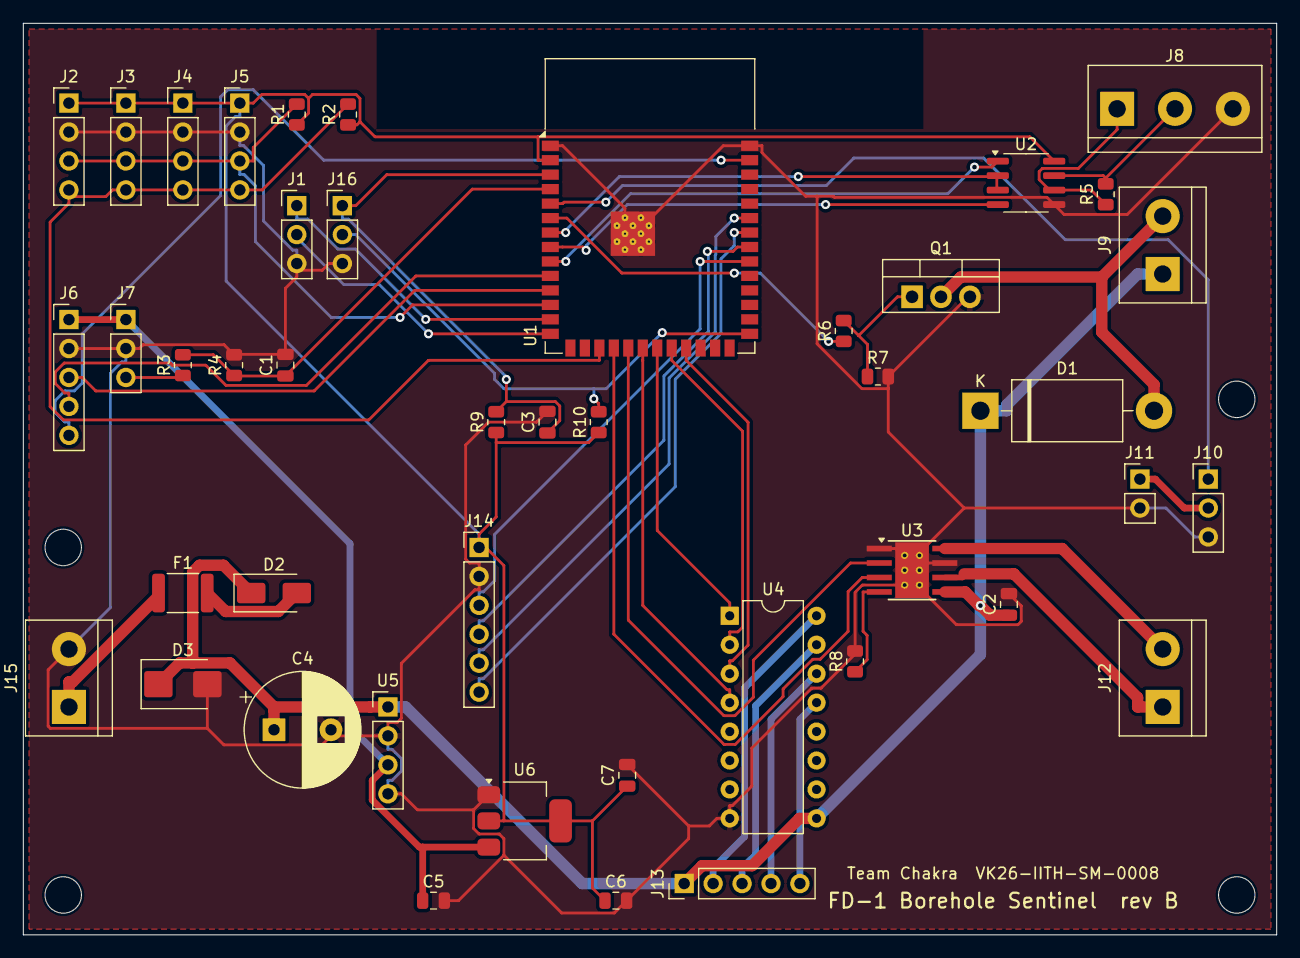
[picture p90: board fd1_controller.kicad_pcb from above]

Board: 2 copper layers, 110.0 x 80.0 mm, 48 parts (0 on the bottom side), 44 nets.

Other parts of the board:
H1, H2, H3, H4: MountingHole_3.2mm_M3
