saikoushiknalubola/firedamp-fd1/(commit log)

2026-10-22 Add complete Firedamp project
    [FD1_assembly.step, backplate.step, backplate.stl, bom.csv, cable_glands.step, cable_glands.stl, ch4_ndir_sensor.step, ch4_ndir_sensor.stl]
2026-10-22 Stage 2: KiCad schematic, rev B bracket, research figures, sources, patent notes, deck
    Claude-Session: https://claude.ai/code/session_01Vz7JfuGgWMU6CCjesC947p
    [FD1_assembly.step, backplate.step, cable_glands.step, ch4_ndir_sensor.step, chamber_lid.step, condensate_trap.step, connections.csv, dp_taps.step]
2026-10-22 PCB layout + DRC, low-cost BOM with price basis, team names, deck v3
    - electronics/kicad: routed 2-layer PCB (110x80 mm), DRC 0 errors, renders, stats
    - electronics/bom.py: Stage 3 build Rs 48,400 with a price source per line
    - docs: sources, references, glossary; README updated
    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
    [bom.csv, fd1_controller.dsn, fd1_controller.kicad_pcb, fd1_controller.kicad_sch, pcb_stats.json]
2026-10-22 Deck: student-led team, full-team photo slot instead of faculty review
    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
2026-10-24 CAD: single-file full assembly (STL + coloured GLB) for online viewers
    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
    [FD1_full_assembly.stl]
